JoonatanAlanampa/koti/docs/img/ds3231-bottom.jpg

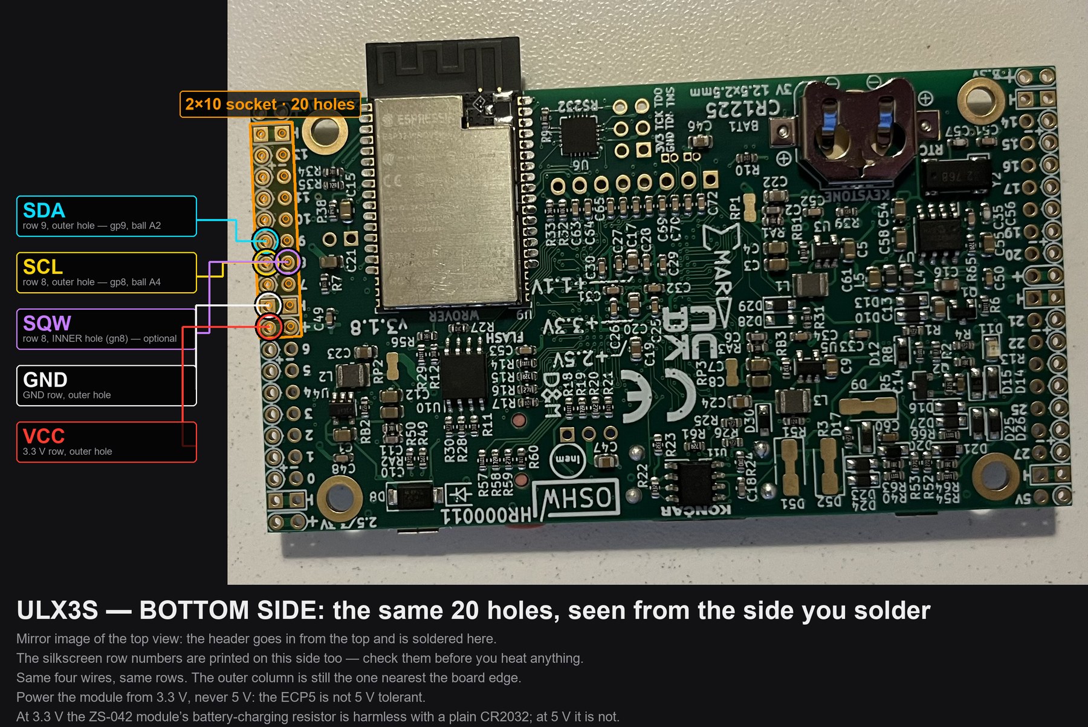
docs/img/ds3231-bottom.jpg
