JoonatanAlanampa/koti/docs/img/ds3231-top.jpg

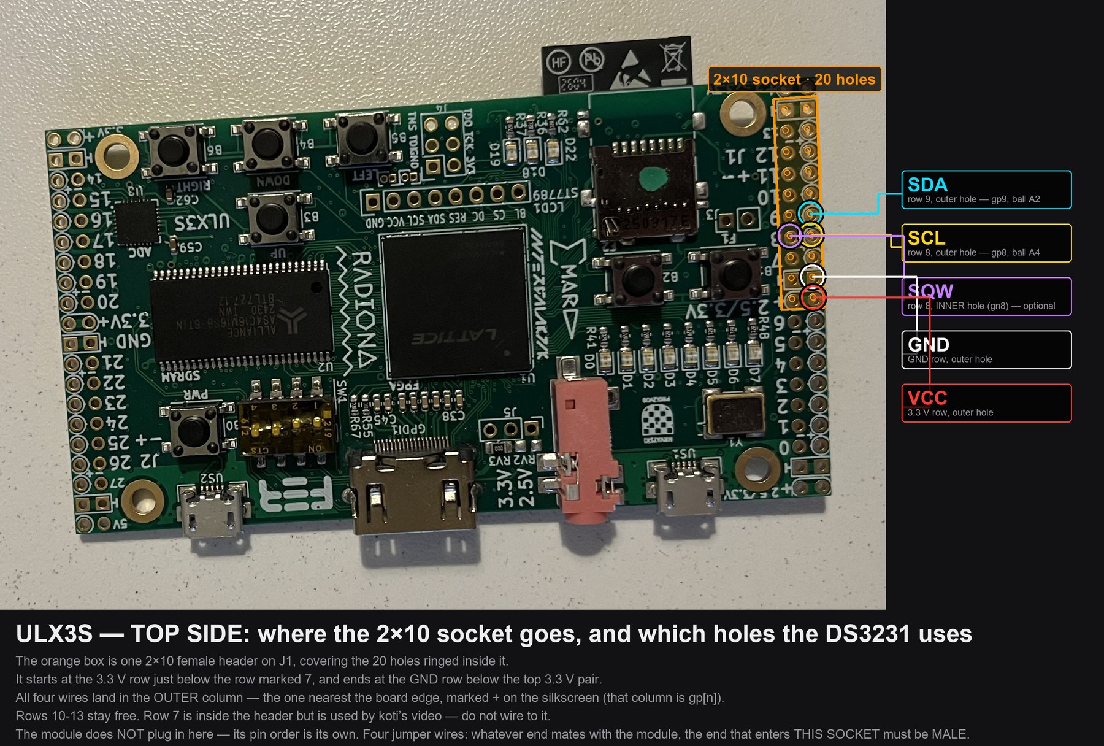
docs/img/ds3231-top.jpg
