JoonatanAlanampa/koti/src/koti_core.sv

// koti_core.sv — the Koti-1 ASIC core: RV32IMA + Zicsr + M-mode traps
// on the XIP memory interface. Merges the two proven lineages:
//   - fetch FSM + external data port + MMIO from tt-riscv's
//     rv32_core.sv (non-blocking pair fetch with skid buffer, fdrop on
//     redirect, whole-pipe freeze on data-port waits)
//   - muldiv, csr/trap, and AMO machinery from core/cpu_pipe.sv (which
//     stays behind as the FPGA/BRAM reference build)
//
// Memory map: flash 0x0000_0000+ (code+rodata, addr bit 24 = 0),
// PSRAM 0x0100_0000+ (bit 24 = 1). Core-internal MMIO carve-out at
// 0x0001_0000: +0 LED (w), +4 UART (w data / r busy), +8 GPIO in (r),
// +C QSPI_CFG (r/w). Anything else non-flash/PSRAM-shaped (CLINT at
// 0x0002_0000, PLIC, VGA regs) goes out the data port for the SoC top
// to decode and ack — the port protocol doesn't care who answers.
//
// Copyright (c) 2026 Joonatan Alanampa
// SPDX-License-Identifier: Apache-2.0

`default_nettype none

module koti_core #(
    parameter UART_DIV = 217
) (
    input  logic        clk,
    input  logic        rst,
    input  logic        mtip, msip, meip,
    input  logic        seip,       // S-level external, from the PLIC
    output logic        halted,
    output logic [7:0]  led,
    output logic        uart_txd,
    // ⭐ THE OTHER HALF, added 2026-08-09. Before this the console was
    // transmit-only and nothing could ever be typed at koti over a wire.
    input  wire         uart_rxd,
    input  logic [7:0]  gpio_in,
    output logic [1:0]  qspi_cfg,   // MMIO +C; resets 0 = 1-bit SPI

    // instruction fetch port (req held until 1-cycle ack); each fetch
    // returns an instruction PAIR: if_rdata = @addr, if_rdata2 = @addr+4
    output logic        if_req,
    output logic [23:0] if_addr,
    input  logic        if_ack,
    input  logic [31:0] if_rdata,
    input  logic [31:0] if_rdata2,

    // Fetch-port side-channels for an optional instruction cache (see
    // src/icache.sv). Both are pure observations of state this core already
    // keeps, so leaving them unconnected costs nothing.
    //   if_ptw       1 while the transaction on the fetch port is a PAGE TABLE
    //                read rather than an instruction fetch. A cache must not
    //                retain those: page tables are edited through the data port
    //                and retired by sfence.vma, which a physically-tagged
    //                instruction cache correctly does not flush on.
    //   icache_flush one cycle when a `fence.i` retires.
    output logic        if_ptw,
    output logic        icache_flush,

    //   d_ptw        the same thing for the DATA port: 1 while the transaction
    //                belongs to the EX-side page walker rather than to a load
    //                or a store. A data cache must not retain a PTE for exactly
    //                the reason above — page tables are retired by sfence.vma,
    //                which a physically-tagged cache correctly does not flush
    //                on, so a cached PTE would outlive the flush meant to kill
    //                it and the machine would translate through a stale entry.
    //                The walker only ever READS, so bypassing reads is enough.
    output logic        d_ptw,

    // data port (same protocol)
    output logic        d_req,
    output logic        d_we,
    output logic [23:0] d_addr,
    output logic [31:0] d_wdata,
    output logic [3:0]  d_be,
    input  logic        d_ack,
    input  logic [31:0] d_rdata
);

    // ---- forward declarations ----------------------------------------
    // Every signal below is used above the point it was originally
    // declared. Icarus 12 tolerated that; Icarus 14 does not ("Unable to
    // bind ... Check for declaration after use"), which meant koti's
    // simulations could not run on the oss-cad-suite toolchain installed
    // here AT ALL - every debug cycle had to go through a 14-minute CI
    // round trip. Declaring them here and leaving each expression exactly
    // where it was changes no logic.
    logic [19:0] dw_vpn;
    logic [19:0] iw_vpn;
    logic [4:0]  rs1_e, rs2_e, rd_e;
    wire        dw_fill;
    wire        dw_pte_fault;
    wire        iw_fill;
    wire        iw_pte_fault;
    wire [21:0] dw_fppn;
    wire [21:0] iw_fppn;
    wire [31:0] dpte;
    wire [31:0] ipte;
    wire [31:0] mem_word;

    // ================= F: fetch FSM + ITLB / i-walker =================
    logic [31:0] instr_d, pc_d;          // IF/ID
    logic        valid_d, ipf_d;         // ipf: poisoned fetch, traps at EX

    logic        stall, flush_ex;        // defined in D/E below
    logic        mstall;                 // data-port wait, defined in M below
    logic        md_stall;               // muldiv wait, defined in E below
    logic        astall;                 // AMO RMW wait, defined in M below
    logic        tlb_stall;              // DTLB walk wait, defined in E below
    wire         pstall = mstall || md_stall || astall || tlb_stall;
    logic [31:0] target_ex;
    logic        tlb_flush;              // sfence.vma / satp write (EX)
    logic        m_port_busy;            // M owns the data port (M below)
    // Who owns the data transaction currently in flight. Forward-declared
    // here because both consumers of it sit hundreds of lines apart and this
    // file is read by a simulator that rejects declare-after-use.
    logic        d_inflight, d_owner_dw;

    // MMU context from csr0 (instance in EX)
    logic [31:0] csr_satp;
    logic [1:0]  csr_priv;
    logic        csr_sum, csr_mxr;
    wire mmu_i_on = csr_satp[31] && csr_priv != 2'b11;

    logic        fbusy, fdrop;
    logic [31:0] fpc;                    // VA of the in-flight fetch
    logic [31:0] fpc_pa;                 // its translation (= fpc when off)
    logic [31:0] npc;                    // next VA to fetch
    logic [31:0] fbuf;                   // skid: second word of the pair
    logic        fbuf_v;

    // ITLB: looked up on npc while idle
    wire [19:0] i_vpn = npc[31:12];
    logic        itlb_hit;
    logic [21:0] itlb_ppn;
    logic        itlb_r, itlb_w, itlb_x, itlb_u, itlb_pd, itlb_f;
    tlb #(.N(2)) itlb0 (
        .clk(clk), .rst(rst), .flush(tlb_flush),
        .vpn(i_vpn), .hit(itlb_hit), .ppn(itlb_ppn),
        .p_r(itlb_r), .p_w(itlb_w), .p_x(itlb_x), .p_u(itlb_u),
        .p_d(itlb_pd), .p_fault(itlb_f),
        .fill(iw_fill), .f_vpn(iw_vpn), .f_ppn(iw_fppn),
        .f_r(ipte[1]), .f_w(ipte[2]), .f_x(ipte[3]), .f_u(ipte[4]),
        .f_d(ipte[7]), .f_fault(iw_pte_fault));

    // execute permission at current privilege (S never runs U pages)
    wire itlb_xfault = itlb_f || !itlb_x
                    || (csr_priv == 2'b00 && !itlb_u)
                    || (csr_priv == 2'b01 &&  itlb_u);

    // i-walker: two PTE reads through the fetch port (pair's first word).
    // Fills are path-independent, so a redirect mid-walk needs no abort:
    // the walk completes against its latched vpn and simply fills.
    logic [1:0]  iw_state;               // 0 idle, 1 level-1, 2 level-0
    logic [23:0] iw_addr;

    assign if_req  = fbusy || (iw_state != 2'd0);
    assign if_addr = (iw_state != 2'd0) ? iw_addr : fpc_pa[25:2];

    // Stable for the whole of any one transaction: a walk can only be started
    // from `iw_state == 0 && !fbusy`, and iw_state only advances on `if_ack`.
    assign if_ptw  = (iw_state != 2'd0);

    assign ipte = if_rdata;
    wire        ipte_bad = !ipte[0] || (!ipte[1] && ipte[2]);   // !V, W&!R
    wire        ipte_leaf = ipte[1] || ipte[3];                 // R or X
    wire        iw_l1 = if_ack && iw_state == 2'd1;
    wire        iw_l0 = if_ack && iw_state == 2'd2;
    assign iw_pte_fault = ipte_bad
                    || (iw_l1 && ipte_leaf && ipte[19:10] != 10'd0)
                    || (iw_l0 && !ipte_leaf)
                    || (ipte_leaf && !ipte[6]);                 // A = 0
    assign iw_fill = (iw_l1 && (ipte_bad || ipte_leaf)) || iw_l0;
    assign iw_fppn = iw_l1 ? {ipte[31:20], iw_vpn[9:0]}    // megapage
                                : ipte[31:10];

    wire advance = !halted && !pstall;
    wire consume = advance && valid_d && !stall && !flush_ex;

    always_ff @(posedge clk)
        if (rst) begin
            fbusy <= 1'b0; fdrop <= 1'b0;
            fpc   <= 32'd0; fpc_pa <= 32'd0; npc <= 32'd0;
            fbuf  <= 32'd0; fbuf_v <= 1'b0;
            valid_d <= 1'b0; pc_d <= 32'd0; instr_d <= 32'd0;
            ipf_d <= 1'b0;
            iw_state <= 2'd0; iw_vpn <= 20'd0; iw_addr <= 24'd0;
        end else begin
            if (consume) begin
                if (fbuf_v) begin       // promote the pair's second word
                    instr_d <= fbuf;
                    pc_d    <= pc_d + 32'd4;
                    fbuf_v  <= 1'b0;    // valid_d stays 1: no bubble
                end else
                    valid_d <= 1'b0;
            end

            if (iw_l1) begin
                if (ipte_bad || ipte_leaf)
                    iw_state <= 2'd0;   // filled (translation or fault)
                else begin
                    iw_addr  <= {ipte[23:10], iw_vpn[9:0]};   // level-0 PTE
                    iw_state <= 2'd2;
                end
            end else if (iw_l0)
                iw_state <= 2'd0;

            if (if_ack && iw_state == 2'd0) begin
                // a fetch is only in flight while head+skid are empty, so
                // delivery never collides with consume/promote
                fbusy <= 1'b0;
                fdrop <= 1'b0;
                if (!fdrop) begin
                    instr_d <= if_rdata;
                    pc_d    <= fpc;
                    valid_d <= 1'b1;
                    ipf_d   <= 1'b0;
                    fbuf    <= if_rdata2;
                    // A pair straddling a page boundary carries the wrong
                    // translation for its second word, so the second word is
                    // dropped. THEN npc MUST STEP BY ONE WORD, NOT TWO --
                    // otherwise the dropped instruction is never fetched at
                    // all and the machine silently executes fpc, then fpc+8.
                    //
                    // That was the bug that stopped Linux booting (found
                    // 2026-08-04). `npc <= fpc + 8` was unconditional, so
                    // every straddling pair skipped an instruction outright.
                    // It survived this long because npc normally steps by 8,
                    // which never changes fpc[2] -- so a straddle needs a
                    // fetch stream that is ODD-word aligned (fpc == 4 mod 8),
                    // which only happens after a redirect to a 4-mod-8 target
                    // that then runs to the end of its page. Linux hits it in
                    // kfree(): the retry edge is `jal zero,kfree+0xfc` and
                    // that target is 0x...ffc, the last word of a page, so
                    // EVERY pass dropped the next instruction -- the `lw a3,
                    // 4(a4)` that loads the SLUB tid. a3 kept a stale value,
                    // the tid compare in __update_cpu_freelist_fast could
                    // never match, and kfree spun forever with the console
                    // silent after "SLUB: HWalign=64".
                    //
                    // Invisible to every existing suite: it needs the MMU on
                    // (the 58 official tests run with satp = 0, where
                    // mmu_i_on is false and nothing is ever dropped) AND a
                    // 4-mod-8 entry that reaches a page end AND the skipped
                    // instruction to matter.
                    if (mmu_i_on && fpc[11:2] == 10'h3FF) begin
                        fbuf_v <= 1'b0;
                        npc    <= fpc + 32'd4;
                    end else begin
                        fbuf_v <= 1'b1;
                        npc    <= fpc + 32'd8;
                    end
                end
            end else if (iw_state == 2'd0 && !fbusy && !valid_d && !fbuf_v
                         && !halted && !pstall && !flush_ex) begin
                // !flush_ex: a redirect lands this same edge and rewrites
                // npc — starting now would fetch the stale wrong-path npc
                // (see rv32_core.sv for the full war story)
                // !pstall: never launch a fetch/ITLB walk while an older
                // stage is stalled — a satp write held behind a bus txn
                // could otherwise start an old-root walk that outlives the
                // flush at its commit edge (F2).
                if (!mmu_i_on) begin
                    fbusy <= 1'b1; fpc <= npc; fpc_pa <= npc;
                end else if (itlb_hit && !itlb_xfault) begin
                    fbusy  <= 1'b1; fpc <= npc;
                    fpc_pa <= {itlb_ppn[19:0], npc[11:0]};
                end else if (itlb_hit) begin
                    // execute fault: poison one NOP; EX takes the trap
                    instr_d <= 32'h0000_0013;
                    pc_d    <= npc;
                    valid_d <= 1'b1;
                    ipf_d   <= 1'b1;
                end else begin
                    iw_vpn   <= i_vpn;
                    iw_addr  <= {csr_satp[13:0], i_vpn[19:10]};
                    iw_state <= 2'd1;
                end
            end

            // redirect last: overrides a same-cycle delivery/promotion
            if (advance && flush_ex) begin
                valid_d <= 1'b0;
                ipf_d   <= 1'b0;
                fbuf_v  <= 1'b0;
                npc     <= target_ex;
                if (fbusy && !if_ack) fdrop <= 1'b1;
            end
        end

    // ================= D: decode + regfile read =================
    wire [4:0] rs1_d = instr_d[19:15];
    wire [4:0] rs2_d = instr_d[24:20];
    wire [4:0] rd_d  = instr_d[11:7];

    logic       c_reg_write, c_alu_b_src, c_mem_write, c_is_branch, c_is_jump;
    logic       c_is_md, c_is_sys, c_is_amo;
    logic [2:0] c_imm_sel;
    logic [1:0] c_alu_a_src, c_wb_src;
    logic [3:0] c_alu_op;
    control ctl (.opcode(instr_d[6:0]), .funct3(instr_d[14:12]),
                 .funct7b5(instr_d[30]), .funct7b0(instr_d[25]),
                 .is_muldiv(c_is_md), .is_amo(c_is_amo),
                 .reg_write(c_reg_write), .imm_sel(c_imm_sel),
                 .alu_a_src(c_alu_a_src), .alu_b_src(c_alu_b_src),
                 .alu_op(c_alu_op), .mem_write(c_mem_write), .wb_src(c_wb_src),
                 .is_branch(c_is_branch), .is_jump(c_is_jump),
                 .is_system(c_is_sys));

    // SYSTEM sub-decode (needs instr[31:20], which control never sees).
    // EBREAK halts the core in M-mode and TRAPS in S/U (see brk_take below);
    // ECALL traps (it is the SBI path); WFI and unknown SYSTEM encodings
    // are NOPs.
    wire [11:0] sys12 = instr_d[31:20];
    wire is_csr_d    = c_is_sys && instr_d[14:12] != 3'b000;
    wire is_ecall_d  = c_is_sys && instr_d[14:12] == 3'b000 && sys12 == 12'h000;
    wire is_ebreak_d = c_is_sys && instr_d[14:12] == 3'b000 && sys12 == 12'h001;
    wire is_mret_d   = c_is_sys && instr_d[14:12] == 3'b000 && sys12 == 12'h302;
    wire is_sret_d   = c_is_sys && instr_d[14:12] == 3'b000 && sys12 == 12'h102;
    wire is_sfence_d = c_is_sys && instr_d[14:12] == 3'b000
                     && instr_d[31:25] == 7'b0001001;   // sfence.vma

    // FENCE.I (MISC-MEM opcode, funct3=001). This was a NOP for as long as
    // nothing sat between the fetch port and memory, and harmlessly so. With
    // src/icache.sv in the path it becomes the instruction that makes code
    // written through the DATA port executable — a bootloader staging a kernel,
    // a module loader, a JIT — because a fetch-side cache cannot see those
    // stores. RISC-V puts that burden on software precisely so the hardware can
    // stay this simple, but only if the hardware honours the instruction.
    //
    // NOT privileged: legal in U-mode, unlike sfence.vma. So it gets its own
    // path rather than joining sfence_e, whose privilege check would trap it.
    wire is_fencei_d = instr_d[6:0] == 7'b0001111 && instr_d[14:12] == 3'b001;

    // instruction legality (coarse but covers what kernels probe:
    // unknown major opcodes, bad funct3/funct7 combos, bad SYSTEM
    // encodings; CSR existence/privilege is checked at EX)
    logic legal_d;
    always_comb begin
        legal_d = 1'b0;
        case (instr_d[6:0])
            7'b0110111, 7'b0010111, 7'b1101111: legal_d = 1'b1;  // U/J
            7'b1100111: legal_d = instr_d[14:12] == 3'b000;      // JALR
            7'b1100011: legal_d = instr_d[14:12] != 3'b010
                               && instr_d[14:12] != 3'b011;      // Bxx
            7'b0000011: legal_d = instr_d[14:12] <= 3'd2
                               || instr_d[14:12] == 3'd4
                               || instr_d[14:12] == 3'd5;        // loads
            7'b0100011: legal_d = instr_d[14:12] <= 3'd2;        // stores
            7'b0010011: legal_d =
                  (instr_d[14:12] == 3'b001) ? instr_d[31:25] == 7'd0
                : (instr_d[14:12] == 3'b101) ? (instr_d[31:25] == 7'd0
                                             || instr_d[31:25] == 7'h20)
                : 1'b1;                                          // OP-IMM
            7'b0110011: legal_d = instr_d[31:25] == 7'd0
                               || instr_d[31:25] == 7'h01
                               || (instr_d[31:25] == 7'h20
                                   && (instr_d[14:12] == 3'b000
                                    || instr_d[14:12] == 3'b101)); // OP/M
            7'b0001111: legal_d = 1'b1;                          // FENCE
            7'b0101111: legal_d = instr_d[14:12] == 3'b010
                && (instr_d[31:27] <= 5'd4 || instr_d[31:27] == 5'd8
                    || instr_d[31:27] == 5'd12
                    || (instr_d[31] && instr_d[28:27] == 2'b00)); // A
            7'b1110011: legal_d = (instr_d[14:12] != 3'b000
                                && instr_d[14:12] != 3'b100)     // CSRs
                || is_ecall_d || is_ebreak_d || is_mret_d
                || is_sret_d || is_sfence_d
                || sys12 == 12'h105;                             // WFI
            default: ;
        endcase
    end

    logic [31:0] imm_d;
    immgen ig (.instr(instr_d), .sel(c_imm_sel), .imm(imm_d));

    // regfile: written in W, read with a REGISTERED address — the
    // sync-read (read-first) timing of the tnt 32x32 RF macro, whose
    // instance replaces src/regfile.sv's body. The read output IS the
    // operand pipeline register (r1_e/r2_e are gone). While the pipe
    // is frozen the address mux re-selects the EX instruction's
    // registers so the output stays coherent with what EX is using;
    // W is frozen too, so the content cannot change mid-freeze.
    logic        reg_write_w, valid_w;
    logic [4:0]  rd_w;
    logic [31:0] wb_w, rf_r1, rf_r2;
    wire de_advance = !halted && !pstall;   // the ID/EX latch condition
    regfile rf (.clk(clk), .we(reg_write_w && valid_w && !halted),
                .waddr(rd_w), .wdata(wb_w),
                .raddr1(de_advance ? rs1_d : rs1_e),
                .raddr2(de_advance ? rs2_d : rs2_e),
                .rdata1(rf_r1), .rdata2(rf_r2));

    // WB -> ID bypass, latched into EX: the only write the edge-N
    // read misses (read-first) is the one landing at edge N itself —
    // a W writeback during the instruction's final D cycle. Writes on
    // earlier (stalled) D cycles are already inside the read.
    wire wb_hit1 = reg_write_w && valid_w && rd_w != 5'd0 && rd_w == rs1_d;
    wire wb_hit2 = reg_write_w && valid_w && rd_w != 5'd0 && rd_w == rs2_d;

    // ---- ID/EX ----
    logic        valid_e, reg_write_e, alu_b_src_e, mem_write_e;
    logic        is_branch_e, is_jump_e, is_md_e, is_amo_e;
    logic        ebreak_e, ecall_e, mret_e, sret_e, csr_e;
    logic        ipf_e, sfence_e, fencei_e, illegal_e;
    logic [31:0] instr_e;                // for mtval on illegal
    logic [4:0]  amo5_e;
    logic [1:0]  alu_a_src_e, wb_src_e;
    logic [3:0]  alu_op_e;
    logic [2:0]  funct3_e;
    logic        byp1_e, byp2_e;
    logic [31:0] pc_e, imm_e, bypv_e;

    // load-use: instruction in EX is a load whose rd the ID instruction reads
    wire is_load_e = valid_e && wb_src_e == 2'd1;
    assign stall = valid_d && is_load_e && rd_e != 5'd0
                && (rd_e == rs1_d || rd_e == rs2_d) && !flush_ex;

    always_ff @(posedge clk)
        if (rst) valid_e <= 1'b0;
        else if (!halted && !pstall) begin
            if (flush_ex || stall || !valid_d) valid_e <= 1'b0;   // bubble
            else begin
                valid_e     <= valid_d;
                reg_write_e <= c_reg_write; alu_b_src_e <= c_alu_b_src;
                mem_write_e <= c_mem_write; is_branch_e <= c_is_branch;
                is_jump_e   <= c_is_jump;
                is_md_e     <= c_is_md;
                ebreak_e    <= is_ebreak_d; ecall_e     <= is_ecall_d;
                mret_e      <= is_mret_d;   csr_e       <= is_csr_d;
                sret_e      <= is_sret_d;   sfence_e    <= is_sfence_d;
                fencei_e    <= is_fencei_d;
                ipf_e       <= ipf_d;
                illegal_e   <= !legal_d && !ipf_d;   // poison NOP is legal
                instr_e     <= instr_d;
                is_amo_e    <= c_is_amo;    amo5_e      <= instr_d[31:27];
                alu_a_src_e <= c_alu_a_src; wb_src_e    <= c_wb_src;
                alu_op_e    <= c_alu_op;    funct3_e    <= instr_d[14:12];
                rs1_e <= rs1_d; rs2_e <= rs2_d; rd_e <= rd_d;
                pc_e  <= pc_d;  imm_e <= imm_d;
                byp1_e <= wb_hit1; byp2_e <= wb_hit2; bypv_e <= wb_w;
            end
        end

    // ================= E: forward, execute, resolve =================
    logic        valid_m, reg_write_m, mem_write_m;
    logic [1:0]  wb_src_m;
    logic [4:0]  rd_m;
    logic [31:0] value_m;

    wire m_fwd1 = valid_m && reg_write_m && rd_m != 5'd0 && rd_m == rs1_e;
    wire m_fwd2 = valid_m && reg_write_m && rd_m != 5'd0 && rd_m == rs2_e;
    wire w_fwd1 = valid_w && reg_write_w && rd_w != 5'd0 && rd_w == rs1_e;
    wire w_fwd2 = valid_w && reg_write_w && rd_w != 5'd0 && rd_w == rs2_e;
    wire [31:0] base1 = byp1_e ? bypv_e : rf_r1;   // sync read + bypass
    wire [31:0] base2 = byp2_e ? bypv_e : rf_r2;
    wire [31:0] fwd1 = m_fwd1 ? value_m : w_fwd1 ? wb_w : base1;
    wire [31:0] fwd2 = m_fwd2 ? value_m : w_fwd2 ? wb_w : base2;

    logic [31:0] alu_a, alu_y;
    always_comb
        case (alu_a_src_e)
            2'd1:    alu_a = pc_e;
            2'd2:    alu_a = 32'd0;
            default: alu_a = fwd1;
        endcase
    wire [31:0] alu_b = alu_b_src_e ? imm_e : fwd2;
    alu ex (.op(alu_op_e), .a(alu_a), .b(alu_b), .y(alu_y));

    logic br_taken;
    branch_cmp bc (.funct3(funct3_e), .a(fwd1), .b(fwd2), .taken(br_taken));

    // RV32M: md_stall freezes the pipe until the iterative unit
    // delivers; the result rides EX/MEM and forwards normally
    logic        md_busy, md_done;
    logic [31:0] md_result;
    wire md_op  = valid_e && is_md_e && !illegal_e;
    wire md_ack = md_op && md_done && !mstall && !astall && !halted;
    assign md_stall = md_op && !md_done;
    muldiv md (.clk(clk), .rst(rst), .start(md_op), .ack(md_ack),
               .funct3(funct3_e), .a(fwd1), .b(fwd2),
               .result(md_result), .busy(md_busy), .done(md_done));

    // CSR file + trap/interrupt resolution, all at EX: older stages
    // always commit, so an EX-taken trap is precise. EX commands fire
    // only on the commit cycle (!pstall) — held across a stall they
    // would rewrite the MPIE/MIE stack. Never inject an irq onto an
    // in-flight muldiv (would orphan the unit).
    logic        csr_irq, csr_known;
    logic [31:0] csr_rval, csr_trap_vec, csr_mepc, csr_sepc;

    // ---- illegal instruction (cause 2): decode-level (illegal_e from
    // D) plus EX-level checks that need CSR/privilege context. An
    // illegal instruction must produce no side effects: it is excluded
    // from memory ops, muldiv, CSR writes, and branch redirects.
    wire csr_wen0 = (funct3_e[1:0] == 2'b01) || (rs1_e != 5'd0);
    wire csr_ill  = csr_e && (!csr_known
                 || imm_e[9:8] > csr_priv
                 || (csr_wen0 && imm_e[11:10] == 2'b11));  // RO CSR write
    wire ret_ill  = (mret_e && csr_priv != 2'b11)
                 || (sret_e && csr_priv == 2'b00)
                 || (sfence_e && csr_priv == 2'b00);
    wire ill_e    = illegal_e || csr_ill || ret_ill;

    // ---- sv32 data-side translation, at EX so traps stay precise and
    // stval gets the faulting VA ----
    wire mmu_d_on  = csr_satp[31] && csr_priv != 2'b11;   // (no MPRV)
    wire dmem_op_e = valid_e && !ill_e
                  && (mem_write_e || wb_src_e == 2'd1);

    // misaligned data address (4/6): lower priority than page faults
    wire dmis = dmem_op_e
             && ((funct3_e[1:0] == 2'b01 && alu_y[0])
              || (funct3_e[1:0] == 2'b10 && alu_y[1:0] != 2'b00));
    wire d_isstore = mem_write_e
                  || (is_amo_e && amo5_e != 5'b00010);    // SC/AMO: store pf

    wire [19:0] d_vpn = alu_y[31:12];
    logic        dtlb_hit;
    logic [21:0] dtlb_ppn;
    logic        dtlb_r, dtlb_w, dtlb_x, dtlb_u, dtlb_pd, dtlb_f;
    tlb #(.N(2)) dtlb0 (
        .clk(clk), .rst(rst), .flush(tlb_flush),
        .vpn(d_vpn), .hit(dtlb_hit), .ppn(dtlb_ppn),
        .p_r(dtlb_r), .p_w(dtlb_w), .p_x(dtlb_x), .p_u(dtlb_u),
        .p_d(dtlb_pd), .p_fault(dtlb_f),
        .fill(dw_fill), .f_vpn(dw_vpn), .f_ppn(dw_fppn),
        .f_r(dpte[1]), .f_w(dpte[2]), .f_x(dpte[3]), .f_u(dpte[4]),
        .f_d(dpte[7]), .f_fault(dw_pte_fault));

    wire dtlb_pfault = dtlb_f
        || (csr_priv == 2'b00 && !dtlb_u)
        || (csr_priv == 2'b01 &&  dtlb_u && !csr_sum)
        || (d_isstore ? (!dtlb_w || !dtlb_pd)             // D=0 store faults
                      : !(dtlb_r || (csr_mxr && dtlb_x)));
    wire d_xlate = dmem_op_e && mmu_d_on;
    assign tlb_stall = d_xlate && !dtlb_hit;              // walk in progress
    wire [31:0] d_pa = mmu_d_on ? {dtlb_ppn[19:0], alu_y[11:0]} : alu_y;

    // ---- physical access faults (PMA), on the resolved physical
    // address: writes to read-only flash and any access to the APS6404
    // 8 MiB high mirror (addr[24] && addr[23]). Device MMIO pages
    // (io_m 0x0001, CLINT 0x0002, PLIC 0x0003, VGA 0x0004) are writable;
    // everything else in flash space (addr[24]=0) is read-only XIP.
    // Device windows inside flash space: the four 64 KB carve-outs at
    // 0x0001..0x0004, plus the PLIC, which owns the TOP 4 MB
    // (0x00C0_0000..0x00FF_FFFF) because a register-compatible SiFive layout
    // puts its context registers at offset 0x200000. Without the second term
    // every PLIC write would be rejected as a write to read-only flash — and
    // reads would work, so it would look like a controller that accepts
    // configuration and then ignores it.
    //
    // ⚠️ ADDING AN MMIO WINDOW TAKES TWO EDITS, AND THIS IS THE SECOND ONE.
    // project.sv decodes the window; this decides whether a write to it is
    // legal. Miss this half and reads work while the first WRITE takes a store
    // access fault — which, with mtvec still 0 in early bare-metal code, jumps
    // to 0x00000000 and RESTARTS THE PROGRAM. The symptom is a machine that
    // prints its banner over and over, which looks like a reset problem and is
    // not one. The PLIC hit this first (see above); microSD hit it second,
    // 2026-08-07, and it cost a simulation round trip to recognise.
    // ⚠️ THE FLASH/MMIO HALF IS PA[25:24] == 00, NOT `!d_pa[24]`. The physical
    // map grew a bit on 2026-08-08 so that all 32 MB of the soldered SDRAM is
    // reachable (PLAN.md item 12): RAM is now PA 0x0100_0000..0x02FF_FFFF,
    // which spans BOTH PA[25:24] == 01 and == 10. Testing only PA[24] would
    // put the upper 16 MB of RAM back into the flash half, where every store
    // takes an access fault — with mtvec still 0 in early bare-metal code that
    // jumps to 0x00000000 and restarts the program, which is the "prints its
    // banner over and over" symptom this block's comment already warns about.
    wire pa_lowmap   = (d_pa[25:24] == 2'b00);
    // ⚠️ THE UPPER BOUND IS HALF OF A TWO-FILE EDIT. project.sv decodes the
    // MMIO windows; this decides whether a WRITE to one is legal. A window
    // added there and not here reads fine and takes a store fault on its first
    // write — which, with mtvec still 0, restarts the program and reads as a
    // reset bug. It has caught the PLIC, the microSD and the ESP32 link.
    // test/check_mmio.py now compares the two files so the fourth time (08,
    // sound) is the last time it can happen silently.
    wire pa_dev      = pa_lowmap && ((d_pa[23:16] >= 8'h01
                                   && d_pa[23:16] <= 8'h0A)   // 05 SD, 06 USB, 07 ESP32, 08 audio, 09 I2C/J1, 0A I2C/onboard RTC
                                  || d_pa[23:22] == 2'b11);
    wire pa_flash_ro = pa_lowmap && !pa_dev;

    // The RAM half is the board's soldered 32 MB SDRAM, and all of it is
    // genuinely reachable — project.sv hands sdram_ctrl {m_addr[23],
    // m_addr[21:0]}, a bijection from the two quarters PA[25:24] ∈ {01,10} onto
    // the part's 8M words, so every address in the window reaches a distinct
    // location and nothing mirrors.
    // ⚠️ PA[25:24] == 11 (0x0300_0000+) is NOT memory: it is past the end of the
    // part, and it is the only quarter left over. Faulting it is what keeps the
    // 32 MB change honest — without it, an address one bit too high would alias
    // silently onto real RAM, which is the exact failure that change existed to
    // remove rather than to relocate.
    // (Until 2026-08-08 this had a second arm for the ASIC build's 8 MiB QSPI
    // PSRAM, whose address space mirrored above 8 MiB. koti is FPGA-only now.)
    wire pa_ram_hi = (d_pa[25:24] == 2'b11);
    wire dacc_fault  = dmem_op_e
                    && ((d_isstore && pa_flash_ro) || pa_ram_hi);

    // d-walker: two PTE reads on the data port, issued only while the
    // M stage isn't mid-transaction (its op completes under d_seen).
    // Never aborted: irqs are gated on !pstall, and nothing older than
    // EX can flush it.
    logic [1:0]  dw_state;
    logic [23:0] dw_addr;
    wire dw_req  = (dw_state != 2'd0) && !m_port_busy;
    // ⛔ THE ACK BELONGS TO WHOEVER ISSUED THE TRANSACTION, not to whoever is
    // asking now. The data port's requester CAN change while a transaction is
    // outstanding: dw_req is `(dw_state != 0) && !m_port_busy`, so an M-stage
    // memory op appearing mid-walk WITHDRAWS the walker's request.
    //
    // With a zero-latency path that was harmless by coincidence — the address
    // followed the requester and so did the ack, so the walker's read was
    // simply abandoned and re-issued later. Anything that LATCHES the address
    // breaks the coincidence: a data cache is still servicing the walker's
    // PTE read, and a live `!dw_req` hands that PTE to the M stage as a load
    // result. The kernel then builds a translation out of someone else's data,
    // faults, walks again, and storms traps the moment the MMU comes on
    // (measured 2026-08-08: 100% of samples in handle_exception).
    //
    // ⚠️ This is the same shape as the arbiter's dropped-request deadlock —
    // a request signal that IS the requester's own live condition — and it was
    // latent here before any cache existed: the arbiter gives video absolute
    // priority and can delay a data ack, so the window is real even today,
    // just narrow enough never to have been hit.
    wire d_owner_is_dw = d_inflight ? d_owner_dw : dw_req;
    wire dw_ack  = d_ack && d_owner_is_dw;
    assign dpte = d_rdata;
    wire        dpte_bad = !dpte[0] || (!dpte[1] && dpte[2]);
    wire        dpte_leaf = dpte[1] || dpte[3];
    wire        dw_l1 = dw_ack && dw_state == 2'd1;
    wire        dw_l0 = dw_ack && dw_state == 2'd2;
    assign dw_pte_fault = dpte_bad
                    || (dw_l1 && dpte_leaf && dpte[19:10] != 10'd0)
                    || (dw_l0 && !dpte_leaf)
                    || (dpte_leaf && !dpte[6]);           // A = 0
    assign dw_fill = (dw_l1 && (dpte_bad || dpte_leaf)) || dw_l0;
    assign dw_fppn = dw_l1 ? {dpte[31:20], dw_vpn[9:0]}
                                : dpte[31:10];

    always_ff @(posedge clk)
        if (rst) begin
            dw_state <= 2'd0; dw_vpn <= 20'd0; dw_addr <= 24'd0;
        end else if (dw_state == 2'd0) begin
            if (d_xlate && !dtlb_hit && !halted) begin
                dw_vpn   <= d_vpn;
                dw_addr  <= {csr_satp[13:0], d_vpn[19:10]};
                dw_state <= 2'd1;
            end
        end else if (dw_l1) begin
            if (dpte_bad || dpte_leaf)
                dw_state <= 2'd0;
            else begin
                dw_addr  <= {dpte[23:10], dw_vpn[9:0]};
                dw_state <= 2'd2;
            end
        end else if (dw_l0)
            dw_state <= 2'd0;

    wire take_ex = valid_e && !ill_e
                && (is_jump_e || (is_branch_e && br_taken));

    // ---- traps: EX commands fire only on the commit cycle.
    // Priority: irq > ipf > illegal > ecall > misaligned fetch target
    // > data page fault > data misalign (page faults outrank misalign
    // per the privileged spec's exception priority table).
    wire commit    = !pstall && !halted;
    wire irq_take  = valid_e && csr_irq && !is_md_e && commit;
    wire ipf_take  = valid_e && ipf_e && !irq_take && commit;
    wire ill_take  = valid_e && ill_e && !irq_take && commit;
    wire ecl_take  = valid_e && ecall_e && !irq_take && commit;
    wire imis_take = take_ex && alu_y[1] && !irq_take && commit;
    wire dpf_take  = d_xlate && dtlb_hit && dtlb_pfault
                  && !irq_take && commit;
    wire dmis_take = dmis && !dpf_take && !irq_take && commit;
    // access fault: only once misalign and page fault are ruled out
    wire dacc_take = dacc_fault && !dmis_take && !dpf_take && !irq_take
                  && commit;

    // EBREAK is SPLIT BY PRIVILEGE, and the split is the whole point.
    //
    // In M-mode it halts, exactly as it always has. Everything bare-metal on
    // this machine depends on that and none of it changes: sw/crt0.S ends a
    // program with it, sw/sbi/sbi.c implements SBI SRST *as* an ebreak (so
    // "system reset" is literally the core stopping), and every test in
    // test/ means "run until EBREAK" by "the program finished".
    //
    // In S/U it now raises a Breakpoint exception, cause 3, which is what the
    // ISA says an ebreak does anywhere. Halting was fine while nothing but our
    // own firmware ran here; it stops being fine the moment Linux does.
    // RISC-V Linux does not use ebreak for debuggers — it compiles every
    // WARN_ON() and BUG_ON() into an ebreak plus a __bug_table entry holding
    // the file and line, and expects do_trap_break() to look the PC up in that
    // table, print, and for a WARN *step past the ebreak and carry on*. A
    // WARN is a complaint the kernel is meant to survive. The 6.12 image koti
    // boots carries 2812 of those sites.
    //
    // So before this, the first WARN anywhere in the kernel stopped the
    // machine — and because the firmware's clean shutdown is ALSO an ebreak,
    // test/tb_boot.v could not tell that apart from a successful poweroff and
    // reported it as PASS. A silent death that reads as a green run is the
    // worst failure mode available, which is why this is worth a trap path.
    //
    // M-mode deliberately does NOT trap, though the ISA would have it trap
    // there too: there is no debug module to take it, the firmware's own
    // handler has no case for cause 3, and trapping would turn the shutdown
    // path into a loop. Deviating in the one mode where nothing can service
    // the exception is the honest trade.
    wire ebreak_halt_e = valid_e && ebreak_e && csr_priv == 2'b11;
    wire brk_take      = valid_e && ebreak_e && csr_priv != 2'b11
                      && !irq_take && commit;

    wire trap_take = irq_take || ipf_take || ill_take || ecl_take
                  || imis_take || dpf_take || dmis_take || dacc_take
                  || brk_take;
    wire mret_take = valid_e && mret_e && commit && !trap_take;
    wire sret_take = valid_e && sret_e && commit && !trap_take;
    wire sfence_take = valid_e && sfence_e && commit && !trap_take;

    // fence.i: invalidate the instruction cache AND serialize fetch. Both
    // halves are needed. Without the invalidate the cache keeps stale code;
    // without the redirect the pair already sitting in the skid buffer — and
    // the pair in flight — are pre-fence copies that would retire after it.
    // sfence.vma has needed exactly this treatment since F2, so this reuses
    // the same proven mechanism rather than inventing a second one.
    wire fencei_take = valid_e && fencei_e && commit && !trap_take;
    assign icache_flush = fencei_take;

    // brk_take sits below ipf for the usual reason — an instruction whose own
    // fetch page-faulted was never really there to be an ebreak — and above
    // the data faults, which an ebreak cannot raise anyway (it is neither a
    // branch nor a memory op, so imis/dpf/dmis/dacc are all impossible
    // alongside it). Its position relative to ecall never matters: the two are
    // mutually exclusive by decode, sys12 12'h001 against 12'h000.
    wire [3:0]  trap_kind = ipf_take  ? 4'd1
                          : ill_take  ? 4'd4
                          : brk_take  ? 4'd10
                          : imis_take ? 4'd5
                          : dpf_take  ? (d_isstore ? 4'd3 : 4'd2)
                          : dmis_take ? (d_isstore ? 4'd7 : 4'd6)
                          : dacc_take ? (d_isstore ? 4'd9 : 4'd8)
                          :             4'd0;
    // A breakpoint writes *tval with the address of the EBREAK itself, per the
    // privileged spec. Linux does not read it — do_trap_break() finds its bug
    // table entry from regs->epc — but a wrong tval is the kind of thing that
    // is only ever discovered by whatever needs it next.
    wire [31:0] trap_tval = ipf_take  ? pc_e
                          : ill_take  ? instr_e
                          : brk_take  ? pc_e
                          : imis_take ? {alu_y[31:1], 1'b0}
                          : (dpf_take || dmis_take || dacc_take) ? alu_y
                          :             32'd0;

    wire csr_en  = valid_e && csr_e && !ill_e && !irq_take && commit;
    wire csr_wen = csr_wen0;
    wire [31:0] csr_wval = funct3_e[2] ? {27'd0, rs1_e} : fwd1;

    // a satp write serializes fetch exactly like sfence.vma: flush the
    // TLBs AND redirect so no instruction fetched under the old root can
    // retire under the new translation (F2).
    wire satp_take = csr_en && csr_wen && imm_e[11:0] == 12'h180;
    assign tlb_flush = sfence_take || satp_take;

    csr csr0 (.clk(clk), .rst(rst),
              .retire(valid_w && !pstall && !halted),
              .en(csr_en), .op(funct3_e[1:0]), .wen(csr_wen),
              .addr(imm_e[11:0]), .wval(csr_wval), .rval(csr_rval),
              .trap(trap_take), .trap_irq(irq_take), .trap_kind(trap_kind),
              .trap_pc(pc_e), .trap_tval(trap_tval),
              .mret(mret_take), .sret(sret_take),
              .mtip(mtip), .msip(msip), .meip(meip), .seip_pin(seip),
              .irq(csr_irq), .trap_vec(csr_trap_vec),
              .mepc_rd(csr_mepc), .sepc_rd(csr_sepc),
              .satp_rd(csr_satp), .priv_rd(csr_priv),
              .sum_rd(csr_sum), .mxr_rd(csr_mxr), .known(csr_known));

    assign flush_ex  = (take_ex && !imis_take) || trap_take || mret_take
                     || sret_take || satp_take
                     || sfence_take || fencei_take || ebreak_halt_e;
    assign target_ex = trap_take             ? csr_trap_vec
                     : mret_take             ? csr_mepc
                     : sret_take             ? csr_sepc
                     : satp_take             ? pc_e + 32'd4  // serialize
                     : sfence_take           ? pc_e + 32'd4  // serialize
                     : fencei_take           ? pc_e + 32'd4  // serialize
                     : ebreak_halt_e         ? pc_e          // spin + drain
                     : {alu_y[31:1], 1'b0};

    // ---- EX/MEM ----
    logic [2:0]  funct3_m;
    logic [31:0] st_m;
    logic        halt_m, is_amo_m;
    logic [4:0]  amo5_m;
    always_ff @(posedge clk)
        if (rst) valid_m <= 1'b0;
        else if (!halted && !pstall) begin
            valid_m     <= valid_e && !trap_take;
            reg_write_m <= reg_write_e;
            mem_write_m <= mem_write_e;
            wb_src_m    <= wb_src_e;
            funct3_m    <= funct3_e;
            rd_m        <= rd_e;
            st_m        <= fwd2;                          // store data, forwarded
            // NOT `valid_e && ebreak_e`. An S/U ebreak sets trap_take, which
            // squashes the instruction one line above — but halt_m is a
            // separate latch, so without the privilege term the core would
            // take the breakpoint trap AND halt, and halting wins.
            halt_m      <= ebreak_halt_e;
            is_amo_m    <= is_amo_e; amo5_m <= amo5_e;
            value_m     <= csr_e              ? csr_rval
                         : is_md_e            ? md_result
                         : (wb_src_e == 2'd2) ? pc_e + 32'd4   // JAL/JALR link
                         : dmem_op_e          ? d_pa           // translated
                                              : alu_y;
        end

    // ================= M: memory + MMIO =================
    wire is_load_m = valid_m && wb_src_m == 2'd1;
    wire [31:0] addr_m   = value_m;
    wire [1:0]  off_m    = addr_m[1:0];
    wire [31:0] st_data  = st_m << (8 * off_m);
    logic [3:0] be_m;
    always_comb
        case (funct3_m[1:0])
            2'b00:   be_m = 4'b0001 << off_m;
            2'b01:   be_m = 4'b0011 << off_m;
            default: be_m = 4'b1111;
        endcase

    // core-internal MMIO carve-out at 0x0001_0000 (inside the flash
    // window: keep code+rodata below 64 KB). CLINT/PLIC/VGA registers
    // live higher (0x0002_0000+) and go out the data port; the SoC
    // top decodes and acks them. Decode the FULL 64 KB window
    // (addr[31:16]==0x0001) — a partial 3-bit compare aliased flash data
    // past 64 KB into this carve-out every 512 KB (F1).
    wire io_m = addr_m[31:16] == 16'h0001;

    // ---- A extension: LR/SC bookkeeping + AMO read-modify-write.
    // AMOs to the MMIO carve-out are meaningless and skipped.
    wire lr_m  = valid_m && is_amo_m && amo5_m == 5'b00010;
    wire sc_m  = valid_m && is_amo_m && amo5_m == 5'b00011;
    wire rmw_m = valid_m && is_amo_m && !io_m && amo5_m != 5'b00010
                                             && amo5_m != 5'b00011;

    logic        res_valid, amo_wr;      // amo_wr: RMW write-back phase
    logic [31:0] res_addr, old_q;
    wire sc_ok = res_valid && (res_addr == addr_m);

    logic [31:0] amo_new;
    always_comb
        case (amo5_m)
            5'b00000: amo_new = old_q + st_m;                    // ADD
            5'b00001: amo_new = st_m;                            // SWAP
            5'b00100: amo_new = old_q ^ st_m;                    // XOR
            5'b01000: amo_new = old_q | st_m;                    // OR
            5'b01100: amo_new = old_q & st_m;                    // AND
            5'b10000: amo_new = ($signed(old_q) < $signed(st_m))
                                ? old_q : st_m;                  // MIN
            5'b10100: amo_new = ($signed(old_q) < $signed(st_m))
                                ? st_m : old_q;                  // MAX
            5'b11000: amo_new = (old_q < st_m) ? old_q : st_m;   // MINU
            5'b11100: amo_new = (old_q < st_m) ? st_m : old_q;   // MAXU
            default:  amo_new = st_m;
        endcase

    // external transactions freeze the entire pipeline until ack; an
    // ack landing while frozen by md/astall is captured (d_seen) so
    // the dropped-req rule can't re-issue the transaction. RMW read
    // data goes to old_q instead — the write phase needs a fresh
    // transaction.
    logic        d_seen;
    logic [31:0] d_data_r;
    wire d_active = valid_m && !io_m && (mem_write_m || is_load_m)
                 && !halted && !d_seen && !(sc_m && !sc_ok);
    assign m_port_busy = d_active;
    // Routed by the LATCHED owner — see the block at dw_ack above.
    wire m_ack_here = d_ack && !d_owner_is_dw;
    always_ff @(posedge clk)
        if (rst) begin
            d_inflight <= 1'b0;
            d_owner_dw <= 1'b0;
        end else if (d_ack) begin
            d_inflight <= 1'b0;
        end else if (d_req && !d_inflight) begin
            d_inflight <= 1'b1;
            d_owner_dw <= dw_req;
        end
    assign mstall = d_active && !m_ack_here;
    // port muxes: the EX-side page walker borrows the port only while
    // the M stage is quiet
    assign d_req   = (d_active && !m_ack_here) || dw_req;
    assign d_ptw   = dw_req;
    assign d_we    = !dw_req && (mem_write_m || amo_wr || (sc_m && sc_ok));
    assign d_addr  = dw_req ? dw_addr : addr_m[25:2];
    assign d_wdata = amo_wr ? amo_new : st_data;
    assign d_be    = be_m;

    wire wr_ok = d_active && d_ack;

    always_ff @(posedge clk)
        if (rst) d_seen <= 1'b0;
        else begin
            if (d_active && d_ack && !rmw_m) begin
                d_data_r <= d_rdata;
                d_seen   <= 1'b1;
            end
            // An RMW is finished the moment its WRITE is acked, and it has to
            // say so through the same latch — see the livelock note below.
            // d_data_r takes old_q because that is the AMO's architectural
            // result: rd gets the value that was in memory BEFORE the write.
            if (amo_wr && wr_ok) begin
                d_data_r <= old_q;
                d_seen   <= 1'b1;
            end
            if (!halted && !pstall) d_seen <= 1'b0;   // M advanced
        end

    // ---- the AMO livelock, found by booting Linux (2026-08-04) -------------
    //
    // `astall` used to be `rmw_m && !halted && !(amo_wr && wr_ok)`, i.e. the
    // RMW released the pipeline only on the single cycle its write was acked.
    // If ANY OTHER stall was up on that cycle the instruction did not advance,
    // `amo_wr` cleared, and the read-modify-write started again from the top —
    // forever. And the other stall was not hypothetical:
    //
    //   M holds an AMO, so d_active is high, so m_port_busy is high.
    //   EX holds the next memory instruction, which misses the 2-entry DTLB
    //   under sv32, so tlb_stall is high, so pstall is high.
    //   The page-table walker takes the data port only when M is quiet
    //   (dw_req = state != 0 && !m_port_busy), and M is never quiet because
    //   the AMO keeps restarting.
    //
    // Each waits for the other. Linux hits it in boot_cpu_init — the
    // `amoor.w` in set_cpu_possible() — about 40 instructions before it would
    // have printed its banner, so the machine hangs with nothing on the
    // console. It is NOT specific to the FPGA build or the I-cache: any build
    // with the MMU on can reach it, and the reason it was never seen is that
    // the 58 official tests include rv32ua but run with satp = 0, and the
    // directed sv32 tests contain no atomics.
    //
    // The fix is to let the RMW latch "done" the way every other memory access
    // already does. d_seen then deasserts d_active, which frees the port, which
    // lets the walker run, which clears tlb_stall, which retires the AMO.
    //
    // Note it releases on `d_seen` and NOT on `d_seen || (amo_wr && wr_ok)`,
    // so an AMO always takes one more cycle than it strictly must. That is
    // deliberate and it is cheaper than it sounds: retiring on the ack cycle
    // means the writeback reads mem_word while d_seen is still 0, so mem_word
    // has to mux old_q in on the load datapath — a 32-bit mux in front of the
    // load shifter, which measured 691 LUTs and 3.4 MHz of Fmax on the ECP5.
    // Going through d_seen for one cycle costs one clock per atomic instead,
    // and removes the only path on which an AMO's result came off d_rdata
    // during a WRITE acknowledgement — a value no memory controller promises.
    assign astall = rmw_m && !halted && !d_seen;

    always_ff @(posedge clk)
        if (rst) amo_wr <= 1'b0;
        // Cleared unconditionally on the write ack, not only while rmw_m holds:
        // gating it on `!d_seen` below would leave it set into the NEXT
        // instruction, which would then start in its write phase.
        else if (amo_wr && wr_ok) amo_wr <= 1'b0;
        else if (rmw_m && !halted && !amo_wr && !mstall && !d_seen) begin
            old_q  <= mem_word;
            amo_wr <= 1'b1;
        end

    always_ff @(posedge clk)
        if (rst) res_valid <= 1'b0;
        else begin
            if (lr_m && !halted && !pstall) begin
                res_valid <= 1'b1;
                res_addr  <= addr_m;
            end
            if ((!halted && !pstall && valid_m
                 && (sc_m || mem_write_m || rmw_m)) || trap_take)
                res_valid <= 1'b0;                     // clear wins
        end

    // I/O sub-decode: +0 LED, +4 UART TX, +8 GPIO in, +C QSPI_CFG, +10 UART RX
    //
    // ⚠️ `io_hi_m` GATES THE FOUR BELOW, and that is not optional. They decode
    // on bits [3:2] alone, so before this existed the address 0x1_0010 had
    // [3:2] == 00 and therefore WROTE THE LED. Adding a register at +0x10
    // without this line would have made every UART-RX access quietly hit
    // another device — the same partial-compare aliasing PLAN.md records as
    // finding F1 on the flash window.
    wire io_hi_m   = addr_m[4];
    wire io_gpio_m = addr_m[3];
    wire io_uart_m = addr_m[2];
    always_ff @(posedge clk)
        if (rst)                                              led <= 8'd0;
        else if (mem_write_m && valid_m && io_m && !io_hi_m && !io_gpio_m
                 && !io_uart_m && !halted)                    led <= st_data[7:0];

    // QSPI_CFG resets to 0 (plain SPI) so the chip always boots
    always_ff @(posedge clk)
        if (rst)                                              qspi_cfg <= 2'b00;
        else if (mem_write_m && valid_m && io_m && !io_hi_m && io_gpio_m
                 && io_uart_m && !halted)                     qspi_cfg <= st_data[1:0];

    logic uart_busy;
    uart_tx #(.DIV(UART_DIV)) u0
        (.clk(clk), .rst(rst),
         .wr(mem_write_m && valid_m && io_m && !io_hi_m && !io_gpio_m
             && io_uart_m && !halted),
         .data(st_data[7:0]), .tx(uart_txd), .busy(uart_busy));

    // ---- UART RECEIVE, MMIO +0x10: {ovf, avail, data[7:0]} ----------------
    // ⛔ IT IS A SEPARATE ADDRESS FROM +0x04 ON PURPOSE. Reading this POPS, and
    // +0x04 is polled in a tight loop by uart_putc (`while (UART & 1)`) to wait
    // for the transmitter. Folding receive into that register would make every
    // busy-poll eat an incoming byte — a status check with a side effect, which
    // src/usb_kbd.sv already carries a warning about for the same reason.
    //
    // ⭐ AND IT HAS AN OVERRUN BIT, unlike the PS/2 block this project regrets
    // (see project.sv): a byte arriving before software took the last one is
    // recorded rather than silently dropped. Without that a receiver that falls
    // behind looks identical to a line that went quiet.
    logic [7:0] rx_byte;
    logic       rx_avail, rx_ovf;
    wire [7:0]  rx_data_w;
    wire        rx_valid_w, rx_frame_w;

    uart_rx #(.DIV(UART_DIV)) u1
        (.clk(clk), .rst(rst), .rx_pin(uart_rxd),
         .data(rx_data_w), .valid(rx_valid_w), .frame_err(rx_frame_w));

    // A load from +0x10 takes the byte. `is_load_m` is the same qualifier the
    // read mux below uses, so the pop and the value can never disagree.
    wire rx_pop = is_load_m && valid_m && io_m && io_hi_m && !halted && !pstall;

    always_ff @(posedge clk)
        if (rst) begin
            rx_byte <= 8'd0; rx_avail <= 1'b0; rx_ovf <= 1'b0;
        end else begin
            if (rx_valid_w) begin
                rx_byte  <= rx_data_w;
                rx_avail <= 1'b1;
                // Arriving on top of an untaken byte is an overrun. Keep the
                // NEWEST: a stale byte is worse than a missing one on a console.
                if (rx_avail && !rx_pop) rx_ovf <= 1'b1;
            end else if (rx_pop) begin
                rx_avail <= 1'b0;
                rx_ovf   <= 1'b0;      // sticky until read, like usb_kbd's
            end
        end

    wire [31:0] uart_rx_rd = {22'd0, rx_ovf, rx_avail, rx_byte};
    wire _unused_frame = &{rx_frame_w, 1'b0};

    // loads: external word through the byte-extension path
    // An RMW always retires with d_seen set (see astall), and d_data_r then
    // holds old_q — so an AMO's rd comes from the left arm here, and never
    // from whatever a controller drives on the read bus while acknowledging a
    // write.
    assign mem_word = d_seen ? d_data_r : d_rdata;
    wire [31:0] ld_shift = mem_word >> (8 * off_m);
    logic [31:0] ld_ext;
    always_comb
        case (funct3_m)
            3'b000:  ld_ext = {{24{ld_shift[7]}},  ld_shift[7:0]};
            3'b001:  ld_ext = {{16{ld_shift[15]}}, ld_shift[15:0]};
            3'b100:  ld_ext = {24'd0, ld_shift[7:0]};
            3'b101:  ld_ext = {16'd0, ld_shift[15:0]};
            default: ld_ext = mem_word;
        endcase

    // ---- MEM/WB ----
    logic halt_w;
    always_ff @(posedge clk)
        if (rst) begin
            valid_w <= 1'b0; halt_w <= 1'b0;
        end else if (!halted && !pstall) begin
            valid_w     <= valid_m;
            reg_write_w <= reg_write_m;
            rd_w        <= rd_m;
            halt_w      <= halt_m;
            wb_w        <= rmw_m ? old_q                   // AMO: old value
                         : sc_m  ? {31'd0, !sc_ok}         // SC: 0 = success
                         : is_load_m
                         ? (io_m ? (io_hi_m ? uart_rx_rd
                                    : (io_gpio_m ? (io_uart_m ? {30'd0, qspi_cfg}
                                                              : {24'd0, gpio_in})
                                                 : {31'd0, uart_busy}))
                                 : ld_ext)                 // LR rides ld_ext
                         : value_m;
        end

    // ================= W: writeback + halt =================
    always_ff @(posedge clk)
        if (rst)                       halted <= 1'b0;
        else if (valid_w && halt_w)    halted <= 1'b1;
endmodule
