JoonatanAlanampa/koti/src/esp_uart.sv

// SPDX-FileCopyrightText: © 2026 Joonatan Alanampa
// SPDX-License-Identifier: Apache-2.0
//
// esp_uart.sv — a SECOND serial port, wired to the onboard ESP32, plus the two
// strap pins that decide whether the ESP32 is running at all.
//
// This is the first piece of PLAN item 11 (networking). koti has no network
// stack and no MAC; the cheapest link it could ever have is the ESP32 that is
// already soldered to this board, reached over a UART on its own dedicated
// pins. That is what this is.
//
// ⛔ IT DOES NOT WAKE THE ESP32, AND THAT IS THE WHOLE POINT OF THE DESIGN.
// `esp_en` resets to 0, which is exactly what ulx3s_top.sv drove
// unconditionally before this existed, so a board loaded with this bitstream
// behaves at power-on precisely as it did. Waking the chip is a decision
// software takes, deliberately, at a moment of its choosing — and can undo.
//
// ⚠️ WHY THAT MATTERS MORE THAN IT LOOKS: THE ESP32's GPIOs ARE THE MICROSD
// BUS. Upstream's own constraint file says so, and ulx3s_top.sv repeats it:
//     sd_clk = GPIO14   sd_cmd = GPIO15   sd_d[0] = GPIO2
//     sd_d[1] = GPIO4   sd_d[2] = GPIO12  sd_d[3] = GPIO13
// koti loads its kernel off that card and may have its root filesystem on it.
// An ESP32 out of reset is a second driver on those six wires. Whether it
// actually drives them depends on the firmware it boots — which is an
// EXPERIMENT, not something to assume in either direction, and making the
// enable a register is what makes that experiment cost one bitstream instead
// of one per guess.
//
// Registers (word addresses, reg_a = d_addr[1:0]):
//   +0x00  W  transmit byte (low 8 bits). Ignored while `tx_busy`.
//          R  {ovf, avail, data[7:0]} — ⚠️ READING POPS when `avail` is set.
//   +0x04  R  status: bit0 tx_busy, bit1 rx_avail, bit2 rx_ovf,
//             bits 9:3 = how many bytes are queued (0..64).
//             ⚠️ Reading it CLEARS rx_ovf — see the note at the FIFO. It does
//             not pop, so it is still safe to ask "is a byte waiting".
//   +0x08  RW control: bit0 esp_en (drives wifi_en), bit1 esp_gpio0
//   +0x0C  R  received-byte count since reset, free-running, no side effects
//
// 🪤 STATUS AND DATA ARE SEPARATE REGISTERS, and this repo has the scar to
// prove it is not fussiness: src/usb_kbd.sv carries the same warning because a
// first draft had `usb_kbd_present()` read the popping register — a status
// check that silently ate the keystroke it was asked about. A caller that
// wants to know whether a byte is waiting reads +0x04 and nothing changes.

module esp_uart #(
    parameter int DIV = 217              // 115200 8N1 at 25 MHz
) (
    input  wire         clk,
    input  wire         rst,

    // MMIO, the same select/ack contract as sd_ctrl and usb_kbd: `sel` is the
    // select cycle, the SoC returns the ack one clock later.
    input  wire         sel,
    input  wire         we,
    input  wire [1:0]   reg_a,
    input  wire [31:0]  wdata,
    output logic [31:0] rdata,

    // The pins. ⚠️ NAMED FROM THE ESP32's POINT OF VIEW, as upstream names
    // them, because that is what the constraint file says and renaming them
    // locally is how a board ends up neither sending nor receiving:
    //   wifi_rxd (K3) is what the ESP32 RECEIVES — we drive it
    //   wifi_txd (K4) is what the ESP32 TRANSMITS — we read it
    output wire         esp_rxd,         // -> wifi_rxd, our transmitter
    input  wire         esp_txd,         // <- wifi_txd, our receiver

    // The two strap pins, driven from the control register.
    output logic        esp_en,          // -> wifi_en   (J5 on v3.1.x)
    output logic        esp_gpio0,       // -> wifi_gpio0 (F1 on v3.1.x)

    // Level, into the PLIC. High while the receive FIFO holds anything.
    output wire         rx_irq
);

    // ---- the serial halves, both reused verbatim ---------------------------
    // Deliberately the SAME modules the console uses rather than a second
    // implementation: uart_rx.sv is mutation-tested (edge sampling, start-bit
    // validation, stop bit) and a private copy would start identical and drift.
    // ---- the transmit FIFO -------------------------------------------------
    // ⛔ THE TRANSMITTER NEEDS ONE FOR THE SAME REASON THE RECEIVER DOES, and
    // the reason is a property of the DRIVER, not of the wire. Linux's serial
    // core calls `start_tx` with the port lock held and interrupts disabled.
    // With a one-byte transmitter the driver's only options there are to spin
    // until each byte goes out — 26 ms for a 300-byte SLIP frame, with
    // interrupts OFF, which overflows the 64-byte receive FIFO four times over
    // — or to poll from a timer, which at 87 us per byte means an 11.5 kHz
    // wakeup on a 25 MHz core. Both are unusable. A FIFO plus a "there is room"
    // interrupt is what lets the driver hand over a burst and return.
    localparam int TXDEPTH = 64;
    localparam int TXPTRW  = $clog2(TXDEPTH);

    logic [7:0]         txf [0:TXDEPTH-1];
    logic [TXPTRW:0]    twptr, trptr;
    wire tx_empty = (twptr == trptr);
    wire tx_full  = (twptr[TXPTRW-1:0] == trptr[TXPTRW-1:0])
                    && (twptr[TXPTRW] != trptr[TXPTRW]);
    wire [TXPTRW:0] tx_level = twptr - trptr;

    logic tx_busy;
    wire  tx_wr = sel && we && (reg_a == 2'd0) && !tx_full;

    // Hand the next byte to the shifter the moment it is idle and the queue is
    // not empty. `tx_go` is one clock wide because uart_tx latches on `wr`.
    wire tx_go = !tx_busy && !tx_empty && !tx_start_q;
    logic tx_start_q;

    always_ff @(posedge clk)
        if (rst) begin
            twptr <= '0; trptr <= '0; tx_start_q <= 1'b0;
        end else begin
            tx_start_q <= tx_go;
            if (tx_wr) begin
                txf[twptr[TXPTRW-1:0]] <= wdata[7:0];
                twptr <= twptr + 1'b1;
            end
            if (tx_go) trptr <= trptr + 1'b1;
        end

    uart_tx #(.DIV(DIV)) tx0 (
        .clk(clk), .rst(rst),
        .wr(tx_go),
        .data(txf[trptr[TXPTRW-1:0]]), .tx(esp_rxd), .busy(tx_busy));

    wire [7:0] rx_data_w;
    wire       rx_valid_w, rx_frame_w;

    uart_rx #(.DIV(DIV)) rx0 (
        .clk(clk), .rst(rst), .rx_pin(esp_txd),
        .data(rx_data_w), .valid(rx_valid_w), .frame_err(rx_frame_w));

    // ---- the receive FIFO --------------------------------------------------
    // ⛔ A ONE-BYTE REGISTER IS NOT ENOUGH FOR A LINK, and the first version of
    // this file had one because it was modelled on the console receiver in
    // koti_core, where M-mode firmware polls between keystrokes. A human types
    // at ~10 bytes/s; a link partner sends at 11520. At 115200 baud a byte
    // lands every 86.8 us, and ONE dropped byte corrupts an entire SLIP or PPP
    // frame — which then has to be retransmitted, at which point the same
    // thing happens again. A depth-1 buffer makes a link that works only when
    // nothing else is running.
    //
    // 64 bytes is ~5.5 ms of slack at 115200, which is a comfortable margin
    // against interrupt latency on a 25 MHz core that also has video DMA and a
    // page-table walker competing for memory.
    localparam int DEPTH = 64;
    localparam int PTRW  = $clog2(DEPTH);

    logic [7:0]        fifo [0:DEPTH-1];
    logic [PTRW:0]     wptr, rptr;             // one extra bit: full vs empty
    logic              rx_ovf;
    logic [31:0]       rx_count;

    wire f_empty = (wptr == rptr);
    wire f_full  = (wptr[PTRW-1:0] == rptr[PTRW-1:0]) && (wptr[PTRW] != rptr[PTRW]);
    wire [PTRW:0] f_level = wptr - rptr;

    wire rx_pop = sel && !we && (reg_a == 2'd0) && !f_empty;

    // ⚠️ ON OVERRUN THIS DROPS THE NEWEST BYTE, which is the OPPOSITE of what
    // src/usb_kbd.sv does, deliberately. For a keystroke queue the newest entry
    // is what the human just pressed and the oldest is stale, so dropping the
    // oldest is right. For a BYTE STREAM the FIFO's contents are the data and
    // its order IS the meaning: discarding from the middle of a frame that has
    // already partly arrived corrupts it either way, so the useful behaviour is
    // the one every hardware UART has — keep what is buffered, discard what
    // will not fit, and say so through `ovf` so the loss is visible rather than
    // silent.
    always_ff @(posedge clk)
        if (rst) begin
            wptr <= '0; rptr <= '0; rx_ovf <= 1'b0; rx_count <= 32'd0;
        end else begin
            if (rx_valid_w) begin
                rx_count <= rx_count + 32'd1;
                if (!f_full) begin
                    fifo[wptr[PTRW-1:0]] <= rx_data_w;
                    wptr <= wptr + 1'b1;
                end else
                    rx_ovf <= 1'b1;
            end
            // Clearing on a read of the STATUS register, not the data register:
            // a driver that drains the FIFO byte by byte would otherwise clear
            // the flag on its first pop and never see an overrun that happened
            // later in the same burst.
            if (sel && !we && (reg_a == 2'd1)) rx_ovf <= 1'b0;
            if (rx_pop) rptr <= rptr + 1'b1;
        end

    wire [7:0] rx_byte  = fifo[rptr[PTRW-1:0]];
    wire       rx_avail = !f_empty;

    // Level-sensitive, like usb_kbd's: high while anything is queued, or while
    // the driver has asked to be told there is transmit room. The driver must
    // drain to empty AND clear tx_irq_en when it runs out of data, or the line
    // never falls and the PLIC re-enters for ever.
    assign rx_irq = rx_avail || (tx_irq_en && !tx_full);

    // ---- the straps --------------------------------------------------------
    // ⛔ BOTH RESET TO 0, WHICH IS THE PRE-2026-08-10 HARDWIRED BEHAVIOUR:
    //   esp_en    = 0  holds the ESP32 in reset — the state that keeps it off
    //                  the microSD bus
    //   esp_gpio0 = 0  the download-mode strap, read only when the chip leaves
    //                  reset, so it is inert while esp_en holds it there
    // ⚠️ To boot the ESP32 from its own flash, gpio0 must be HIGH when enable
    // goes high. Set bit1 FIRST, then bit0, or the chip comes up in serial
    // download mode wondering why nobody is talking to it.
    // bit2 = TX-room interrupt enable. ⚠️ IT MUST BE A CONTROL BIT AND NOT
    // ALWAYS ON: an idle transmitter always has room, so a bare "room"
    // condition would hold the PLIC line high for ever and starve userspace —
    // the exact failure mode this project spent a day on in the SEIP hunt. The
    // driver raises it only while it has bytes left to send.
    logic [2:0] ctrl;
    always_ff @(posedge clk)
        if (rst)                                    ctrl <= 3'b000;
        else if (sel && we && (reg_a == 2'd2))      ctrl <= wdata[2:0];

    assign esp_en    = ctrl[0];
    assign esp_gpio0 = ctrl[1];
    wire   tx_irq_en = ctrl[2];

    // ---- the read mux ------------------------------------------------------
    always_comb
        case (reg_a)
            2'd0:    rdata = {22'd0, rx_ovf, rx_avail, rx_byte};
            // {level[6:0], ovf, avail, tx_busy}. The LEVEL is what makes an
            // interrupt-driven driver efficient: read it once, then pop that
            // many times, instead of an MMIO round trip per byte to ask
            // whether there is another one.
            // {tx_level[6:0], rx_level[6:0], ovf, avail, tx_busy}
            2'd1:    rdata = {10'd0, 7'(tx_level), 7'(f_level),
                              rx_ovf, rx_avail, tx_busy || !tx_empty};
            2'd2:    rdata = {30'd0, ctrl};
            default: rdata = rx_count;
        endcase

    // A write to +0x00 while the transmitter is busy is dropped rather than
    // queued, exactly as uart_putc's `while (UART & 1)` poll already assumes on
    // the console side. Adding a one-deep transmit buffer here would make this
    // port behave differently from the other one for no reason a caller can
    // see, and callers that poll are correct on both.
    //
    // `frame_err` from the receiver is deliberately NOT exposed yet: nothing
    // reads it, and a status bit nobody checks is indistinguishable from one
    // that is always zero. It becomes a register the day a driver acts on it.
    wire _unused = &{1'b0, rx_frame_w, wdata[31:8], 1'b0};

endmodule
