JoonatanAlanampa/koti/sw/linux/check_config.py

#!/usr/bin/env python3
"""Assert that the RESOLVED kernel .config is the kernel koti can run.

    python3 sw/linux/check_config.py <path-to-.config>

Why this exists: `make koti_defconfig` silently DROPS any line whose
dependencies are not met. A defconfig is a request, not a result — so a
symbol that got renamed upstream, or one whose `depends on` we did not
notice, disappears without a word and the build goes green. Several of the
symbols below fail in ways that produce no error message at all:

  * RISCV_ISA_C left on  -> the kernel is built with compressed instructions
                            koti cannot decode. It dies on an illegal
                            instruction before printing anything.
  * RISCV_SBI_V01 off    -> in 6.12 both hvc and earlycon prefer the SBI DBCN
                            extension and only fall back to the v0.1 console
                            `if (IS_ENABLED(CONFIG_RISCV_SBI_V01))`. koti's
                            firmware has no DBCN, so the kernel boots
                            perfectly and says nothing.
  * SMP left on          -> the kernel asks for IPI/RFENCE, which the firmware
                            deliberately refuses.

Each of those is a day of debugging a silent machine. This is minutes.
"""
import re
import sys
from pathlib import Path

# (symbol, expected) — expected is "y", "n", or a string value.
# "n" covers both "# CONFIG_X is not set" and the symbol being absent
# entirely, because kconfig writes the former and drops the latter and both
# mean the same thing to the compiler.
REQUIRED = [
    # the architecture koti actually is
    ("CONFIG_ARCH_RV32I", "y"),
    ("CONFIG_32BIT", "y"),
    ("CONFIG_NONPORTABLE", "y"),
    ("CONFIG_MMU", "y"),
    ("CONFIG_RISCV_ISA_C", "n"),
    # EFI is asserted off not because koti minds UEFI but because `config EFI`
    # does `select RISCV_ISA_C`, and a select beats a defconfig's "is not set".
    # This pair is the reason this script exists: on its first run
    # RISCV_ISA_C came back y with nothing in the log to say why.
    ("CONFIG_EFI", "n"),
    ("CONFIG_FPU", "n"),
    ("CONFIG_SMP", "n"),
    # Not a hardening opinion — an arithmetic one. It makes vmlinux.lds.S align
    # every section to PMD_SIZE, which on sv32 is 4 MiB, and there are four
    # such boundaries. It cost 16 MiB of padding on a machine with 12.
    ("CONFIG_STRICT_KERNEL_RWX", "n"),

    # the firmware contract (see sw/sbi/sbi.c)
    ("CONFIG_RISCV_SBI", "y"),
    ("CONFIG_RISCV_SBI_V01", "y"),
    ("CONFIG_HVC_RISCV_SBI", "y"),
    ("CONFIG_SERIAL_EARLYCON_RISCV_SBI", "y"),
    ("CONFIG_RISCV_TIMER", "y"),
    ("CONFIG_RISCV_INTC", "y"),
    ("CONFIG_SIFIVE_PLIC", "y"),

    # The command line comes from koti.dts /chosen/bootargs, and that is where
    # console=hvc0 earlycon=sbi live. CMDLINE_FORCE would override it with the
    # built-in CMDLINE, which is "" — an empty command line boots a kernel with
    # no console and no complaint. (RISC-V spells the default CMDLINE_FALLBACK,
    # not the generic CMDLINE_FROM_BOOTLOADER.)
    #
    # ⚠️ Asserting CMDLINE_FORCE=n was VACUOUS for as long as it existed, and
    # the absence check added 2026-08-05 is what exposed it: the whole
    # CMDLINE_FALLBACK/EXTEND/FORCE choice is only visible when CONFIG_CMDLINE
    # is non-empty, so with koti's empty CMDLINE none of them appear in the
    # resolved config at all and "want n" was satisfied by a symbol that was
    # not there. The real guarantee is the empty CMDLINE itself — nothing can
    # be forced when there is nothing to force — so that is what is asserted,
    # and FORCE is checked only if it ever becomes visible.
    ("CONFIG_CMDLINE", '""'),
    ("CONFIG_CMDLINE_FORCE", "n?"),

    # Not cryptography — boot time. CRYPTO_MANAGER_DISABLE_TESTS only EXISTS
    # inside the crypto menu, and with it absent IS_ENABLED() is false and
    # lib/crypto/blake2s.c runs its self-test unconditionally: >33 million
    # clocks of silence that two sessions mistook for a hang. This is exactly
    # the failure mode this script was written for — the symbol koti depends on
    # not existing, rather than being wrong.
    ("CONFIG_CRYPTO", "y"),
    ("CONFIG_CRYPTO_MANAGER_DISABLE_TESTS", "y"),

    # the machine description and the rootfs
    ("CONFIG_OF", "y"),
    ("CONFIG_BLK_DEV_INITRD", "y"),
    ("CONFIG_BINFMT_ELF", "y"),

    # ---- the clock (PLAN item 28) ------------------------------------------
    # Every one of these is a symbol whose absence is SILENT rather than an
    # error, which is the criterion for being in this list at all:
    #
    #   I2C_ALGOBIT off  -> koti_i2c.c fails to link, but only if I2C_KOTI is
    #                       also on; with both dropped the kernel builds fine
    #                       and simply has no bus.
    #   I2C_KOTI off     -> the bus never appears, so the rtc@68 node in the
    #                       devicetree is never instantiated. No error: an I2C
    #                       slave with no adapter is not a failure, it is
    #                       nothing.
    #   RTC_DRV_DS1307   -> /dev/rtc0 does not exist and hwclock says "no such
    #                       device", which reads as a wiring fault.
    #   RTC_HCTOSYS off  -> the RTC works perfectly and NOTHING READS IT. The
    #                       machine still boots at the epoch. This is the one
    #                       that would waste a bench session, because every
    #                       manual check (i2cget, hwclock -r) would pass.
    ("CONFIG_I2C", "y"),
    ("CONFIG_I2C_ALGOBIT", "y"),
    ("CONFIG_I2C_KOTI", "y"),
    ("CONFIG_I2C_CHARDEV", "y"),
    ("CONFIG_RTC_CLASS", "y"),
    ("CONFIG_RTC_DRV_DS1307", "y"),
    ("CONFIG_RTC_HCTOSYS", "y"),
    ("CONFIG_RTC_HCTOSYS_DEVICE", '"rtc0"'),
    # rtc-ds1307 selects this for itself; asserting it is how a rename
    # upstream becomes a failed build rather than a driver that quietly is not
    # there.
    ("CONFIG_REGMAP_I2C", "y"),

    # being able to see what happened
    ("CONFIG_PRINTK", "y"),
    ("CONFIG_PRINTK_TIME", "y"),
]

# Symbols whose value is only reported, not asserted: they change the size and
# the shape of the boot but no single value is wrong.
REPORT = [
    "CONFIG_CC_OPTIMIZE_FOR_SIZE",
    "CONFIG_PAGE_OFFSET",
    "CONFIG_CMDLINE",
    "CONFIG_CMDLINE_FALLBACK",
    "CONFIG_INITRAMFS_SOURCE",
    "CONFIG_LOG_BUF_SHIFT",
    "CONFIG_HZ",
    "CONFIG_KALLSYMS",
    "CONFIG_RISCV_ISA_ZBB",
    "CONFIG_RISCV_ISA_ZICBOM",
    "CONFIG_PAGE_SIZE_4KB",
]


def parse(path):
    """Return (values, seen).

    `seen` is every symbol the file MENTIONS in either form. kconfig writes
    `# X is not set` for a symbol that is visible and off, and omits entirely
    one whose dependencies are unmet or which does not exist under this name.

    Keeping them apart is what stops a `want n` line from being satisfied by a
    SYMBOL NAME THAT DOES NOT EXIST. That is not hypothetical: the Buildroot
    checker next door shipped with BR2_RISCV_ISA_CUSTOM_RVF/RVD in its list,
    neither symbol exists, both "passed", and the real config had floating
    point switched on for a core with no FPU. Every `n` assertion here was open
    to the same silent failure — a guard that cannot fail is this project's
    signature defect.
    """
    values, seen = {}, set()
    set_re = re.compile(r"^(CONFIG_[A-Za-z0-9_]+)=(.*)$")
    unset_re = re.compile(r"^# (CONFIG_[A-Za-z0-9_]+) is not set$")
    for line in Path(path).read_text().splitlines():
        m = set_re.match(line)
        if m:
            values[m.group(1)] = m.group(2)
            seen.add(m.group(1))
            continue
        m = unset_re.match(line)
        if m:
            seen.add(m.group(1))
    return values, seen


def main():
    if len(sys.argv) != 2:
        print(__doc__)
        return 2
    cfg, seen = parse(sys.argv[1])

    bad = []
    print("=== required ===")
    for sym, want in REQUIRED:
        got = cfg.get(sym)
        if sym not in seen:
            # "n?" means the symbol is allowed not to exist — its dependencies
            # may legitimately hide it — but must be off if it does. Anything
            # else that is absent is UNKNOWN, not "off": either the symbol was
            # renamed upstream, or its dependencies are unmet. Both mean the
            # line verified nothing, and reading it as "n" is how a stale name
            # keeps passing forever.
            if want == "n?":
                print(f"  ok   {sym} = <absent>   (want n if visible)")
                continue
            print(f"  FAIL {sym} = <absent>   (want {want})")
            bad.append((sym, want, "<absent>"))
            continue
        ok = (got is None) if want in ("n", "n?") else (got == want)
        shown = "n" if got is None else got
        print(f"  {'ok  ' if ok else 'FAIL'} {sym} = {shown}   (want {want})")
        if not ok:
            bad.append((sym, want, shown))

    print("=== reported ===")
    for sym in REPORT:
        print(f"       {sym} = {cfg.get(sym, 'n')}")

    if bad:
        print()
        print(f"{len(bad)} kernel config symbol(s) are not what koti needs:")
        for sym, want, got in bad:
            print(f"  {sym}: want {want}, got {got}")
        print()
        print("kconfig drops a defconfig line whose dependencies are unmet, so")
        print("check sw/linux/koti_defconfig against this kernel version's")
        print("Kconfig before assuming the symbol was simply forgotten.")
        return 1

    print("\nconfig ok")
    return 0


if __name__ == "__main__":
    sys.exit(main())
