JoonatanAlanampa/koti/(commit log)

2026-07-18 Koti-1 scaffold: VGA + PS/2 bring-up top with passing cocotb suite
    Frontier goal (PLAN.md): first full sv32-MMU Linux on a TT shuttle,
    with the console visible - VGA text out, PS/2 keyboard in, QSPI Pmod
    memory. Base: TinyRV32 core vendored from tt-riscv.
    This commit: ttsky-verilog-template scaffold; vga_timing (640x480@60,
    pixel-enable for a 50 MHz core), ps2_rx (parity + watchdog), clint
    (mtime/mtimecmp/msip); bring-up top tt_um_koti drives a checkerboard
    on the Tiny VGA Pmod with PS/2-selected colors. 3 pin-level cocotb
    tests pass (reset pattern, hsync width/period, scancode colors incl.
    bad-parity reject); GL-safe, run via make or python run.py.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
    [alu.sv, branch.sv, cache.sv, clint.sv, control.sv, cpu.sv, cpu_pipe.sv, immgen.sv]
2026-07-18 RV32M core surgery: iterative muldiv unit, decode, whole-pipe stall
    - core/muldiv.sv: one-bit-per-cycle mul/div on absolute values with
    sign fixup; div-by-zero and INT_MIN/-1 resolved at accept per spec;
    sticky done/ack handshake so a concurrent mstall cannot lose the
    completion.
    - control.sv: funct7[0] on OP selects RV32M (legal funct7 there is
    0000000/0100000/0000001); cpu.sv stays RV32I and ignores it.
    - cpu_pipe.sv: md_stall freezes F..W until the unit delivers; result
    rides EX/MEM and forwards like any ALU value. Fixed the latent
    hazard this exposes: an SDRAM ack landing during a frozen M stage
    re-issued the transaction; sd_seen/sd_data_r now capture and hold.
    - 32 registe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
    [control.sv, cpu.sv, cpu_pipe.sv, muldiv.sv, run_core.py, tb_core.v, test_core.py]
2026-07-18 Instruction-level harness: RV32IM pipeline proven on directed programs
    test/sim_models.sv gives the vendored core its missing imem/dmem/
    audio_gen (interfaces per cpu_pipe instantiations: registered fetch,
    async-read byte-enable dmem). tb_cpu.v ties off SDRAM; cocotb pokes
    hand-assembled programs into imem by backdoor and reads the regfile
    back at ECALL.
    4 directed tests green on the real pipeline (test/run_cpu.py):
    - all 32 registers via li/add/sub
    - M ops incl. div-by-zero and INT_MIN/-1 through actual instructions
    - muldiv result forwarding chains (M and W paths, back-to-back M ops)
    - load-use stall feeding muldiv + taken branch flushing a mul
    core-tests.yaml runs the muldiv unit suite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
    [run_cpu.py, tb_cpu.v, test_cpu.py]
2026-07-18 M-mode CSRs + precise traps: ECALL/MRET/WFI, timer interrupts
    core/csr.sv: mstatus (MIE/MPIE, MPP=11), mie/mip, mtvec (direct),
    mepc, mcause, mscratch, mtval, misa=RV32IM. Unknown CSRs read 0 /
    ignore writes; gap logged for the privilege-suite milestone.
    Pipeline: CSR ops execute in EX (result forwards like an ALU value;
    RMW is idempotent under mstall). Traps taken at EX are precise here -
    older stages always commit, the one wrong-path fetch dies like a
    mispredict. ECALL now traps (SBI path); EBREAK takes over the
    halt-the-core role; MRET returns; WFI is a NOP. mtip/msip/meip ports
    added; interrupts are never injected onto an in-flight muldiv so the
    unit cannot be orphaned. Suppressed instr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
    [control.sv, cpu.sv, cpu_pipe.sv, csr.sv, run_cpu.py, tb_cpu.v, test_cpu.py]
2026-07-18 A extension in-core: AMOs as M-stage RMW, LR/SC; commit-gating fix
    Core is now RV32IMA + Zicsr + M-mode traps (KianV-class ISA).
    - AMOs: 2-phase read-modify-write microsequence in M (astall freezes
    the pipe), riding whatever memory M talks to - BRAM today, the QSPI
    controller after bus unification. Revises the earlier plan note that
    A had to wait for the controller: nothing here is throwaway.
    - LR = load + reservation arm; SC = conditional store + success flag,
    no FSM. Reservation dies on any store, SC, RMW, or trap (clear wins
    on same-edge conflicts). AMO results use the existing load-use
    stall; no new forwarding paths.
    - SDRAM path: RMW read data bypasses sd_seen into old_q so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
    [control.sv, cpu.sv, cpu_pipe.sv, immgen.sv, test_cpu.py]
2026-07-18 Bus unification: koti_core.sv - the RV32IMA ASIC core on XIP ports
    src/koti_core.sv merges the two proven lineages: tt-riscv rv32_core''s
    fetch FSM (non-blocking pair fetch + skid buffer, fdrop on redirect),
    external data port, and MMIO carve-out, with the RV32IMA + Zicsr +
    M-trap pipeline built here. src/qspi_ctrl.sv (+ 2:1 arbiter) vendored
    verbatim from tt-riscv. core/cpu_pipe.sv and cpu.sv stay as frozen
    references; sim_models.sv (their BRAM harness) removed.
    Memory map live: flash 0x0+, PSRAM 0x0100_0000+, core MMIO 0x0001_0000
    (LED/UART/GPIO/QSPI_CFG); CLINT/PLIC/VGA registers (0x0002_0000+) ride
    the data port for the SoC top to decode and ack. AMO RMW issues both
    phases over the exte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
    [koti_core.sv, qspi_ctrl.sv, run_cpu.py, tb_cpu.v, test_cpu.py, xip_model.sv]
2026-07-18 SoC top: tt_um_koti is the real chip - core + QSPI + CLINT, pin-level boot
    src/project.sv replaces the bring-up stub: koti_core + mem_arbiter +
    qspi_ctrl on the QSPI Pmod pins, CLINT intercepted on the data port at
    0x0002_0000 (1-cycle ack, never reaches the arbiter), mtip/msip wired
    to the core, meip reserved for the PLIC. Headless v1 pinout is
    tt-riscv''s proven demo layout: uo[0] UART TX, uo[1] HALTED, uo[7:2]
    LED, ui GPIO in. VGA/PS2 stub retired until the video milestone.
    Shared modules copied core/ -> src/ (TT requires sources in src/);
    src/ is now canonical - all three test runners point there.
    Pin-level test (SpiMem/spi_bus models vendored from tt-riscv): boots
    from behavioral SPI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
    [alu.sv, branch.sv, control.sv, csr.sv, immgen.sv, muldiv.sv, project.sv, regfile.sv]
2026-07-18 Official riscv-tests: all 58 rv32ui+um+ua pass on koti_core over XIP
    Port of the tt-riscv riscv-tests flow with two Koti adaptations: the
    env halts with EBREAK (ECALL traps here - it is the SBI path), and the
    suite runs on the fast XIP-model harness with backdoor-loaded
    .text/.data (the wire-level QSPI path is covered by test.py and by
    tt-riscv''s pin-level suite on the identical controller).
    - test/env/riscv_test.h, link_asic.ld, build_riscv_tests.py (rv32ui +
    rv32um + rv32ua, -march=rv32ima; fence_i and ma_data skipped as on
    tt-riscv), riscv_suite.py + run_riscv.py.
    - 58/58 PASS first run: the full add..xori base suite, all 8 M-ops,
    and all 10 A-tests (amoadd..amoxor, lrsc). ~4 s wa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
    [build_riscv_tests.py, riscv_suite.py, run_riscv.py]
2026-07-18 M/S/U privilege modes: S-mode CSRs, delegation, sret, SBI timer path
    src/csr.sv rewritten (core/csr.sv stays the frozen M-only ancestor):
    - privilege state M/S/U; full mstatus MPP/SPP/xPIE/xIE stack with the
    sstatus view; S-mode CSR set incl. satp (plain register until the
    sv32 walker lands); medeleg/mideleg.
    - spec-correct interrupt routing: M-level pending taken if priv<M or
    MIE; mideleg-delegated pending taken in S/U per SIE, never in M;
    M may inject STIP/SSIP/SEIP by writing mip - the SBI timer path.
    - trap entry picks M or S bank + vector combinationally (trap_vec) so
    the fetch redirect works in the same cycle; ecall cause is 8/9/11
    by originating privilege. sret decoded and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
    [csr.sv, koti_core.sv, test_cpu.py]
2026-07-18 sv32 MMU: split TLBs, dual page walkers, precise page faults with tval
    The frontier feature''s hardware is complete: Koti-1 now translates.
    - src/tlb.sv: 4-entry fully-associative I/D TLBs (flops, round-robin).
    Uniform 4K granularity - megapages fill as the resolved 4K entry.
    Entries cache walk FAULTS too (invalid/misaligned/A=0), so repeated
    faulting accesses skip the walk until sfence.vma.
    - i-walker embedded in the fetch FSM: PTE reads ride the fetch port;
    walks latch their vpn and complete across redirects (fills are
    path-independent, no abort logic). Fetch faults poison one NOP that
    traps at EX with cause 12. Page-crossing pair fetches drop the skid
    word - its translation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
    [csr.sv, koti_core.sv, run_cpu.py, run_riscv.py, test_cpu.py, tlb.sv]
2026-07-18 VGA text mode + 3-port arbiter + PS/2: the chip has a screen
    - tools/genfont.py -> src/font_rom.svh: public-domain font8x8 set,
    768 B of synthesized ROM (half the planned budget) - 8x8 glyphs
    line-doubled into 8x16 cells, 80x30 text. Glyph art to be visually
    verified on FPGA before tapeout.
    - src/vga_text.sv: ping-pong 80-byte line buffers; row r+1 fetched
    during row r as 10 pair-reads (~3.3 scanlines worst-case serial, 16
    available); row 0 prefetched at vblank line 508; swap at row ends.
    - src/arbiter3.sv: video > data > fetch, grant held to ack; worst
    video wait is one in-flight serial burst.
    - SoC: VGA/PS2 MMIO at 0x0004_0000 (ctrl, charbuf base, fg/bg colors,
    keyboard byte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
    [arbiter3.sv, genfont.py, project.sv, vga_text.sv, vga_timing.sv]
2026-07-18 sw/: first C on Koti-1 - UART banner + VGA console, proven pin-level
    Bare-metal scaffolding the kernel work builds on: crt0.S (XIP boot,
    .data flash-to-PSRAM copy, bss zero, EBREAK on return), link.ld
    (stack below the charbuf), koti.h MMIO map, console.c (80x30 VGA text
    console with cursor/newline/scroll - the future SBI console), and
    build.py for the xpack toolchain (rv32ima_zicsr).
    hello.c (601 bytes) runs pin-level over the SPI wire protocol: the
    UART banner "Koti-1: hello from my own SoC" is decoded bit-by-bit at
    uo[0], then con_init() flips the pins to VGA and "KOTI-1 / hello,
    visible world" lands in the PSRAM charbuf, verified byte-for-byte.
    hello.bin committed so CI runs the test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
    [build.py, console.c, hello.c, koti.h]
2026-07-18 Area cuts after failed 8x2 harden: 40-col text, 64-glyph font, 2-entry TLBs
    First 8x2 GDS attempt: 247.9k um^2 of logic on a 302.4k um^2 core =
    94.5% utilization; detailed placement failed (DPL-0036) - exactly
    PLAN risk #1. Levers pulled:
    - vga_text: 40x30 text in 16x16 cells (pixels doubled both ways,
    C64-class density) - line buffers halve to 2x40 B, row DMA to 5
    pair-bursts (~1.7 scanlines worst-case serial of 16 available).
    - font ROM: 64 glyphs (512 B) - lowercase folds onto uppercase in
    hardware (0x60+ -> 0x40+).
    - TLBs: 2 entries each side.
    - console.c COLS=40; hello.bin rebuilt (597 B); tests updated for
    doubled pixels and 40-byte charbuf rows.
    All suites green: 3/3 pin-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
    [console.c, genfont.py, koti_core.sv, vga_text.sv]
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2026-07-18 config: close timing at the real 25 MHz, not 50
    The area-cut harden placed fine (utilization 94.5% -> 69.7%) but died
    in setup repair: 1338 violating endpoints against the template''s 20 ns
    CLOCK_PERIOD - a 50 MHz target the design never needed. Koti-1 runs at
    25 MHz (the VGA pixel clock is the core clock). 40 ns is the honest
    constraint; the resizer stops upsizing cells into placement failure.
2026-07-18 vga_text: register the pixel pipeline
    The 25 MHz harden cut setup violations 1338 -> 223, but pre-CTS
    fanout/slew repair added ~2900 buffers (placement to 80.8%) and
    post-CTS legalization failed. The linebuf-mux + font-ROM combinational
    path onto the pads was both a long path and a slew source; registering
    pix costs one invisible 40 ns pixel shift. Pin-level suite 3/3 (the
    sublist-search pixel check absorbs the shift).
    If the harden still misses after this, the next lever is structural:
    TT RAM macros for the regfile and line buffers.
    [vga_text.sv]
2026-07-18 Macro-ready regfile: sync-read pipeline restructure
    Decision: do not wait on the tnt RF macro read-timing answer -
    architect for sync read (registered address, read-first), the
    superset-compatible assumption: a combinational macro plus an input
    address register reproduces these semantics exactly, while the
    reverse is impossible. The macro becomes a body swap in regfile.sv.
    - src/regfile.sv: sync-read behavioral model of the macro (registered
    raddr, read-first; core/regfile.sv stays the comb FPGA ancestor).
    - koti_core: the RF read output IS the operand pipeline register -
    r1_e/r2_e are gone. The WB->ID bypass is latched into EX as hit
    flags + value (only the final-D-cycle writeback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
    [koti_core.sv, regfile.sv]
2026-07-18 Illegal-instruction + misaligned traps: last Linux-path hardware gap
    Illegal instruction (cause 2, mtval = instruction bits): coarse
    decode-level legality in D (unknown major opcodes, bad funct3/funct7,
    bad SYSTEM encodings) plus EX-level context checks (unknown CSR via a
    new csr `known` output, CSR privilege bits [9:8] vs priv, read-only
    CSR writes, mret/sret/sfence below their privilege). An illegal
    instruction produces no side effects: excluded from memory ops (no
    TLB walks on garbage), muldiv, CSR writes, and branch redirects.
    Misaligned traps with correct mtval: load (4) and store/AMO (6) at
    EX before the access, ranked below page faults per the privileged
    spec priority table; misal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
    [csr.sv, koti_core.sv, test_cpu.py]
2026-07-18 SBI firmware + mcycle/minstret + real datasheet
    sw/sbi/: the M-mode runtime kernels sit on. Boot + delegation
    (mideleg 0x222; medeleg 0xB151 - illegal instruction stays in M so
    rdtime can be emulated, ecall-from-S is the SBI itself), full-frame
    trap shim with the mscratch stack swap, legacy SBI calls (set_timer,
    console putchar/getchar), M-timer -> STIP injection, and rdtime/
    rdtimeh emulated through the illegal-instruction trap - the mtval-
    carries-the-instruction feature built one commit ago pays off
    immediately. Console mirrors to UART on the blue LSB and the VGA
    charbuf.
    Pin-level proof (test_sbi_firmware): the S-mode payload prints S via
    SBI, arms the timer using rdtime (a full S->M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
    [build.py, csr.sv, koti_core.sv, payload.c, sbi.c]
2026-07-18 ULX3S validation scaffold + README status
    fpga/ulx3s/: wrapper instantiating the exact TT top (what runs on the
    FPGA is what gets hardened), QSPI Pmod tristates, VGA/PS2 pin maps,
    LPF template with well-known clk/led/ftdi sites and TODO gp/gn sites
    to be verified against the official constraint file, and a build
    README for the open flow. Clearly marked untested - written before
    the board is in hand. Elaborates against the full SoC. WSL is not
    installed on this machine, so kernel builds stay queued behind a
    Linux environment.
    README: final status - hardware-complete, six green suites, open
    items named.
2026-07-24 F1: decode full 64 KiB MMIO windows (fix flash->MMIO aliasing)
    Codex review finding F1 (CRITICAL). The core-internal MMIO select
    (io_m) and the SoC CLINT/VGA selects compared only 3 low address bits,
    so any flash *data* load past the first 64 KiB of a 512 KiB span aliased
    into a device register: 0x0011_0000 -> core MMIO, 0x0012_0000 -> CLINT,
    0x0014_0000 -> VGA. This blocks staging any >64 KiB Linux image.
    - koti_core.sv: io_m = addr[31:16] == 0x0001 (full window).
    - project.sv: clint/vga_range compare byte_addr[24:16] (d_addr[22:14]).
    - test.py: test_flash_data_aperture_no_mmio_alias seeds a sentinel at
    each aliasing flash address (2 MiB flash model) and requires the real
    flash byte ba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
    [koti_core.sv, project.sv]
2026-07-24 F2: serialize fetch on satp write (squash old-root fetches)
    Codex review finding F2 (HIGH). A committed `satp` write flushed the
    TLBs but did not squash or redirect fetch, so an instruction already
    fetched under the old translation could retire under the new satp — and
    a satp held behind an older bus stall could start an old-root ITLB walk
    that outlives the flush.
    - koti_core.sv: a satp write (satp_take) now drives flush_ex and
    redirects to pc+4, exactly like sfence.vma; new fetches/ITLB walks are
    gated on !pstall so none start while an older stage is stalled.
    - test_cpu.py: test_satp_commit_squashes_old_fetch runs `csrw satp,B` in
    S mode where root B leaves the code VA unmapped; th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
    [koti_core.sv, test_cpu.py]
2026-07-24 F3: keep video request stable through ACK (fix arbiter grant-park)
    Codex review finding F3 (HIGH). vga_text tied v_req = f_busy && en, so
    clearing VGA_EN mid-refill withdrew an already-granted video request:
    mem_arbiter3 had sampled the old high v_req into grant=G_VID but qspi
    never saw the request, so grant stayed G_VID forever and all CPU
    fetch/data were blocked. Software-reachable (the VGA CTRL write does not
    wait behind the arbiter).
    - vga_text.sv: v_req = f_busy (a started refill finishes regardless of
    en); v_addr uses f_base latched at fetch start (base can move too).
    New refills still only START while en is high (fetch_trigger).
    - test.py: test_vga_disable_does_not_park_grant hal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
    [vga_text.sv]
2026-07-24 F5-F9: CSR conformance (delegation masking, WARL, misa.A)
    Codex review findings F5-F9 (MEDIUM/LOW), all in csr.sv; each has a
    directed regression that FAILS on the old RTL and PASSES on the fix.
    - F5 (test_mixed_delegation_reports_eligible_cause): in the take_m
    branch, only NON-delegated supervisor sources are eligible — a
    delegated SEI pending alongside a non-delegated SSI must report SSI
    (0x80000001), not SEI (0x80000009).
    - F6 (test_sie_sip_masked_by_mideleg): sie/sip are mideleg-masked views
    of mie/mip — a non-delegated S bit reads 0 and is unwritable through
    the alias.
    - F7 (test_vectored_or_warl_direct_tvec): mtvec/stvec are Direct-only;
    a vectored/reserved mode write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
    [csr.sv, test_cpu.py]
2026-07-24 F4: data access-fault path (flash RO stores, PSRAM high mirror)
    Codex review finding F4 (HIGH). The memory protocol had no access-error
    response: a store/SC/AMO to read-only flash was acknowledged as a silent
    no-op "success", and the APS6404 8 MiB high mirror (addr[24]&&addr[23])
    aliased into the low 8 MiB instead of faulting.
    - koti_core.sv: at the EX commit point (where traps stay precise),
    detect physical access faults on the resolved PA: a store/AMO/SC to
    read-only flash, or any access to the PSRAM high mirror. Raise load
    access fault (cause 5) or store/AMO access fault (cause 7); the op is
    squashed at EX->M so it never issues (no no-op ACK, no rd write, no
    alias write). LR re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
    [csr.sv, koti_core.sv, test_cpu.py]
2026-08-02 ULX3S: real pin constraints, correct Pmod geometry, and a bitstream CI
    The fpga/ulx3s scaffold could not have been built. Three things were wrong,
    and the first one is the reason the other two never surfaced:
    1. ulx3s.lpf left every gp/gn site as a TODO comment, so QSPI, VGA and PS/2
    were all unconstrained and nextpnr would refuse the design outright.
    2. ulx3s_top.sv put uio[7:0] on gp[0..7] and VGA on gn[0..7]. Those are not
    Pmod footprints: J1 is gp/gn[0..3] and J2 is gp/gn[4..7], so a QSPI Pmod
    wired that way straddles two physical connectors.
    3. Nothing built it. .github/workflows/fpga.yaml is TinyTapeout's ICE40UP5K
    action for a different board, disabled with `branches: non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
    [check_pins.py, ulx3s_top.sv]
2026-08-02 Simulate the ULX3S harness, not just the chip
    All four existing suites drive tt_um_koti directly, so everything BETWEEN the
    proven SoC and the physical pins - the J1 header permutation, the orientation
    straps, the UART source mux, the tristates - was unverified logic. That is the
    kind of gap that survives every simulation and then looks like dead gateware on
    the bench.
    tb_fpga instantiates ulx3s_top and talks to it through the header wires, with
    the SPI memory model reused verbatim from test.py so what is under test is the
    harness alone. It models PULLMODE=UP with pullup gates, because an undriven
    J1 line is genuinely high on the board and letting it float z turns a mapping
    bug into an unre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
    [run_fpga.py, tb_fpga.v, test_fpga.py]
2026-08-02 Bring-up checklist, flash path, and the roadmap's actual numbers
    The README was a four-line "untested scaffold" note that told you to program
    flash with an external programmer. It is now an ordered first-power-up
    procedure in the same style as console's, where each step is chosen so the
    next step's failure has one plausible cause left.
    The flash-programming answer turned out to be something we already own. The
    cartridge Pmod's bring-up bitstream doubles as a UART flash writer, and its J1
    pin mapping is byte-identical to this harness's - two independently written
    harnesses agreeing on which header wire carries which uio bit is the strongest
    cross-check available without hardware. So: load th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
    [test_fpga.py]
2026-08-02 PS/2: power the keyboard at 3.3 V - ECP5 IO is not 5 V tolerant
    The earlier guidance said "fit ~4.7k to 3.3 V" and mentioned 5 V only in
    passing, which is not enough to act on safely. PS/2 is nominally a 5 V bus and
    the ECP5's 3.3 V banks are not 5 V tolerant, so a 5 V-powered keyboard wired
    straight to gp[8]/gp[9] can damage the FPGA.
    Fix: power the keyboard from the 3.3 V rail, pull-ups to that same rail. Its
    pull-ups then sit on 3.3 V and every level is in spec. An undervolted keyboard
    that cannot cope just stays quiet - it fails safe in a way an overvolt does not.
    Also retracts the resistor-divider fallback the roadmap floated for the 5 V
    case. Working it through: the keyboard's own pu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
2026-08-02 Koti's Linux is an FPGA target, not a shuttle chip (user directive)
    The goal is restated: a computer that can actually be USED - CPU + OS + memory
    + peripherals on the ULX3S 85F - rather than the first TT chip to boot MMU
    Linux visibly. The old framing is kept in the sections below as history.
    This is not a demotion, it is a lifting of constraints. Checked against
    upstream ulx3s_v20.lpf today, the board carries: 32 MB of onboard 16-bit
    SDRAM against the Cartridge Pmod's 8 MB of serial QSPI PSRAM, a microSD slot
    (i.e. a real root filesystem), GPDI/HDMI, bidirectional usb_fpga_bd_dp/dn, and
    ~3.7 Mbit of BRAM that koti currently uses none of. koti occupies 10% of the
    85F, so area - the thing t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
2026-08-02 The keyboard works: PS/2 scancodes reach software
    `sbi.c` case 2 returned -1 with the comment "keyboard hookup pending", so
    although ps2_rx decoded frames correctly in RTL and the scancode reached an
    MMIO word, nothing above the hardware had ever read a key. The machine could
    not be typed at.
    sw/ps2kbd.c translates scancode set 2. Set 2 is not a choice: selecting set 1
    or 3 means sending a command TO the keyboard, and this design is receive-only
    by construction - `ui` is input-only on the chip, so ps2_rx has no transmit
    path. The same constraint costs the lock LEDs, which is why caps lock is
    deliberately absent: a caps state you can toggle but never see is worse than
    none. Layout is US, bec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
    [build.py, payload.c, sbi.c]
2026-08-02 The keyboard state lives in NOLOAD .bss, so it must be initialised
    The two new keyboard tests failed in CI with no UART output at all - not wrong
    characters, none - and the cause is a contract this firmware states outright.
    sw/sbi/link.ld puts .bss in PSRAM as NOLOAD and its comment says 'firmware
    state is .bss in PSRAM, written before read'. Nothing zeroes it.
    ps2kbd.c read `releasing` before ever writing it. PSRAM comes up holding
    whatever it holds, and a garbage-nonzero `releasing` makes the decoder treat
    every scancode as a key release, so it swallows all of them and the keyboard
    looks completely dead. The failure has no partial mode: it is silence.
    ps2_init() zeroes the four decoder f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
    [sbi.c]
2026-08-02 Instrument the failing keyboard test with an independent witness
    Two runs now, both 'UART stalled after b""' - no output at all - and that
    message cannot distinguish the two things it could mean: the keystroke never
    became a character, or it did and the UART decode missed it.
    sbi_putchar mirrors every character to the VGA charbuf in PSRAM, so the charbuf
    is a second, independent record of what the payload actually emitted. 'STK'
    alone means the getchar path returns -1 forever; 'STKhiA' means the characters
    exist and only my UART read is wrong. PS2_DATA is read-to-clear so it cannot be
    inspected after the fact - the mirror is the only evidence available.
    Ruled out by inspection so far, none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
2026-08-02 The keyboard works. The test was feeding it 10x faster than a keyboard can type
    The instrumented run gave the answer in one line: VGA charbuf mirror = 'STKi'.
    One of twelve scancodes survived, so the whole path - ps2_rx, the MMIO word,
    ps2kbd.c, the SBI call, the console - was working the entire time. Nothing was
    broken in the firmware. My two earlier diagnoses were both wrong, and the
    second fix (ps2_init) was harmless but beside the point.
    What was actually happening: the keyboard byte register is a SINGLE ENTRY with
    no FIFO and no overrun flag (src/project.sv). A second ps2_valid overwrites
    kb_code whether or not the previous byte was read, and a read in the same cycle
    clears kb_avail wh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
    [project.sv]
2026-08-02 PLAN: keyboard hookup done, with the overrun caveat the Linux driver will hit
    Marks item 2 complete and records the one thing that will matter later: the
    keyboard byte register has no overrun flag, so a driver decoding E0/F0 prefix
    sequences cannot tell when it lost a byte, and a dropped byte desynchronises
    the decoder. Harmless today against a real keyboard; not harmless once Linux is
    reading scancodes.
    Claude-Session: https://claude.ai/code/session_016gCRXjFAsBBEp7oQRg52EM
2026-08-02 SDRAM controller for the ULX3S's onboard 32 MB
    Koti's memory has always been the QSPI Pmod: 8 MB of PSRAM reached one serial
    transaction at a time, ~130 clocks for a 64-bit burst. Survivable for a demo,
    hopeless for a machine you sit down at. The board has 32 MB of 16-bit SDRAM
    soldered on, and once koti stopped being a tapeout target there was no reason
    left to pretend those pins do not exist.
    Measured: **10 clocks for a single 32-bit read**, against ~130. Four times the
    capacity and an order of magnitude the speed.
    Same request-port contract as qspi_ctrl, deliberately - hold req until the
    1-cycle ack, rdata/rdata2 valid during it - so this is a drop-in alternative
    rather than a new inter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
2026-08-02 Koti's RAM now comes from the board's SDRAM, not the Pmod
    The RAM half of the memory map moves off the QSPI Pmod's 8 MB of serial PSRAM
    and onto the ULX3S's onboard 32 MB SDRAM. Ten clocks for a random read instead
    of about 130.
    The MAP is deliberately untouched. addr[22] still picks flash from RAM and RAM
    still starts at 0x01000000, so the linker scripts, the SBI firmware, the
    charbuf address and all eight existing chip tests carried over without an edit.
    Only the thing on the far end of the request port changed. The cost is that the
    16 MB window reaches half of the 32 MB part; widening it means a wider address
    bus through the core and the arbiter, for memory mainline sv32 Linux does not
    n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
2026-08-02 SDRAM model: warn on x/z on the bus, not on a tied-off enable
    `doe` only means anything when the model sits directly on the controller. In
    the full harness the tri-state is resolved a level up and doe is tied off, so
    the warning fired on every single write and drowned the log it was supposed to
    help read. What matters is whether real data arrived, so check the bus.
    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
    [sdram_model.sv]
2026-08-02 Local simulation works again, and the SDRAM hang is localised
    koti's simulations could not run on this machine at all: oss-cad-suite ships
    Icarus 14, which rejects declaration-after-use ("Unable to bind ... Check for
    declaration after use") where Icarus 12 tolerated it. Every debug cycle went
    through a 14-minute CI round trip, which is how the keyboard bug ate three of
    them. Twelve signals in koti_core.sv are used above the point they were
    declared; they now have forward declarations at the top of the module and every
    expression stays exactly where it was. No logic changes. Verified locally: the
    whole chip suite, 8/8, in 227 seconds.
    That immediately paid for itself. The SDRAM harness failu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
    [koti_core.sv, project.sv, test_fpga.py]
2026-08-02 SDRAM model: power up with defined contents, not x
    A Verilog monitor on the arbiter found the poison: `d_req` from the CPU goes x,
    and the arbiter's grant selector is a ternary chain on v_req/d_req/f_req, so an
    x there latches x into grant. Both acks were clean the whole time - the X was
    never coming from the ack join, which is where I had been looking.
    The x traces back to this model. Its array was uninitialised, so any read of a
    location the program had not written yet returned x, and that walks straight
    into the CPU. Real SDRAM powers up holding arbitrary bits, not undefined ones,
    and the QSPI model this replaced returned zeros from a bytearray - which is why
    the problem appeared only af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
    [sdram_model.sv]
2026-08-02 Deny x a path through the memory read mux, and localise the real source
    `s_ack ? s_rdata : q_rdata` looks equivalent to selecting on the ack - read data
    is only meaningful during an ack, so who cares otherwise - but it is not. An
    idle qspi_ctrl has an undefined shift register, so that expression put x on
    m_rdata for most of the run. Selecting on the ack and defaulting to zero cannot
    change any correct behaviour and removes a whole class of x propagation.
    Confirmed: m_rdata and d_rdata are now clean (0x00000000) at the moment of
    failure, where they used to be x.
    It is not the bug. With the bus clean, the CPU STILL produces
    d_req=x and d_addr=xxxxxx while d_we=1, at pc=0xf8, about 11.2 ms in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
    [project.sv]
2026-08-02 SDRAM is now opt-in: both configurations build
    `KOTI_FPGA` switched the SoC but not the harness, so the SDRAM build was the
    only one that compiled and there was no known-good configuration to fall back
    to or bisect against. The harness now guards its SDRAM wiring the same way, and
    with the define off it parks the part safely - CKE low, CS# high, DQM masked -
    rather than leaving forty pins floating.
    Verified both: "WITH SDRAM: synthesises OK", "QSPI ONLY: synthesises OK".
    Dropping -DKOTI_FPGA from fpga/ulx3s/synth.ps1, .github/workflows/fpga-ulx3s.yaml
    and test/run_fpga.py now gives back exactly the machine that passed 4/4 this
    morning, at the cost of the SDRAM. That is a fallback, not a fi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
2026-08-02 Release the device-select latch on a dropped request too
    The `inflight` latch I added only cleared on `m_ack`, but a requester can walk
    away before it is served - the fetch port does exactly that on a pipeline flush.
    When that happened `inflight` stayed set forever, `sel_ram` froze on whichever
    device the abandoned request wanted, and every later access to the OTHER device
    was routed to a controller that never saw a request. The CPU would then stall on
    a fetch that could never complete.
    That is a real bug and it was mine, introduced with the latch. It is NOT the
    failure being chased: the two harness tests still fail with it fixed.
    Recording where that hunt actually stands, because the pict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
    [project.sv]
2026-08-02 Ship the QSPI build: 4/4 green, SDRAM waits behind the flag
    Drops -DKOTI_FPGA from fpga/ulx3s/synth.ps1, the fpga-ulx3s workflow and
    test/run_fpga.py. koti is back to the machine that works - RAM on the QSPI Pmod
    - and the entire SDRAM leg stays intact behind the define: controller, its 9
    tests, the SoC integration and three real bug fixes. Turning it back on is the
    same one flag.
    The harness charbuf assertion now looks in BOTH memories rather than assuming
    which is fitted, so it passes either way instead of needing an edit whenever
    the flag moves.
    AND A TRAP WORTH THE COMMIT ON ITS OWN: cocotb's runner decides whether to
    rebuild from SOURCE TIMESTAMPS and ignores build_args. Flipping the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
    [run_fpga.py, test_fpga.py]
2026-08-03 SDRAM reads: capture where the part actually puts the data
    The ULX3S clocks the SDRAM from the inverted system clock (ulx3s_top:
    sdram_clk = ~clk_25mhz), which buys 20 ns of command setup at 25 MHz. That
    half cycle applies in both directions and COMPOUNDS on a read: the part
    latches our READ half a clock early and launches its data half a clock
    early, so its data window lands one whole system clock before a same-clock
    part's would. sdram_ctrl waited CL-1 and captured where a same-clock part
    would have put the data, so every read latched the SECOND half-word into
    cap[15:0] and the already-released bus (z, i.e. x) into cap[31:16].
    Writes were untouched by any of this, which is the whole reaso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
    [run_fpga.py, sdram_ctrl.sv, sdram_model.sv, tb_fpga.v, tb_sdram.v]
2026-08-03 Keyboard: report the byte that was dropped
    The scancode register holds one byte and has no FIFO, so a second frame
    overwrites an unread first. That is fine against a real keyboard - a PS/2
    device needs 0.7-1.1 ms per frame and the poll loop comes round every
    ~0.28 ms - and it stays fine right up until something decodes set-2
    sequences. Then a silent drop is corrosive: a lost 0xF0 turns the next real
    press into a phantom release, and a byte lost after 0xE0 leaves the decoder
    one byte out of step permanently. One dropped byte becomes a stream of wrong
    characters with no way for software to suspect it. That is the case a Linux
    keyboard driver walks into.
    So PS2_DATA is now {ovf[9], avail[8], s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
    [koti.h, project.sv]
2026-08-04 Close the last three architecture decisions
    These were the gate in front of the kernel ladder. All three are now
    decided, with the fourth (memory) already closed by measurement on
    2026-08-03, so the section is no longer "open".
    Keyboard: USB HID host (user, 2026-08-04), not PS/2.
    Consequence worth acting on immediately: the PS/2 keyboard comes OFF
    the shopping list, and it was the last unbought item on koti's FPGA
    critical path -- there is now nothing left to buy for bring-up.
    Recorded honestly, because the usual argument for USB does not survive
    contact with this design: "mainline already has drivers" is false here.
    A soft host core on the ECP5 is not an EHCI or OHCI controll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
2026-08-04 Start the kernel ladder: SBI v0.2, a devicetree, and the gaps named
    Linux asks for the SBI spec version before it trusts any other firmware
    call, and falls back to assuming v0.1 if that call errors. koti's firmware
    implemented only the three legacy calls, so every kernel would have taken
    the deprecated legacy path -- silently, because the fallback is not an
    error, it is a design feature. sbi.c now answers:
    Base (0x10) get_spec_version, get_impl_id, get_impl_version,
    probe_extension, and mvendorid/marchid/mimpid as 0 (the
    spec's "not implemented", and the honest answer -- reading
    those CSRs would trap, they are not in csr.sv's known set)
    TIME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
    [payload.c, sbi.c]
2026-08-04 Give Linux 12 MB: lift the 8 MB RAM cap on the FPGA build
    koti_core faulted every data access with addr[23] set, capping RAM at
    8 MB. That check is right on the QSPI Pmod and wrong on the ULX3S, and
    the difference is what it was written to catch: the APS6404 PSRAM is
    8 MiB and MIRRORS above that, so an access up there silently lands
    somewhere it was never meant to and a fault is the only way software
    finds out. The board's RAM is soldered SDRAM with a genuine 16 MB window
    -- sdram_ctrl is handed {1'b0, m_addr[21:0]} = d_pa[23:2], so every
    address in it reaches a distinct location and nothing mirrors. There the
    fault rejected real memory, and specifically the half that matters: RV32
    Linux map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
    [koti_core.sv]
2026-08-04 Boot handoff: enter a kernel the way Linux expects to be entered
    sbi.S entered a fixed flash address at 0x4000 with no registers set. Linux
    is entered in S-mode with a0 = hartid and a1 = the physical address of the
    devicetree blob, so that jump had to become a real handoff.
    It chooses its target by what is in memory rather than by a build flag: a
    RISC-V Image header at 0x01400000 -- "RSC\x05" at byte 0x38 of the header,
    per arch/riscv/kernel/head.S -- means boot that as a kernel, and anything
    else means run the built-in flash payload exactly as before. One firmware
    image serves both, and every existing test keeps passing untouched, which
    is also what covers the fallback direction.
    The DTB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
    [sbi.c]
2026-08-04 PLIC: give Linux an interrupt controller, and a spec-compatible one
    PLAN.md's architecture delta 7 has listed a "PLIC-lite" since the start and
    it was never built. What stood in for it was one wire -- project.sv did
    `assign kb_irq = kb_avail` straight into the core's meip -- and that fails
    an operating system in two separate ways. Linux has no interrupt controller
    to bind a driver to, so no device can claim an interrupt at all. And the
    keyboard raised an M-MODE interrupt while mideleg delegates SEIP, which
    nothing ever raised, so a keystroke could not reach supervisor mode however
    the kernel was configured.
    src/plic.sv is register-compatible with the SiFive PLIC, so mainline's
    sifive,plic-1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
    [csr.sv, koti_core.sv, plic.sv, project.sv, run_fpga.py, tb_cpu.v, tb_plic.v]
2026-08-04 Devicetree: fix the warning the new check found, then make warnings fatal
    The dtc step added in the previous commit went green while printing
    "/soc/timer: missing or empty reg/ranges property", because dtc exits 0
    on a warning. So the check found a real modelling error on its very first
    run and then passed anyway, which is the least useful thing a check can do.
    The error is real: /soc is a simple-bus and every child of one is expected
    to carry a reg, but riscv,timer has no registers to name -- it is reached
    through the SBI TIME call, not through MMIO. A node with no address does
    not belong on a bus, so it moves to the root.
    Warnings now fail the step. A devicetree has exactly one consumer,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
2026-08-04 Build a kernel: mainline sv32 Linux, and delete the nommu rung
    PLAN.md's ladder put nommu uClinux below sv32 Linux, "without the MMU in the
    way". Checked against v6.12 rather than recalled, that is not a smaller step
    toward the same machine:
    config RISCV_M_MODE depends on !MMU default y
    config RISCV_SBI depends on !RISCV_M_MODE
    CONFIG_MMU=n turns M-mode on and switches RISCV_SBI off with it, so a nommu
    kernel does not call the firmware, it replaces it -- and since koti's UART is
    transmit-only and not a 16550, a kernel that cannot use the SBI console has no
    console at all. "Rung 1" fails as a machine that boots perfectly and says
    nothing. xv6-rv32 is the other candidate and is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
    [check_config.py, check_image.py]
2026-08-04 Put the devicetree in flash, where the firmware has always looked for it
    sbi.c has read flash 0x6000, validated the FDT magic and copied `totalsize`
    bytes to RAM since the boot handoff landed, and link.ld has reserved a .dtb
    section at that address -- but nothing emitted one. Unprogrammed flash reads
    0xFF, so the magic test failed cleanly and a kernel would have been entered
    with a1 = 0. That is a tidy failure and still a fatal one: no kernel survives
    being handed a null devicetree, and nothing in the tree said the blob was
    missing rather than merely unchecked.
    dtb.S .incbin's sw/linux/koti.dtb into the section. The blob is a build
    product that is nevertheless committed, because the firmwar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
    [build.py]
2026-08-04 EFI was quietly selecting the compressed instructions koti cannot execute
    check_config.py earned its place on its first run. CONFIG_RISCV_ISA_C came
    back y despite `# CONFIG_RISCV_ISA_C is not set` in the defconfig, because:
    config EFI
    depends on OF && !XIP_KERNEL
    depends on MMU
    default y
    select RISCV_ISA_C
    All three dependencies hold on RV32, EFI defaults on, and a `select` overrides
    a defconfig's "is not set" with no warning. So a kernel built from a config
    that explicitly asks for no compressed instructions gets them anyway -- and
    koti's core cannot decode them, so it would have died on an illegal
    instruction with nothing printed. The build would have been green. Nothing in
    the lo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
2026-08-04 The kernel built, and then did not fit: 16 of its 20 MiB were alignment
    check_image.py caught the second one. The first build produced a valid RV32
    Image -- correct RSC magic, little-endian, version 0.2 -- of 20.44 MiB, against
    the 12 MiB koti has above the kernel's load address.
    `size vmlinux` explains none of that, and the config looks innocent. The
    answer is in the gaps between symbols in System.map: _etext is 1.8 MB and
    there are FOUR gaps of almost exactly 4 MiB. CONFIG_STRICT_KERNEL_RWX is
    default y and makes vmlinux.lds.S use `#define SECTION_ALIGN PMD_SIZE` so
    text, rodata, data and init can hold different permissions on whole megapages
    -- and on sv32 PMD_SIZE is 4 MiB. So 16 of the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
    [check_config.py, check_image.py]
2026-08-04 Linux boots on koti, and finding out cost two real CPU bugs
    [ 0.000000] Linux version 6.12.0 ...
    [ 0.000000] Machine model: Koti-1 (ULX3S 85F)
    [ 0.000000] SBI specification v0.2 detected
    [ 0.000000] SBI TIME extension detected
    [ 0.000000] earlycon: sbi0 at I/O port 0x0
    [ 0.000000] Kernel command line: console=hvc0 earlycon=sbi
    The machine description, the firmware, the DTB handoff and the SBI console
    all work end to end. It reaches SLUB init and stalls there; that is the next
    thing to chase, not a claim that this is a usable computer yet.
    test/tb_boot.v + test/sim_mem.sv are the vehicle. Self-driving plain Verilog,
    like tb_icache.v and tb_plic.v, s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
    [arbiter3.sv, koti_core.sv, mkhex.py, project.sv, sim_mem.sv, tb_boot.v]
2026-08-04 Pay the AMO fix in a clock instead of in 691 LUTs and 3.4 MHz
    The first version of the livelock fix let an RMW retire on the cycle its
    write was acked, which meant the writeback read mem_word while d_seen was
    still 0 -- so mem_word had to mux old_q in on the load datapath, a 32-bit mux
    in front of the load shifter. Measured on the ECP5: 11541 -> 12232 TRELLIS_COMB
    and post-route Fmax 31.83 -> 28.42 MHz. Still PASS at 25, but that is half the
    margin for a mux that exists to service one instruction class.
    Releasing on d_seen alone costs an AMO one extra clock and gives the mux back.
    It is also simpler to reason about: an AMO now ALWAYS retires with d_seen set
    and d_data_r holding old_q, so th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
    [koti_core.sv]
2026-08-04 Record the boot in PLAN.md, correct the clock, and gate on the right Fmax
    PLAN.md's ladder still had xv6 and nommu uClinux as rungs below sv32 Linux,
    and its memory map was marked "(draft)" with the PLIC at 0x0003_0000 and RAM
    described as 8 MiB of PSRAM. Both now say what was built: the PLIC takes the
    top 4 MB of flash space because the SiFive driver hard-codes its context
    registers at offset 0x200000, RAM is the 16 MB window, and the table carries
    the addresses software actually depends on -- .dtb at flash 0x6000, the DTB
    copy at 0x013F_0000, the kernel at 0x0140_0000.
    The clock figure is now **31.14 MHz post-route, PASS at 25 MHz** (run
    30940888908): 11467 COMB (13%), 3637 FF, 79 IO, 3/2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
2026-08-04 Make the boot bench dispatchable, and flush the trace
    Two things learned from using it. The GitHub runner is about five times faster
    at this bench than the development host -- ~29k simulated clocks per second
    against ~5-6k -- so the machine best placed to chase the boot past where it
    currently stops is CI, not the laptop. workflow_dispatch now takes maxclk,
    quiet and trace, defaulting to exactly the values a push already used, so a
    push is unchanged and an experiment costs a button.
    And +trace now flushes. The only reason to ask for a coarse trace is to watch a
    run that is printing nothing else, and stdout to a file or a pipe is
    block-buffered -- so the trace of a silent kernel arrived in 4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
2026-08-04 A fetch pair that straddles a page dropped an instruction outright
    Linux stopped after "SLUB: HWalign=64" and every CI boot blamed the quiet
    window, which fired at 12,213,639 clocks and never reached even its own 15M
    maxclk. Past that point the picture is unambiguous: from 8.9M to 18M, 82 of 91
    sampled clocks are inside kfree or __update_cpu_freelist_fast and none is in a
    caller. SLUB's lockless free path was spinning on a cmpxchg that could not
    succeed.
    It is not the atomics. __update_cpu_freelist_fast contains none -- on RV32 it
    is the generic irq-disabled cmpxchg64: csrrci sstatus, two lw/bne pairs, two
    sw. Caller and callee read THE SAME two words (c->freelist, c->tid) with
    interrupts o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
2026-08-04 Record what the boot reaches now, and re-quote the clock
    The CI boot gets to `devtmpfs: initialized` and ends on its CLOCK LIMIT rather
    than on a hang -- the interrupt controller and the SBI timer are up, printk
    timestamps advance, and the kernel reports 8460K/12288K available. 15 M clocks
    is what a push spends; workflow_dispatch takes maxclk/quiet/trace for a longer
    look, and the runner is about five times faster at this bench than the
    development host.
    sw/linux/README.md now carries all three CPU defects in one table with what
    each one was and what regression-tests it, and states the prior plainly: all
    three needed the MMU on, which is exactly why the 58 official tests (satp = 0)
    missed e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
2026-08-05 Keep the script that turns a boot trace into kernel symbols
    Every one of the three CPU defects found so far was diagnosed the same way:
    run tb_boot with a trace on, resolve the program counters against the kernel's
    System.map, and read what the machine is actually executing. That script was
    rewritten from scratch each time and went away with the session that wrote it.
    It encodes the one trap that makes the technique dangerous: the two trace
    formats do not carry the same kind of address. `+trace=`'s `fetch` field is the
    fetch port's PHYSICAL address and needs converting; `+tfrom=`'s `pc_d`/`pc_e`
    are already virtual. Getting that backwards is silent — an unconverted physical
    address lands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
    [ktrace.py]
2026-08-05 The quiet window was killing boots inside a self-test that prints nothing
    `quiet=4000000` had stopped being merely tight and become wrong. blake2s_mod_init
    is a device_initcall two entries after the io schedulers, and it runs the BLAKE2s
    self-test over 256 test vectors while printing absolutely nothing — on this
    machine a legitimate silence of roughly five million clocks. Any run whose maxclk
    reaches ~27M therefore hit the window mid-self-test and declared "assuming stuck"
    about a kernel that was working perfectly.
    That is the second time this exact window has produced a false verdict; the first
    cost a day, when every CI boot died at 12,213,639 clocks on the quiet window
    without ever reac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
2026-08-05 An S-mode EBREAK now traps instead of stopping the machine
    RISC-V Linux does not use EBREAK for debuggers. It compiles every WARN_ON() and
    BUG_ON() into an EBREAK plus a __bug_table entry holding the file and line —
    2812 of them in the 6.12 image koti boots — and expects do_trap_break() to look
    the PC up in that table, print, and for a WARN step past the EBREAK and carry
    on. A WARN is a complaint the kernel is designed to survive.
    koti halted on all of them. So the first warning anywhere in the kernel stopped
    the machine dead, with no message, and because the firmware's clean shutdown is
    ALSO an EBREAK, test/tb_boot.v could not tell that apart from a successful
    poweroff and called it a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
    [csr.sv, koti_core.sv, test_cpu.py]
2026-08-05 A halt is not a success, and the boot bench said it was
    tb_boot reported "PASS (machine halted)" for any halt at all. koti halts on
    EBREAK and the firmware reaches EBREAK from places that mean opposite things:
    SBI SRST, which is what a finished boot asks for, and its own panic path, which
    prints '!' and stops. Both printed PASS. Until the commit before this one there
    was a third and worse case, a kernel WARN_ON, which also halted.
    So the bench now requires the machine to have SAID it got there — the line
    sw/linux/init.S writes immediately before asking for power-off, which is the
    one point in this boot where userspace has demonstrably run. Proven in both
    directions with hand-built images: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
2026-08-05 The boot never got past a self-test of a hash koti does not use
    random.c selects CRYPTO_LIB_BLAKE2S, whose module_init runs
    if (!IS_ENABLED(CONFIG_CRYPTO_MANAGER_DISABLE_TESTS) &&
    WARN_ON(!blake2s_selftest())) ...
    and with CONFIG_CRYPTO off that symbol does not exist ANYWHERE in the tree. So
    IS_ENABLED() is false, the self-test is unconditional, and there is no way to
    switch it off from outside the crypto menu. CONFIG_CRYPTO is enabled here for
    that one reason and not for cryptography: it is the gate that makes the disable
    symbol exist.
    What it was costing, measured on run 31031529894: the boot enters
    blake2s_mod_init at ~27.2M clocks and is STILL INSIDE IT at 60M. More than 3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
2026-08-05 Build a userspace koti can actually execute
    Ladder item 7. sw/linux/init.S is a twenty-instruction stand-in that prints one
    line and asks for power-off — it proves execve works and nothing more. A
    machine you can use needs a shell, a shell needs a libc, and an rv32 libc is
    precisely what Ubuntu's cross-toolchain does not ship. That is why linux.yaml
    can avoid Buildroot for the kernel, which is freestanding and links no libc,
    and cannot avoid it here.
    Kept out of the ordinary path deliberately. Buildroot builds a whole toolchain
    from source, roughly forty minutes cold, and putting that in front of every
    push to src/ would make the CPU regression loop unusable. So this runs on
    demand and it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
    [check_rootfs.py]
2026-08-05 A "want n" assertion was being satisfied by symbols that do not exist
    The first Buildroot fragment spelled the ISA symbols BR2_RISCV_ISA_CUSTOM_RVM
    and friends. The real names have no CUSTOM_. Every line was therefore a no-op,
    and `make olddefconfig` resolved to RVF=y and RVD=y — a toolchain emitting
    floating-point instructions for a core with no FPU, which would have boarded a
    perfectly healthy kernel and died at execve.
    What makes that worth a commit message is HOW it nearly got through. The
    checker asked for CUSTOM_RVF=n and CUSTOM_RVD=n and both PASSED, because an
    absent symbol reads as "off". Only the two `want y` lines failed and gave the
    game away. A checker whose symbol names are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
    [check_config.py, check_rootfs.py]
2026-08-05 Double-precision is hidden by single, so absence there is legitimate
    The strict absence check added in the previous commit did its job twice over:
    first it caught RVF=y (floating point on, for a core with no FPU), and then it
    flagged RVD as absent. RVD is a different case, and worth distinguishing rather
    than papering over.
    BR2_RISCV_ISA_RVD depends on BR2_RISCV_ISA_RVF. With F asserted off — verified
    in the resolved config as an explicit "# BR2_RISCV_ISA_RVF is not set" — D
    cannot be reached at all and Buildroot drops it. So the guarantee for D is
    carried by the assertion on F, and demanding an explicit "is not set" for a
    symbol that structurally cannot exist would be noise.
    That is t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
    [check_rootfs.py]
2026-08-05 Every random number was costing a BLAKE2s hash of the whole entropy pool
    The boot was not stuck after the PLIC probe. The traced run 31038739162 shows a
    completely healthy kernel in that window — __schedule, try_to_wake_up,
    enqueue_task_fair, rcu_qs, devtmpfsd — multitasking and making progress. What it
    was doing was hashing.
    Until the CRNG is seeded, crng_init is CRNG_EMPTY, and crng_make_state() takes a
    branch that runs a full extract_entropy() — a BLAKE2s hash of the entire input
    pool — on EVERY random draw. Straight off the disassembly at c01d4534:
    lw a4,1724(a4) ; crng_init
    bnez a4,0xc01d454c ; non-zero: skip
    jal 0xc01d4260 ; extract_en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
2026-08-05 The devicetree blob and the firmware that carries it
    Regenerated for the rng-seed change in the previous commit. koti.dts is the
    source but sw/linux/koti.dtb is what actually ships: sw/sbi/dtb.S .incbin's it
    into flash at 0x6000, which is where sbi.c looks for the machine description
    before entering a kernel, and the build host had no dtc until now.
    dtc 1.7.0 is installed under WSL as of this commit, so this no longer needs a
    CI round trip: the blob compiles with no warnings, round-trips identically
    through `dtc -I dtb -O dts` (which is the staleness test the dtb job runs), and
    the firmware rebuild puts d00dfeed back at flash 0x6000.
    Verified locally rather than assumed: test/run.py is 10/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
2026-08-05 4.09 MiB of glibc does not fit in a 12 MiB machine
    The first rootfs that built was the base defconfig's glibc, and it came out at
    4.09 MiB with everything already stripped:
    1634664 lib/libc.so.6
    1174756 lib/libm.so.6
    939668 bin/busybox
    185244 lib/ld-linux-riscv32-ilp32.so.1
    157204 lib/libgcc_s.so.1
    2.8 MB of that is glibc. It cannot fit, because an initramfs costs its size
    TWICE at the peak — once as the cpio embedded in the kernel Image and again as
    the unpacked files in tmpfs — against a 12 MiB window where the kernel and its
    early allocations already spend about 3.8 MB. The boot log says it plainly:
    "Memory: 8468K/12288K available".
    musl folds libm into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
    [check_rootfs.py]
2026-08-05 The heartbeat was splitting kernel messages, and the greps depended on it not to
    Ratcheting the boot job's assertions forward exposed a flaky-test generator
    sitting underneath them. tb_boot writes characters with $write, which appends
    no newline, and the progress heartbeat used $display, which does. A heartbeat
    arriving mid-message therefore cut it in half:
    [ 0.000
    [tb_boot: 10 Mclk, 1903 chars]
    151] sched_clock: 64 bits at 25MHz
    That is copied out of run 31042251426, not invented. Every grep in the `boot`
    job then fails on a boot that was perfectly healthy. The kernel spends only
    about 1% of its clocks transmitting, so it lands rarely — rare enough to look
    like flakiness,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
    [tb_boot.v]
2026-08-05 Assert the CRNG is seeded, because losing it costs a third of the machine
    "random: crng init done" now prints at kernel time 0.000000, which is the seed
    being credited before anything else runs. Before the seed the line did not
    appear at all — the CRNG was never initialised for the whole boot.
    This is a performance assertion, not a security one. While crng_init is
    CRNG_EMPTY, crng_make_state() runs a full extract_entropy() — a BLAKE2s hash of
    the entire input pool — on every random draw, and the kernel draws constantly.
    That was 34% of all machine time on run 31038739162 and is what made the boot
    look stuck after the PLIC probe.
    The seed comes from /chosen/rng-seed and is credited on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
2026-08-05 A machine with a login prompt never halts, and the bench required it to
    The musl rootfs built at 1.14 MiB — down from 4.09 — and reading what is
    actually inside it settled the last design question. Buildroot ships its own
    /init, which mounts devtmpfs and execs busybox init, and the inittab already
    carries
    hvc0::respawn:/sbin/getty -L hvc0 0 vt100
    so on real hardware this rootfs gives a login prompt on the serial console.
    That is the goal. It is also, under the old bench rules, a failure: getty
    respawns forever, the machine correctly never halts, and tb_boot would burn the
    clock limit and report INCOMPLETE for a computer that had done everything asked
    of it.
    "A successful boot END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
    [check_rootfs.py, tb_boot.v]
2026-08-06 The board is on the bench, so bring-up is work and not a wait
    The ULX3S 85F arrived 2026-08-06. PLAN.md's hardware section was headed
    "needs the board in hand", which is now the one thing it does have.
    Two corrections while here, both about not over-reading the arrival: the
    Tiny VGA Pmod is still in transit but gates only the font glyph visual
    check, not the kernel ladder (whose console is the UART); and the first
    real risk on the board is SDRAM RD_ADV, since the part is clocked on ~clk
    and a late read window is silent on writes while corrupting every read.
    Claude-Session: https://claude.ai/code/session_012u1fUbE1qFLtiPyu6Y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
2026-08-06 The bench decided PASS or INCOMPLETE and nothing ever read it
    Three runs were dispatched on 2026-08-05 to answer "does koti reach userspace?".
    All three are green in the run list. None of them reached userspace, and two
    never ran a single instruction in user mode:
    31042403683 maxclk=70M, went silent after the PLIC probe at ~26.8M clocks
    and stayed silent for the whole 15M quiet window: INCOMPLETE
    31045107094 maxclk=20M, hit the clock limit at "futex hash table entries",
    about 0.29 s of kernel time in: INCOMPLETE
    Two independent holes let that happen, and they are different bugs.
    INCOMPLETE ends with $finish rather than $fatal, so vvp exits 0, and no ste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
    [check_initramfs.py]
2026-08-06 A partial boot must not wear a badge that reads like a full one
    The verdict gate added in the previous commit was right about the hole and wrong
    about where to put it, and the difference matters enough to separate.
    Reaching a shell is on the order of 1e8 clocks. A runner does about 25k
    clocks/s, so that is upwards of an hour, and requiring it on every push to src/
    would have replaced a check that could not fail with a check nobody can afford
    to run. The `boot` job's actual value on a push is regression cover for the two
    CPU defects it found -- the AMO/page-walk livelock and the dropped-request
    deadlock -- and both show up in the first few million clocks.
    So the claim is now declared by the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
2026-08-06 S40network waits 15 seconds for an ethernet koti does not have
    375 million clocks, spent before S99koti runs, against a full-boot budget of
    250 million. The queued full=yes run could not have succeeded, and would have
    come back INCOMPLETE after an hour with the machine working perfectly.
    The base is qemu_riscv32_virt_defconfig, which has a virtio NIC and so sets
    BR2_SYSTEM_DHCP="eth0". That is inherited configuration for hardware koti does
    not have and will not have -- there is no MAC anywhere in src/. Buildroot turns
    it into an /etc/network/interfaces stanza with `wait-delay 15` and ships
    /etc/network/if-pre-up.d/wait_iface, which is explicit about what it does:
    if [ "${IF_WAIT_DELAY}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
2026-08-06 The other five init scripts are clean, and the next suspect is the console
    Audited the rest of what rcS runs, because finding one 375M-clock trap by
    reading is a poor reason to assume there is only one. S01seedrng, S01syslogd,
    S02klogd, S02sysctl and S50crond do not block at boot: every `sleep` in them is
    in a `stop` path that never runs on the way up, and S02sysctl's two `while :;`
    loops are `read`-driven over a `find` pipeline and terminate on EOF. S40network
    was the only one.
    That leaves one thing not ruled out, and it is worth writing down before it
    costs an hour: whether userspace has a console at all.
    The kernel prints through the SBI earlycon, which is a BOOTconsole. Userspace
    does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
2026-08-07 The bench was written for Verilator and the workflow only ever ran iverilog
    test/tb_boot.v says it in its own header -- plain Verilog "so it runs under
    BOTH iverilog (for a short look) and Verilator (for a whole kernel boot, which
    is tens of millions of clocks and out of iverilog's reach)" -- and
    .github/workflows/linux.yaml installs iverilog and nothing else. The bench was
    ready for this from the day it was written.
    It matters because of what the slow engine cost. Reaching userspace is ~1e8
    clocks and iverilog does ~25-29k clocks/s on a runner, so the run that answers
    the one open question about this machine takes an hour, which is why `full` had
    to become a declared opt-in rather than a p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
    [tb_boot.v]
2026-08-07 A comment that begins with the word verilator is a pragma, not a comment
    %Error: test/tb_boot.v:120:5: Unknown verilator comment:
    '/*verilator is 2-STATE — every variable starts at 0 — so ...*/'
    The line was `// Verilator is 2-STATE — every variable starts at 0 — so at the
    first`, written in the previous commit to explain the reset gate it added. A
    `//` comment whose first word is "verilator" is a lint pragma, case
    insensitively, so prose that opens by naming the tool is parsed as a directive
    to it. Reworded to "The other engine"; the sentence is unchanged otherwise.
    It is a hard %Error in 5.020, not a warning, so -Wno-fatal does not cover it and
    the whole build sto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
    [tb_boot.v]
2026-08-07 Verilator boots this kernel 60x faster, and the trace it printed was garbage
    Two measurements and one bug, all from the new job's first three runs.
    MEASURED, same runner, same image: Verilator does 1.6-2.0M clocks/s where
    iverilog does 25-29k. 20M clocks took 10 seconds against roughly thirteen
    minutes, and the FULL 250M-clock boot took 156 seconds in CI and 91 on the
    development host. The hour that forced `full` to be an opt-in was a property of
    the simulator, not of the machine.
    So `verilator: yes|no` becomes `engine: iverilog|verilator|both`. A push leaves
    it null and gets iverilog exactly as before; `both` runs the two engines on one
    image, which is how they get compared. The combinati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
    [tb_boot.v]
2026-08-07 koti reaches userspace: 486,454,208 clocks, and the budget was the whole problem
    [ 10.843467] printk: legacy console [hvc0] enabled
    [ 12.453167] Run /init as init process
    Starting syslogd: OK ... klogd: OK ... sysctl: OK ... crond: OK
    Linux buildroot 6.12.0 #1 riscv32 GNU/Linux
    MemTotal: 8868 kB
    koti: userspace is alive
    --- tb_boot: PASS (userspace ran)
    In simulation, on the ULX3S machine configuration, with sim_mem in place of the
    memory controllers. Not on hardware. But `init` has run, execve has happened,
    and busybox printed on a CPU built from scratch -- which is the thing this
    project has been unable to say.
    NOTHING WAS BROKEN AND NOTHING WAS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
2026-08-07 The standing gate is live, and two things it would have tempted someone to do
    The push at c830c1b ran `boot-verilator` with `full=yes maxclk=700000000` and came
    back `PASS (userspace ran)` in about five minutes. So the userspace claim is now
    checked by every push to src/, sw/linux/ or the bench, and it will go red the day
    it stops being true. That was the whole object of the exercise.
    Two notes, both of which say "do not do the obvious thing":
    1. EMBEDDING THE INITRAMFS UNCOMPRESSED IS A NET LOSS ON HARDWARE, so it was not
    done. CONFIG_INITRAMFS_COMPRESSION_NONE=y would delete inflate_fast -- 27% of
    trace samples, ~5.6 s of a 19.5 s boot -- and grow the Image from 3.95 MB to
    rough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
2026-08-07 A boot flash in fabric, because J1 is bare holes and the Pmod has not arrived
    koti boots by XIP from flash address 0, so with nothing on J1 the CPU cannot
    fetch one instruction and the board could only ever be checked as far as
    README step 2 -- "it configures and nothing is stuck". The Cartridge Pmod is
    still in transit. fpga/ulx3s/bram_flash.sv is a QSPI *device* on those same
    eight uio wires, backed by the 85F's own block RAM, so the SoC boots with
    NOTHING plugged in.
    It emulates the device rather than bypassing the controller, which is the whole
    point: qspi_ctrl, arbiter3 and icache are untouched and all still run, and the
    RAM half of the map still goes to the real SDRAM controller -- so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
    [bram_flash.sv, check_pins.py, mkflashhex.py, tb_fpga_bram.v, ulx3s_top.sv]
2026-08-07 The banner cannot be read, because reading it is a race against 5 milliseconds
    koti IS alive on the board. The bram bitstream went on (fujprog, 60.30 s), the
    serial port was held open for five minutes, and it collected 219,995 BYTES OF
    MOJIBAKE. That is not a failure, it is the diagnosis:
    sw/hello.c prints its banner and then calls con_init(), which sets VGA_EN --
    and VGA_EN moves the UART from uo[0] to uo[6] and turns uo[0] into an RGB bit.
    With SW3 off the host is watching uo[0], so after 5 ms it is decoding koti's
    VIDEO RASTER as 8N1. A machine doing everything right produces an endless flood
    of garbage, and the one line worth reading went past 5 ms after configuration --
    while fujprog w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
    [build.py]
2026-08-07 Rung 0: koti runs on the real ULX3S
    Koti-1: hello from my own SoC #4 0123456789 abcdefghijklmnopqrstuvwxyz
    ... through #34
    31 lines, 31 exact matches, 0 malformed, counter monotonic and gapless, 0
    non-printable bytes, 2257 bytes on COM3 at 115200 8N1. Not simulation. Bitstream
    from run 31160222996, flashed with fujprog (SRAM, 59.69 s).
    WHAT THE LINE PROVES, which is why it carries a counter and an alphabet:
    - The fabric flash works. Every instruction was fetched through the real
    qspi_ctrl, arbiter3 and icache from bram_flash, with NOTHING plugged into J1.
    - THE SDRAM WORKS AND RD_ADV IS CORRECT ON THE FITTED PART. This was the top
    bring-up risk in the whole project -- t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
2026-08-07 Rung 0 proved the SDRAM's read timing; this walks its address decode
    sw/memtest.c, and the distinction is the point. Everything rung 0 touched lives
    in the first few kilobytes of a 16 MB window: bank 0, row 0, a handful of
    columns. That proves RD_ADV -- a read window off by one clock corrupts every
    read -- and nothing about whether two different addresses are the same location.
    That failure never announces itself. A row or bank bit mis-wired, mis-ordered or
    simply not decoded means the machine occasionally reads back something it never
    wrote, which under Linux is a corrupted page table ten million instructions
    after the actual fault.
    SO THE PATTERN IS DERIVED FROM THE ADDRESS, which is the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
    [build.py, memtest.c]
2026-08-07 The 16 MB walk is clean on the real part, four passes, zero errors
    Koti-1 memtest pass 1
    64K : write read OK
    lanes: OK
    16M : write read OK
    pass 1 CLEAN, errors: 0
    Every one of the 4 million words in the window holds exactly what was written,
    with an ADDRESS-DERIVED pattern -- so any aliasing anywhere in the row, bank or
    column decode would have shown up, and the report would have named the colliding
    address. The byte/halfword lane test passes as well, covering the be/DQM path a
    word walk never touches.
    So the onboard SDRAM is now validated on hardware in all three ways that matter:
    read TIMING (RD_ADV, from rung 0's return addresses), ADDRESS DECODE (this walk),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
    [sdram_model.sv]
2026-08-07 The bring-up README said nothing here had ever been on hardware
    It has now, and a procedure that contradicts itself is worse than one that is
    merely out of date -- someone follows the first half and distrusts the second.
    - The header claimed nothing in the directory had run on hardware. Steps 0-2b
    have; 3-7 have not, and the reason is Pmods rather than doubt.
    - The "what is proven" table listed the board, the revision and signal
    integrity as open. All three are closed, with what closed them.
    - Step 1 asked the reader to check the silkscreen. Settled: PCB v3.1.8, and
    only wifi_gpio0 differs, so it does not matter.
    - Step 2 still said `openFPGALoader`. On this board that tool nee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
2026-08-07 The SD rung: block reads, verified against a card model before the SoC
    tb_sd: init status after init = 00000001
    tb_sd: block 0
    tb_sd: block 12345
    --- 0 error(s) --- tb_sd: PASS
    WHY THE SD CARD, since it is two jobs and only one is the rootfs. One: getting
    software IN. The kernel is 3.95 MB and today's only proven path is 32 KB of
    fabric flash baked into the bitstream, so every software change is a 7-minute
    place-and-route and a kernel does not fit at all. Two: making files PERSIST.
    The rootfs is currently an initramfs inside the kernel image, so nothing
    survives a reboot and changing userspace means rebuilding the kernel. One
    peripheral serves both.
    VENDORED, NOT WRI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
    [sd_card_model.sv, sd_ctrl.sv, tb_sd.v]
2026-08-07 The SD card is on the SoC's bus, and koti's own CPU reads blocks from it
    Koti-1 sdtest pass 0
    init: OK
    block 0: 00 07 0e 15 1c 23 2a 31 38 3f 46 4d 54 5b 62 69
    reread: identical
    block 12345: differs from block 0, as it must
    pass CLEAN
    In simulation, through the whole machine: sdtest.bin executing out of the fabric
    flash, driving src/sd_ctrl.sv over the real data port, through vendor/sd_spi.sv,
    into test/sd_card_model.sv. Every byte of block 0 is the model's own payload
    function, and the two properties that hold for any real card are checked too --
    a block reads the same twice, and a different block reads differently.
    ⚠️ ADDING AN MMIO WINDOW TAKES TWO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
2026-08-07 A provenance claim I wrote was stronger than the evidence
    vendor/README.md said console "loaded games off a microSD card" on this board.
    It did not. The session board says on hardware "the SD loader completed its
    NO-CARD path" -- console`s game came from bram_cart.sv, a QSPI device in fabric.
    So the card-READING path is simulation-only in both repos, and koti`s first
    hardware attempt today is first contact for it rather than a regression.
    First hardware result, recorded as-is: init returns SD_ERR (status 00000004)
    every pass, at 29.45 MHz post-route. The machine itself is fine -- it prints its
    verdict forever and the bounded waits mean a dead card cannot hang it, which is
    what the image was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
2026-08-07 The SD bus belongs to the ESP32, and we had been switching the ESP32 ON
    The card is in the slot and init still returned SD_ERR every pass, so it is not
    an empty slot. Two things found by READING upstream's constraint file rather than
    by another round trip, and together they explain it:
    1. THE SD BUS IS THE ESP32's GPIOs. Upstream says so in the file:
    # wifi_gpio2,4,12,13,14,15 are shared with SD card.
    sd_clk=GPIO14, sd_cmd=GPIO15, sd_d[0]=GPIO2, sd_d[1]=GPIO4, sd_d[2]=GPIO12,
    sd_d[3]=GPIO13. An ESP32 that is awake and driving any of those beats the
    FPGA on that line.
    2. F1 IS THE ESP32's ENABLE ON A v3.0.x BOARD, and we were pulling it HIGH.
    Upstream's v3.1.6 file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
2026-08-07 Hold BOTH candidate ESP32 enables low, because the revision is still not settled
    Driving F1 low did not fix the card, and it did NOT power-cycle the board either
    — which retires the old warning attached to that pin but leaves the ESP32
    question open. The reason is that F1 is only the enable on ONE of the two
    candidate revisions:
    v3.0.x : F1 = wifi_en (L2 = wifi_gpio0)
    v3.1.x : F1 = wifi_gpio0 (L2 = wifi_gpio22, wifi_en on J5)
    So if this board is a v3.1.x, F1 low merely puts the ESP32 into download mode
    while its actual enable, J5, was never constrained at all — left to whatever the
    board pulls it to, i.e. possibly awake and holding the SD lines it shares with
    the FPGA.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
    [check_pins.py, tb_fpga.v, tb_fpga_bram.v, ulx3s_top.sv]
2026-08-07 Let software drive the four SD wires itself, so a silent card stops looking like a broken engine
    `sdtest` returns SD_ERR on hardware while `tb_sd` and `tb_fpga_bram +mark=1` stay
    green. Those two facts cannot be reconciled by more simulation: `sd_card_model.sv`
    answers whenever it is clocked, so a green bench proves the engine talks to a
    MODEL and says nothing about whether a card is electrically present. Every extra
    bitstream aimed at the ESP32 was guessing at which half of the problem to fix.
    SD_RAW at +0x0C mixes the pins away from `sd_spi` and gives them to software:
    write CS/SCK/MOSI, read MISO live off the pin. `sw/sdraw.c` hand-clocks CMD0 at
    ~60 kHz and prints every byte. One round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
    [build.py, koti.h, sd_ctrl.sv, sdraw.c, tb_fpga_bram.v, ulx3s_top.sv]
2026-08-07 Drive the MISO pin, because an input that reads 0 cannot say WHY it reads 0
    The escape hatch worked and the answer was not one of the two expected. On
    hardware MISO reads 0, not 0xff — and with the slot EMPTY it still reads 0. So
    the resting level of that line on this board is low, which means "idle MISO: 0"
    was never evidence of anything and the all-00 CMD0 response carries exactly the
    meaning all-ff would carry on a pulled-up board: the card never drove the line.
    That leaves two possibilities an input pin physically cannot separate. Either
    the card is not making contact, or J3 is not the card's MISO on this board. Both
    produce 00 forever. An OUTPUT can separate them: drive the pin high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
2026-08-07 The SD card reads on real hardware, and the bug was a bare 1'bz
    `assign sd_d[0] = 1'bz;` gives yosys nothing to build a tristate out of, so the
    port collapsed to a plain input — and on a plain input the LPF's PULLMODE=UP did
    not take effect. The MISO line floated LOW, every byte clocked in off the card
    read 0x00, sd_spi never saw a response, and sdtest reported
    `init: FAILED, status 00000004`, which reads exactly like "no card".
    The two nextpnr logs say it plainly:
    before: pin 'sd_d[0]$tr_io' constrained ... (no $iobuf_i at all)
    after: $sd_d[0]$iobuf_i: sd_d_$_TBUF__Y.Y (a real tristate)
    The continuity test added for diagnosis is what fixed it, by accident: muxing a
    d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
    [sdtest.c, ulx3s_top.sv]
2026-08-07 Write down the SD rung and the trap that cost a day, where the next person will look
    The bring-up README gains step 2c: the passing output, and — more useful — the
    `init: FAILED, status 00000004` triage note. That message reads exactly like "no
    card", and on 2026-08-07 the card, the seating and the ESP32 were all innocent;
    the cause was `assign sd_d[0] = 1'bz;` collapsing to a plain input whose
    PULLMODE=UP never took effect. The note gives the nextpnr log line that tells
    the two apart, and says plainly that the tristate mux is load-bearing and that
    CI cannot catch its removal because the sim model brings its own pull-up.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
2026-08-07 The harness suite has been red since the SD rung landed, and every step a human reads was green
    `test` last passed at 7ab7a3d. It went red at 05430e7 — the commit that put
    sd_ctrl into project.sv under KOTI_FPGA — and has been red on every push since,
    including four of mine. Nobody noticed because the failure is in
    `run_fpga.py`, whose source list was never given the SD files, while the two
    benches anyone would think to check (`tb_sd`, `tb_fpga_bram`) are separate steps
    and both green. The suite reported success in every place a person looks and
    failure only in the whole.
    The error was not subtle once read: `Unknown module type: sd_ctrl`,
    elaboration, whole harness suite dead. Not a mis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
    [run_fpga.py]
2026-08-07 The kernel arrives by microSD, and two benches that had quietly stopped building
    TRANSPORT. koti boots out of a 32 KB block RAM and the kernel is 3.95 MB. The
    UART would take ~343 s per attempt, baking it into the bitstream is a
    place-and-route per kernel, and the board's SPI flash needs pins that are not in
    the LPF. The card does it in about four seconds and the slot is onboard.
    sw/sbi/sdboot.c reads a header block at LBA 2048, loads the image straight into
    RAM at 0x0140_0000 and checksums it; boot_target() then finds the Image magic
    that was already being looked for and boots it. tools/sdkernel.py writes that
    layout, to a real card or to a file. Every failure path returns 0 having changed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
    [build.py, sbi.c, sd_card_model.sv, sdboot.c, sdboot.h, sdkernel.py, tb_fpga_bram.v]
2026-08-07 Let the bitstream carry the firmware that boots Linux
    `image: sbi` bakes sw/sbi/sbi_test.bin into the fabric flash instead of one of
    the sw/*.bin diagnostics. It is the odd one out in two ways worth writing down
    next to the option: it lives in sw/sbi/ rather than sw/, and it is the only
    image that enables VGA — which hands uo[0] to the raster and mirrors the UART
    on uo[6], so DIP SWITCH 3 has to be ON or the console is mojibake.
    Claude-Session: https://claude.ai/code/session_019xiRM2ypTApJuMUjyPoGGi
2026-08-07 HDMI on koti, by vendoring the encoder that already drove this board
    Video signals leave the SoC raw now — video_rgb/hs/vs/de, FPGA-only — and
    ulx3s_top drives a 125 MHz PLL and dvi_tx onto the four GPDI pairs. The encoder
    trio (tmds_encoder.sv, dvi_tx.sv, pll_25_125.v) is a VERBATIM copy of console's,
    which put colour bars on the user's real monitor from a ULX3S 85F v3.1.8 on
    2026-08-06. A TMDS encoder is 8b/10b with DC balance, a 5:1 serialiser and a
    125 MHz DDR domain, where every bug looks like "no signal" — not where original
    work belongs. Same call as vendor/sd_spi.sv.
    koti's port is SIMPLER than console's, and the reason is worth recording:
    console's SoC exposed only its eight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
    [check_pins.py, project.sv, run_fpga.py, sim_prims.v, ulx3s_top.sv]
2026-08-07 The firmware has to know which machine it is on, because the microSD window does not always exist
    `test` went red on four SBI tests with "UART stalled" — my fault, from the
    previous commit. The ASIC-shaped bench has NO microSD window at all:
    koti_core.sv's `pa_dev` stops at 0x04 without KOTI_FPGA, so 0x0005_0000 is
    flash-read-only there. A write takes a store access fault and a read never
    acks, and the firmware hung in the loader before it could decide anything.
    This cannot be fixed with a runtime probe, and that is the whole point: probing
    means touching the address, which is the thing that hangs. The machine has to be
    known when the firmware is BUILT. So build.py now emits two binaries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
    [build.py, sbi.c]
2026-08-07 tb_boot does not need a DVI transmitter
    The previous fix gave tb_boot `vendor/*.sv` to repair its missing sd_spi, and
    the HDMI port then put dvi_tx.sv in that directory — so the boot bench started
    compiling a DVI transmitter and died on ODDRX1F, an ECP5 hard block it has no
    model for. tb_boot drives project.sv directly and never instantiates the ULX3S
    harness, so it has no business compiling the harness's video encoder at all.
    Now it gets the two files it actually uses, by name. A glob was the wrong shape
    here: it silently widens every time something is added to vendor/, which is
    exactly what happened, one commit after the glob was added to fix the opposite
    problem.
    Note boot-verilator w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
2026-08-07 Linux is on the monitor: write down the whole machine while it is true
    Confirmed on hardware 2026-08-07: the Linux boot log renders on the HDMI monitor
    and ends at `buildroot login:`, with the same log on the serial console. koti now
    has a CPU, an MMU, RAM, storage, an OS and a screen.
    ⭐ The text appears with NO framebuffer driver and no Linux video support at all,
    and that is worth writing down before someone re-derives it: SBI
    console_putchar calls putc_both(), which writes the UART AND the 40x30 VGA text
    buffer, and Linux's console is hvc0 over SBI. Nothing in the kernel knows the
    video hardware exists. A real framebuffer is separate, later work — calling this
    one would overstate it.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
2026-08-07 The keyboard rung: a USB HID host on US2, and the last thing between koti and a usable computer
    koti had a CPU, an MMU, RAM, storage, an OS and a screen, and no way to type.
    The UART is transmit-only and console_getchar read a PS/2 block for which there
    is no keyboard, so the login prompt could be looked at and not answered.
    THE CORE IS VENDORED, per the standing rule that a protocol someone else has
    working is not where original work belongs — the same call as vendor/sd_spi.sv
    and console's gamepad_pmod.v. nand2mario/usb_hid_host is Apache-2.0 (koti's
    licence), needs no CPU, is under 300 LUTs, and its author ships a ULX3S example
    that this wiring follows. It uses usb_fpga_bd_dp/dn (D15/E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
2026-08-07 The keyboard types into Linux, and the layout is Finnish
    Confirmed on hardware 2026-08-07: a USB keyboard on US2 enumerated, and
    characters typed on it reached Linux and echoed back through hvc0. The whole
    chain works — enumeration, HID report, the 12 to 25 MHz toggle crossing, the
    held-to-pressed edge detection, the FIFO, SBI console_getchar, the busybox line
    editor, and back out the UART.
    `a b c` produced exactly three events rather than a flood of repeats, and shift
    produced `A`, so the edge detection and the modifier path are both right.
    THE ONE THING THAT WAS WRONG WAS THE KEYMAP, and it identified itself in a
    single keystroke: `-` arrived as `/`. HID usage codes name a physical KEY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
    [usbkbd.c]
2026-08-07 The rootfs rung, part one: a block driver, and the finding that shapes the rest
    ⛔ THE HARDWARE CANNOT WRITE. vendor/sd_spi.sv implements CMD0, CMD8, CMD55,
    ACMD41, CMD58, CMD16 and CMD17. There is no CMD24, so no block can be written
    at all. PLAN.md item 7 defines this rung as PERSISTENCE, and persistence is
    therefore a GATEWARE change before it is a software one — and a gateware change
    in a vendored file, which per vendor/README.md means changing console's copy and
    re-vendoring rather than editing here.
    So this is the half that needs no gateware, and it is the half everything else
    stands on: the block driver, the devicetree node, the partition layout and the
    mount path. Writes then bec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
2026-08-07 The card is 61067264 sectors, not the 61071360 I guessed
    koti.dts declared a capacity derived from the rounded 29.12 GB figure. The card
    measures 61067264 sectors, so the declaration was 4096 sectors TOO LARGE — in
    exactly the direction the comment beside it warns about, which is the direction
    that matters: too small merely hides the tail of the card, while too large lets
    the partition scanner read past the end and report IO errors on a card that is
    perfectly healthy.
    Caught by reading the size off the host before writing anything, rather than by
    watching Linux fail to find a partition later. The comment now says the number
    is MEASURED and records what the wrong value was, because a plaus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
2026-08-07 A dynamic major requires minors == 0, and the kernel says so with a backtrace
    The driver probed and failed with -EINVAL on real hardware:
    WARNING: CPU: 0 PID: 1 at block/genhd.c:439 device_add_disk+0x27c/0x384
    koti-sd 50000.mmc: probe with driver koti-sd failed with error -22
    genhd.c:439 is `WARN_ON(disk->minors)` inside device_add_disk()'s `major == 0`
    branch, and the register dump names the culprit outright: a5 = 0x00000008, the
    `minors = 8` this driver set, and s2 = 0xffffffea, the -22 it returned.
    The comment beside it said "room for a partition table", which is how partitions
    worked a long time ago and is not how they work now. With a dynamic major the
    kernel allocates an ext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
    [koti_sd.c]
2026-08-07 A real filesystem mounts on real hardware
    kotisd: kotisd1 kotisd2
    koti-sd 50000.mmc: 61067264 sectors (29818 MiB), read-only
    # mount /dev/kotisd2 /mnt
    # cat /mnt/README.txt -> the file, byte-exact
    Every layer at once: the driver probed from the devicetree, reported the right
    capacity, the partition scanner read the MBR off the card and found both
    partitions, ext2 mounted, and a file came back unchanged.
    ⛔ This is the READ half. The hardware cannot write — vendor/sd_spi.sv has
    CMD17 and no CMD24 — so files can be placed from a PC and read on koti, and
    nothing can be saved from koti. Writes return EROFS by design rather than
    appearing to work. Persistence is a gate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
2026-08-07 The write half: the microSD can be written, so a filesystem can be saved to
    Four pieces, in the order they had to be built.
    THE ENGINE. CMD24 was added upstream in console and re-vendored (9d75e1c), per
    vendor/README.md. A write is not a read with the arrows reversed: after the
    card takes 512 bytes and two counted-but-ignored CRC bytes it answers a data
    response token, and then goes BUSY for milliseconds, holding MISO low while it
    erases and programs. Nothing on the read path waits for anything like that.
    THE CONTROLLER. src/sd_ctrl.sv gains a 512-byte write buffer that the engine
    PULLS from — it drives wptr and gets wbyte combinationally, so there is no
    handshake and no way to feed a by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
    [koti.h, koti_sd.c, project.sv, sd_card_model.sv, sd_ctrl.sv, tb_sd.v]
2026-08-07 koti can save a file, and the log line should not say otherwise
    On hardware, 2026-08-08:
    # echo koti wrote this > /mnt/hello.txt
    # sync ; umount /mnt ; mount /dev/kotisd2 /mnt
    # cat /mnt/hello.txt -> koti wrote this
    The unmount is what makes that proof rather than an echo out of the page cache:
    unmounting drops it, so the second read genuinely came off the card. The rootfs
    rung is done in both directions.
    The probe line still said "read-only", which was a stale string rather than
    stale behaviour — set_disk_ro was already gone, which is why the write worked at
    all. A log line that contradicts what the driver actually does is worse than no
    line, because the next person read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
2026-08-07 The README described a chip that was never built; describe the computer that exists
    It opened with "One chip that boots full sv32 MMU Linux visibly: monitor on the
    Tiny VGA Pmod, keyboard on PS/2 ... Target: the shuttle after TTSKY26c, 8x2
    tiles." Every clause of that is now wrong. koti is an FPGA computer, the
    keyboard is USB, the screen is HDMI, and it is not going to a shuttle — a
    decision taken 2026-08-02. The status paragraph still said "hardware-complete
    for the goal" about a machine that had never met a board.
    So the README now says what the thing does: logs in, mounts a filesystem, saves
    a file that survives a reboot. Every line in the "what works" table has been
    seen on the bench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
    [screenshot.py]
2026-08-08 The tools could assemble but never disassemble, and that asymmetry cost three diagnoses
    test/run_cpu.py has carried an assembler since the directed tests were
    written; nothing went the other way. So ktrace.py could say which SYMBOL an
    address belonged to and never which INSTRUCTION, which is the question that
    actually ends a search. All three CPU defects found so far came down to
    reading one instruction and asking what should have run next.
    tools/rvdis.py decodes RV32IMA_Zicsr. Linear disassembly is exact here only
    because koti cannot decode compressed instructions and check_config.py keeps
    CONFIG_RISCV_ISA_C off -- on a target WITH the C extension this approach is
    wrong, and wrong silently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
    [ktrace.py, rvdis.py, test_rvdis.py]
2026-08-08 The image you flash when you trust nothing should be one you can read: bringup in assembly
    sw/bringup.c -> sw/bringup.S. This is the only image in sw/ that gets the
    treatment, and the criterion is not "assembly is better". Every other
    instrument encodes a PROTOCOL -- SPI command sequences, HID report decoding, a
    keymap -- and C represents those better. This one encodes nothing. Its stated
    design goal was to "depend on as little as possible", and a compiler is a
    dependency: it decides what to keep in registers, what to spill, and what to
    delete. Not a theoretical objection -- the delay loop already needed
    `volatile` because -O2 deleted it, which would have turned a 0.4 s pause into
    a flood no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
2026-08-08 Move root onto the card, by switch_root rather than by root=, so a missing card cannot brick the boot
    Until now the rootfs was an initramfs in RAM: every boot started from an
    identical image and nothing written survived a power cycle. This puts it on
    the microSD's p2, which is what makes koti REMEMBER.
    WHY NOT SIMPLY root= WITH THE INITRAMFS DELETED, which is the obvious reading
    of "root= onto the card". Because the kernel's own root= handling answers an
    absent, unformatted or corrupt card with a panic, and that turns a missing
    card into an unbootable board. sw/sbi/sdboot.c settled this same question one
    layer down for the KERNEL transport -- every failure path returns 0 having
    changed noth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
    [check_initramfs.py]
2026-08-08 Regenerate the DTB and the firmware that carries it
    Changing koti.dts bootargs left the committed koti.dtb stale, and the firmware
    embeds that blob at flash 0x6000 -- so sbi_test.bin and sbi_sd.bin were
    carrying a devicetree without root= while the source had it. CI's `dtb` job
    caught it, which is what it is for.
    Missed on my side, not a gate that failed: the workflow's own message says to
    regenerate both, and only the .dts was edited.
    Claude-Session: https://claude.ai/code/session_01Gy1XTjSMoLnrAC3YtDRwCA
2026-08-08 Remove PS/2: its replacement has typed on real hardware, which was the condition
    PLAN.md's standing rule was that PS/2 stays until the USB HID keyboard types a
    character on the real board. That happened on 2026-08-07, so the whole path
    goes: src/ps2_rx.sv, sw/ps2kbd.c/.h, the MMIO word at 0x0004000C, the ps2_gp
    pins and their LPF constraints, three cocotb tests, and the datasheet entries.
    ⭐ THE PART THAT IS NOT DELETION. `kb_avail` was the PLIC's ONLY wired source.
    Removing PS/2 without noticing that would have left the interrupt controller
    Linux binds to with nothing to report -- a functional regression wearing the
    clothes of a cleanup. Source 1 is now `usb_kb_irq`, the USB FIFO's not-em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
    [build.py, check_pins.py, koti.h, project.sv, run_fpga.py, sbi.c, tb_boot.v, tb_fpga.v]
2026-08-08 Two source lists still named ps2_rx.sv, and my search could not have found them
    fpga-ulx3s and test both went red on `File src/ps2_rx.sv not found`. The file is
    gone; two build manifests still listed it: fpga/ulx3s/sources.txt (yosys) and
    test/Makefile (cocotb PROJECT_SOURCES).
    WHY THE SURVEY MISSED THEM, because the lesson is the reusable part. The sweep
    that found every other reference was a grep with --include=*.sv,*.v,*.c,*.h,
    *.py,*.md,*.lpf,*.yaml,*.json. Both files that matter here are extensionless or
    .txt, so the filter that made the search readable is exactly what hid the only
    two files whose job is to LIST source files. An unfiltered grep finds both in
    one line.
    Both lists now c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
2026-08-08 The VGA test was relying on PS/2 to delay VGA_EN, and nobody knew
    test_vga_text sampled 0x88 across the whole row after PS/2 was removed -- video
    timing perfect, glyph absent -- on a change that touched no video logic.
    Row 0's charbuf burst is prefetched during vblank at line 508. If VGA_EN is set
    after that point in a frame, row 0's line buffer is never filled and every
    pixel of it reads as background. The test used to type a PS/2 scancode and wait
    for it to appear on the LEDs BEFORE the program reached VGA_EN, which delayed
    it by thousands of clocks and happened to land outside the window. That delay
    was load-bearing and entirely accidental; removing the keyboard removed it.
    Fixed by sam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
2026-08-08 The keyboard becomes a Linux input device, without taking it away from the console
    koti's keyboard worked but Linux had never seen one. Keystrokes reached it as
    console CHARACTERS -- usb_kbd.sv -> MMIO -> sw/usbkbd.c in the M-mode SBI
    firmware -> console_getchar -> hvc0 -- so there was no /dev/input, no key
    events, and the keymap lived in firmware where loadkeys could not reach it.
    Verified before starting: zero INPUT/HID symbols in koti_defconfig, zero
    keyboard mentions in koti.dts.
    ⛔ THE HARD PART IS NOT THE DRIVER, IT IS OWNERSHIP. Reading the keystroke
    register POPS it, and the firmware is its consumer -- that is what makes the
    login prompt typeable. A driver reading the same register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
2026-08-08 Write down why /dev/input/event0 cannot type at the login prompt, and what would fix it
    Item 9 gave koti an input device. It does not make the login prompt typeable,
    and the reason is worth recording rather than rediscovering: the only thing in
    the kernel that turns input events into console characters is the VT keyboard
    layer, and it feeds VTs, not hvc0. koti has no VT because a VT needs a console
    driver to draw on, and Linux cannot see koti's display at all -- the HDMI text
    is drawn by the FIRMWARE writing the charbuf.
    The non-obvious part, and the reason this is worth doing: the cheap route is a
    TEXT-MODE console driver, not a framebuffer. fbcon wants a linear pixel buffer
    koti does not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
2026-08-08 The workflow edit wrote real newlines where printf needed the two characters \n
    linux.yaml would not parse: GitHub reported "a workflow file issue" rather than
    a build error, because the file never got as far as running. The Kconfig printf
    is a single-quoted format string containing \n and \t, and the script that
    inserted it was itself a heredoc -- so the escapes were consumed one level too
    early and a one-line printf became eight lines of bare Kconfig sitting in the
    YAML.
    Now validated the way it should have been before pushing: yaml.safe_load parses
    the file AND the keyboard step is present in the parsed structure, so a step
    that silently vanished would fail the check too.
    Co-Authored-By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
2026-08-08 A data cache, write-through, because the video DMA reads the memory the CPU writes
    The I-cache took fetch from ~8 clocks per instruction to 1 on a hit and thereby
    moved the bottleneck onto the data side: a random 32-bit SDRAM read is 10 clocks
    measured and roughly a third of instructions are loads or stores, so data costs
    ~3 clocks per instruction against fetch's ~1.
    ⭐ WRITE-THROUGH IS THE WHOLE COHERENCE ARGUMENT, and it is why PLAN.md's
    objection to building this dissolves rather than needing management. The video
    DMA reads the 40x30 charbuf out of the same SDRAM the CPU writes, so a
    write-BACK cache could hold text that never reached the screen. Write-through
    keeps main memory correct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
    [dcache.sv, koti_core.sv, project.sv, tb_dcache.v]
2026-08-08 A fourth source list existed, and a checker so the next one cannot hide
    `test` died on "Unknown module type: dcache": test/run_fpga.py keeps its own
    list of RTL files and was never told about src/dcache.sv. This is the SECOND
    time today the same shape of mistake reddened CI -- this morning two lists
    still named the deleted src/ps2_rx.sv -- and the second one happened after the
    first had been diagnosed, because a lesson with nothing enforcing it is just a
    sentence in a commit message.
    test/check_sources.py now asserts both directions across all four lists:
    STALE a name with no file behind it -> "File not found"
    MISSING a file no list names -> "Unknown module type"
    FPGA-onl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
    [check_sources.py, run_fpga.py]
2026-08-08 Take the D-cache out of the path: it makes the Linux boot print nothing at all
    tb_boot under Verilator with the cache enabled: 700,000,000 clocks, 0
    characters. Not slow -- dead. And tb_fpga_bram PASSED with the same RTL, so it
    fails only in the KOTI_SIMMEM boot configuration, which is the one difference
    between the two benches.
    The cache is now behind `KOTI_DCACHE`, which is defined nowhere, so every build
    takes the bypass. Confirmed the bypass restores the original behaviour exactly:
    tb_fpga_bram is back to 135401 clocks, the same count as before the cache
    existed -- not merely passing, but bit-for-bit the previous machine.
    src/dcache.sv and test/tb_dcache.v STAY, and the CI gate stays g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
    [project.sv]
2026-08-08 Narrow the D-cache boot hang: the firmware is fine, so it needs the MMU
    "700 million clocks, 0 characters" reads as a dead machine. It is not one.
    Running tb_boot with only +flash and no kernel prints "STK" -- 3 characters --
    IDENTICALLY with and without the cache. So crt0's flash->RAM .data copy, the
    M-mode trap shim and the UART all work through it. Together with tb_fpga_bram
    passing FASTER with the cache (135215 vs 135401) and tb_dcache passing all
    three mutations, the cache is fine everywhere except one configuration.
    ⇒ The failure needs a KERNEL. With an Image at 0x01400000 the firmware boots it
    instead of the payload, and that is the only case that fails -- and the kernel
    is the on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
    [dcache.sv]
2026-08-08 The D-cache is correct; koti_core routes the data ack by who is asking, not by who asked
    Traced with the kernel Image pulled from CI, reproduced locally in about a
    minute, and found with the disassembler built earlier today.
    koti_core.sv:
    wire dw_ack = d_ack && dw_req; // the page walker
    wire m_ack_here = d_ack && !dw_req; // the M stage
    The acknowledgement goes to whoever is asserting AT THE MOMENT IT ARRIVES, not
    to whoever issued the transaction. With the arbiter answering directly those
    coincide often enough to work. The cache adds two cycles between accept and
    ack, and the EX-side walker borrows the port "while M is quiet" -- an M stage
    stalled waiting for the cache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
    [dcache.sv]
2026-08-08 Route the data ack by who issued the transaction, not by who is asking now
    A real defect, found while chasing the D-cache, and worth fixing whether or not
    the cache is ever enabled.
    koti_core routed the data-port acknowledgement with live signals:
    wire dw_ack = d_ack && dw_req;
    wire m_ack_here = d_ack && !dw_req;
    But `dw_req` is `(dw_state != 0) && !m_port_busy`, and `m_port_busy` is
    `d_active` — so an M-stage memory op appearing mid-walk WITHDRAWS the walker's
    request while its transaction is still outstanding. This is the same shape as
    the arbiter's dropped-request deadlock already fixed in this repo: a request
    signal that IS the requester's own live condition.
    With a zero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
    [dcache.sv, koti_core.sv]
2026-08-08 fujprog -j flash does not work on this board, and the ESP32 is why
    This README carried `fujprog -j flash … # persistent` as a working alternative.
    It was documented and never run. Run on 2026-08-08: it fails.
    ⭐ ROOT CAUSE, observed rather than inferred. After a power cycle the serial
    port produced the ESP32's boot ROM log and a MicroPython v1.14 prompt, not
    koti. The ESP32 owns both the SPI flash and the FT231X serial line at power-on,
    which explains every symptom at once: the TDO mismatch during the JTAG write,
    `fujprog -i` reading IDCODE FFFFFFFF, `-z` claiming success while the write did
    not take, and static LEDs after the power cycle.
    ⚠️ koti's `wifi_en = 0` cannot help: it onl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
2026-08-08 The ESP32 route needs no passthru bitstream, and there is now a factory backup
    I claimed flashing the ESP32 would need a passthru bitstream so the FPGA could
    bridge the FT231X to the ESP32's UART and drive EN/GPIO0. Measured instead of
    assumed, and it is FALSE on this board: with the FPGA unconfigured, esptool
    talks to the ESP32 directly — detected ESP32-D0WD-V3 rev 3.1, MAC
    c8:85:41:c9:ce:f0, uploaded its stub flasher and ran it. Power-cycle, load no
    bitstream, and it just works. That was the expensive-looking blocker and it is
    not real.
    ⚠️ The FPGA must be UNCONFIGURED: koti drives wifi_en low, which disables the
    ESP32 outright. That is also why the serial port shows MicroPython aft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
2026-08-08 A resume point for standalone boot, and a safer plan than flashing the ESP32
    ⭐ THE PLAN CHANGED. The earlier one was "replace the factory MicroPython with
    EMARD's ULX3S build, which ships ecp5.py". That is more risk than the job needs:
    ecp5.py is PURE MicroPython — it bit-bangs the ECP5 config protocol over
    machine.Pin — so it needs to be a FILE on the filesystem, not a firmware.
    So: upload ecp5.py, upload the gzipped bitstream (308,806 bytes; uzlib is
    already on the stock image), add a main.py that configures the FPGA at boot.
    No firmware overwrite, nothing irreversible, and the failure mode is deleting
    three files rather than restoring 16 MB.
    The file carries what was measured toda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
2026-08-08 The ESP32 can drive this FPGA's JTAG; the factory MicroPython cannot
    Measured against the real board. ecp5.py uploads and imports on the stock
    firmware and ecp5.idcode() returns 0x41113043 = LFE5U-85F -- which needs all
    four of TMS/TCK/TDI/TDO correct, so it also settles the pinout. Upstream
    jtagpin.py ships the v3.0.x block active and this is a v3.1.8, where tms moves
    21 -> 5 and tdo moves 19 -> 34.
    But everything that reaches spi_jtag_on() -- so prog() and flash() both -- kills
    the stock MicroPython 1.14: one 0x00 byte, then a dead line, and progressively
    harder resets to recover. The blocker is the 2021 firmware, not the board and
    not ecp5.py.
    Two facts worth more than the failure: host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
2026-08-08 Correct the ESP32 diagnosis, and find why fujprog's flash write really fails
    Two corrections to the previous commit, both of which would have sent a future
    session the wrong way.
    1. "The blocker is the factory firmware" was wrong. Upstream's README heads its
    install section "micropython 1.14 (recommended)" -- the stock image is the
    recommended one, and 1.25 is the version where flashing is broken. What
    differs is WHICH ecp5.py: 1.14 pairs with the PyPI release (1.0.12), whose
    flash_read_block uses SoftSPI, where git master uses hardware SPI with an
    on-the-fly sck re-init. Master added acceleration on the exact path that
    killed this board. So: do not reflash the ESP32. That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
2026-08-08 The D-cache accepted a request during its own acknowledgement cycle
    `pending` clears on the same edge that sets `ack_q`, so for one cycle the
    cache looked idle while it was still presenting an answer -- and it accepted
    whatever the request port showed. What the port showed was the transaction
    that had just finished, because the requester had not seen the ack yet.
    arbiter3 never does this: its grant returns to G_NONE on the ack and it
    re-arbitrates the cycle AFTER, by which time the address has moved on. The
    whole SoC was written against that contract; the cache quietly broke it, and
    `!ack_q` in the accept condition is the contract put back.
    Only the page walker died of it. koti_core's M st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
    [dcache.sv, project.sv, sim_mem.sv, tb_dcache.v]
2026-08-08 The config flash is write-protected -- that is why nothing could ever write it
    status_reg = 0x18 -> BP=6, TBS=1, so 0x000000-0x1FFFFF is block-protected on the
    ISSI IS25LP128 (JEDEC 9D 60 18). koti's bitstream is 1,976,403 bytes and lives
    entirely inside that range.
    One fact, every failure:
    - fujprog -j flash dying on the post-erase status check (the erase is refused)
    - ecp5.flash() returning False after its three retries
    - both tools failing identically with the ESP32 in deep sleep
    - and this board never once booting from its own flash
    Three tool-level theories were investigated and all three were wrong: JTAG
    contention from the ESP32, the MicroPython version, and the ecp5.py vers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
2026-08-08 The flash write succeeded: koti runs from the ULX3S's own flash
    Clearing the block protection was the whole fix. Sequence, all from the ESP32:
    WREN, write status register 0x00, confirm BP==0 by re-reading before writing
    anything, then ecp5.flash("koti-bram.bit.gz").
    On COM3 with nothing driving the board:
    Koti-1: hello from my own SoC #507 ... 62 lines in a 45 s listen
    The counter was already at 507 when the listen began -- koti had been running
    unattended since LSC_REFRESH. The follow-up REPL read failed, which confirms it
    rather than spoiling it: koti holds the ESP32 in reset via wifi_en = 0, so the
    ESP32 goes silent exactly when the FPGA is alive.
    Two honest limits recorded with it.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
2026-08-08 Cold boot confirmed: koti is standalone
    Power pulled and restored with no bitstream loaded and nothing attached but 5 V:
    16 gapless banner lines, 0 non-printable bytes, counter #51 -> #66.
    The counter restarting low is what makes this a cold-boot proof rather than a
    restatement of the LSC_REFRESH result -- the pre-power-cycle run was at #580, so
    this is a fresh boot and not a session that never stopped. The ECP5 configured
    itself from its own flash at power-on.
    The ~60 s fujprog on every power-up is gone. Reflashing is now only needed to
    change the bitstream.
    Claude-Session: https://claude.ai/code/session_01Gy1XTjSMoLnrAC3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
2026-08-08 fujprog -j flash works once the flash is unprotected
    fujprog.exe -j flash koti-bram.bit -> Completed in 142.09 seconds.
    No TDO mismatch, no "Operation not permitted", no "Failed." Block protection was
    the only thing ever wrong with it, which retires the JTAG-contention,
    MicroPython-version and ecp5.py-version theories for good.
    So the standard way to update koti persistently is now one command, and the
    whole ESP32 / ecp5.py / MicroPython apparatus was scaffolding to find one
    status-register bit. Keep it only as the tool that can read and change flash
    protection.
    Recorded with it: the ESP32 is now locked out at power-on, because koti
    self-configures from flash in ~1 s and drives wifi_e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
2026-08-08 Standalone Linux: cold boot to a login prompt with no PC in the loop
    sbi bitstream in the config flash, SW3 on, microSD in, power pulled and
    restored, nothing loaded:
    [ 44.773161] Run /init as init process
    buildroot login:
    The board configures itself from its own flash, the SBI firmware transports the
    kernel off the microSD, and sv32 Linux reaches userspace on the 32 MB SDRAM.
    Two observations recorded with it. The network FAIL is expected -- there is no
    CONFIG_NET, that is ladder item 11. And the card probed read-only, where the
    rootfs rung wrote and read back files earlier the same day; first suspect is the
    mic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
2026-08-08 The read-only line is cosmetic, and the slider guess was wrong
    The card is writable. Its kernel was built 21:04:58 UTC, which is 2m26s after
    the write half landed (a235672) and 17 minutes before the stale log line was
    deleted (3b1dd30, "koti can save a file, and the log line should not say
    otherwise"). So that image has working writes and an obsolete dev_info.
    Retracting the explanation offered a commit ago: a microSD has no write-protect
    slider at all -- only full-size SD cards do -- so the card hardware could never
    have been the cause.
    Also confirmed on the board, both with the PC unplugged and running on a phone
    charger: the USB keyboard works (US2 port, USB HID host in fabric -> keyboa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
2026-08-08 Standalone is done; koti uses half its RAM and that is architectural
    Retires HANDOFF-standalone.md as a work order -- it is kept only so a session
    arriving from a stale pointer stops instead of re-running it -- and records the
    traps the work left behind: the ESP32 is locked out at power-on, HDMI has no
    hotplug detect, sbi needs SW3, ecp5wp's protect() is an OTP hazard, importing
    ecp5wp runs detect(), and JTAG-from-ESP32 must log to a file.
    New finding from the boot log: MemTotal is 8796 kB on a board with 32 MB, and
    the 16 MB limit is architectural rather than a devicetree typo. addr[22] is
    spent as the flash/RAM device select, so only addr[21:0] -- 4M words, 16 MB --
    reaches the SDRAM. sdr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
2026-08-08 An A/B needs the other half buildable, and a boot timed rather than watched
    The D-cache is enabled by KOTI_FPGA, so until now the only way to get the
    uncached half of a comparison onto the bench was to edit RTL -- which is how
    two variables end up in one experiment. fpga-ulx3s now takes a `defines`
    dispatch input, whitelisted to plain -DNAME tokens so a typo stops the build
    instead of quietly synthesising something else. Artifacts from a custom build
    are named -custom and carry a BUILDINFO.txt, because a bitstream is an opaque
    blob and the bench cannot tell two of them apart by looking.
    boottime.py times a boot two ways, and they fail differently. Host wall-clock
    from the first received byt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
    [boottime.py]
2026-08-08 TODO: double koti's RAM -- it uses 16 MB of the 32 MB on the board
    Found in the standalone boot log (MemTotal: 8796 kB) and it is architectural
    rather than a devicetree typo, so koti.dts is currently correct for the hardware
    as built.
    addr[22] is spent as the flash/RAM device select, so only addr[21:0] -- 4M
    words, 16 MB -- reaches the SDRAM. sdram_ctrl already takes a full 23-bit word
    address and drives the whole part; project.sv drops the top bit on the way in.
    The part, the controller and the pins are all fine; only the memory map is in
    the way.
    Recorded as ladder item 12 with what has to move together: the select scheme in
    project.sv (keeping the latched per-transaction sel_ram, whose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
2026-08-08 boottime.py flashes the arm it times, so the A/B is one command each
    SRAM, not -j flash: the config flash keeps the known-good standalone image, so
    a power cycle is the undo, and an arm costs ~10 s instead of ~142 s.
    Claude-Session: https://claude.ai/code/session_01Uv8EF3k6DwmEXneEvjQptv
2026-08-08 The D-cache runs on real SDRAM, and it is worth half what simulation said
    Controlled A/B on the ULX3S: same commit, same `image: sbi`, same `bram`
    variant, one variable (-DKOTI_NO_DCACHE), two runs per arm, SRAM loads so the
    config flash kept the known-good standalone image throughout.
    kernel time no cache 46.8252 / 46.8350 s
    D-cache 44.7331 / 44.7233 s -4.49%
    wall-clock no cache 83.41 / 83.50 s
    D-cache 80.09 / 79.80 s -4.21%
    CORRECT ON REAL HARDWARE, which is the half simulation could not do: both arms
    reach `buildroot login:`, all four boots print 4230 characters, 52 printks and
    0 non-printable bytes, and the logs are textually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
    [dcache.sv]
2026-08-08 +memlat=6, calibrated against the board rather than guessed
    The obvious value was 9, because sdram_ctrl's measured random 32-bit read is
    ~10 clocks. It was wrong by a factor of two on the only question anyone asked
    the model:
    +memlat=9 predicts 8.9% faster hardware measured 4.49%
    +memlat=6 predicts 4.47% faster hardware measured 4.49%
    ~10 clocks is the WORST case -- a random read that misses the open row -- and
    using a worst case as a flat average overstates what memory costs, which in
    turn overstates what any cache in front of it can win. From the CPU's side this
    machine behaves like a flat ~6-clock memory.
    So the model is calibrated rather than discredited, and that mat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
    [dcache.sv, sim_mem.sv]
2026-08-08 Stop spending an address bit on the device select: koti gets its other 16 MB
    MemTotal 8780 -> 25004 kB, MemFree 3296 -> 19452, userspace still reached.
    PLAN.md item 12.
    The core's word address was 23 bits with `addr[22]` doing double duty as the
    flash/RAM select, so only 4M words reached a part that holds 8M. The part, the
    controller and the pins were all fine; only the map was in the way. The bus is
    24 bits now (PA[25:2]) and the select is `a[23:22] != 00`:
    a[23:22] == 00 flash + MMIO 0x0000_0000..0x00FF_FFFF
    a[23:22] == 01 RAM low 0x0100_0000..0x01FF_FFFF
    a[23:22] == 10 RAM high 0x0200_0000..0x02FF_FFFF
    a[23:22] == 11 nothing, and koti_core faults i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
2026-08-08 The partial boot gate's clock budget was sized for half the memory
    `boot` went red on 236d169 with a boot log that was working perfectly: it
    stopped after "Mountpoint-cache hash table entries", four lines short of the
    `devtmpfs: initialized` grep. The full Verilator boot in the SAME workflow run
    reached userspace, which is what identified this as a budget rather than a
    defect -- a red gate and a green one disagreeing about the same commit.
    Measured rather than guessed. `devtmpfs: initialized` used to arrive inside 20M
    clocks; with 32 MB of RAM it arrives between 22M and 24M, because the kernel
    initialises twice the page structs before it gets there:
    maxclk=21M not seen maxclk=24M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
2026-08-08 32 MB confirmed on the board: eight clean memtest passes and MemTotal 25020 kB
    image: memtest with SW3 off walked the whole 32 MB eight times with an
    address-derived pattern, 0 errors and 0 non-printable bytes -- addrbits, the
    phase that reported "BIT 24 dead" before the change, now reports OK. Then
    image: sbi with SW3 on booted Linux to a login prompt reporting 25020 kB where
    it used to report 8796.
    Boot cost 0.65% (Run /init at 45.02 s against 44.73 s): the kernel initialises
    twice the page structs. That is the same cost that reddened the partial boot
    gate, fixed in the previous commit.
    Claude-Session: https://claude.ai/c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
2026-08-08 The README told a future session that a working command does not work
    fujprog -j flash has a whole section headed DOES NOT WORK ON THIS BOARD, with
    an ESP32-contention theory behind it. The cause was found later the same day --
    SPI flash block protection, BP=6 -- and the command has since been used three
    times, including for the 32 MB build in this session. The correction was added
    further down the file; the section header was not, so anyone reading top-down
    still meets the wrong answer first and takes an ESP32 detour that was proven
    unnecessary.
    Header corrected, the disproven diagnosis folded into a <details> block rather
    than deleted, and the memtest row updated to the 32 MB result.
    Co-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
2026-08-08 The standalone machine has the memory too, and a power cycle takes COM3 with it
    fujprog -j flash of the 32 MB sbi bitstream, 142.72 s, then power pulled and
    restored with nothing loaded over JTAG: MemTotal 25020 kB, MemFree 19424 kB,
    buildroot login:. koti now reports its real memory on a cold boot from its own
    config flash, not just under a volatile SRAM load.
    waitboot.py exists because the first attempt to capture that boot died with
    PermissionError: ClearCommError failed. The FT231X is bus-powered from the same
    USB as the board, so pulling power removes the serial device -- a capture that
    holds the port open across a power cycle cannot survive one, and the traceback
    looks like a broken t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
    [waitboot.py]
2026-08-08 The keyboard's two-port FIFO had no bench, including the property it exists for
    src/usb_kbd.sv was compiled only into whole-SoC builds. Those notice a keyboard
    that is completely dead and notice nothing at all about the second read port
    added for the Linux input driver -- so the guarantee the two-port design was
    built around was written in a comment and checked by nothing.
    Both properties are now tests, and both were proven able to fail:
    * two consumers, one stream. Pointing port 2 at port 1's read pointer -- the
    single-consumer bug the design exists to prevent -- fails five assertions,
    including "port2 still has the key port1 already took". On hardware that
    shape looks like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
    [tb_usb_kbd.v]
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2026-08-08 koticon owned the screen and nothing was writing to it: route printk to tty1
    The first hardware test of item 9b showed a BLANK monitor, and the driver was
    working the whole time. koticon probed, took the console and repointed the
    raster at its own page:
    [ 5.586781] Console: switching to mono koti 40x30 text 40x30
    [ 6.026346] koticon 40000.koticon: koti text console 40x30 at pa 0x01caa000
    ...but bootargs said `console=hvc0` and nothing else, so printk went to hvc0
    alone and tty1 never received a character. A 40x30 buffer full of spaces
    renders as a blank screen, which is indistinguishable from a broken driver and
    is in fact a correct one with nothing to show.
    `console=tty1 console=hvc0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
2026-08-08 A shell you would actually use: lowercase, a cursor, and a getty on the screen
    Three things stood between koticon and a terminal anyone would want, and all
    three were leftovers from an ASIC tile budget that no longer exists.
    LOWERCASE. vga_text folded 0x60+ onto 0x40+ and genfont.py emitted only
    0x20..0x5F -- "uppercase-only, C64 style", a die-area trade for an 8x2 tile.
    ⭐ The glyph art was there the whole time: FONT already carried all 96 glyphs
    and the GENERATOR was throwing half away. Verified before trusting it, by
    checking koti's existing 0x41/0x42/0x5F against dhepper/font8x8_basic --
    identical encoding, so the lowercase rows are the same font rather than a
    lookalike. 96 glyphs now,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
    [check_initramfs.py, genfont.py, koticon.c, vga_text.sv]
2026-08-08 The font ROM had no test, and it is generated, committed and read by two things
    src/font_rom.svh is produced by tools/genfont.py, committed, and consumed by
    src/vga_text.sv (scanned out in fabric) and tools/screenshot.py (which
    reconstructs the README's screens from it). Nothing checked any of that, which
    mattered the moment lowercase went in: it needed a fold deleted in the RTL AND
    a `continue` deleted in the generator, and doing either alone renders the wrong
    glyph while every existing test passes.
    test/test_font.py checks four things, and both mutations are caught by the
    check meant for them:
    * restoring the fold in the RTL only -> "screenshot.py's fold() agrees with
    vga_text.sv's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
    [genfont.py, screenshot.py, test_font.py]
2026-08-08 A parsing helper should not need an imaging library: move PIL into render()
    test/test_font.py went red in CI on the commit that added it, and the cause had
    nothing to do with fonts: tools/screenshot.py imported PIL at module scope, the
    `test` job has no Pillow, and the test imports screenshot for load_font() and
    fold(). Both are pure parsing of src/font_rom.svh and src/vga_text.sv.
    The fix is not to install Pillow in a job that has nothing to do with images.
    render() is the only function that draws anything, so the import lives there.
    ⚠️ Verified against an environment that genuinely lacks PIL, not against this
    host -- Pillow IS installed here, so the local PASS proved nothing about CI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
    [screenshot.py]
2026-08-08 Buildroot printed "Permission denied", exited 0, and made no initramfs
    sw/linux/post-build.sh was committed mode 100644. It was authored on Windows,
    where git records the executable bit only if told (`git update-index
    --chmod=+x`), and Buildroot's post-build hook executes the file directly:
    >>> Executing post-build script ../sw/linux/post-build.sh
    /bin/bash: line 1: ../sw/linux/post-build.sh: Permission denied
    ⚠️ AND `make` STILL EXITED 0. "Build the rootfs" reported success, rootfs.ext2
    was produced, and rootfs.cpio -- generated in target-finalize, after the hook --
    simply was not. The failure surfaced forty minutes later, in a step about
    whether koti can execute the binaries, a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
2026-08-08 Returning false from con_scroll does not mean "the VT will scroll for me"
    On the real monitor a login prompt and a kernel message shared one line:
    buildroot login: _otd fs, running e2fsck
    which is the getty's prompt, koticon's cursor, and the tail of "EXT2-fs
    (kotisd2): warning: mounting unchecked fs, running e2fsck is recommended" all
    written over the same row. Three of the four pieces were working -- the getty on
    tty1 runs, the cursor draws, lowercase renders -- and the screen simply never
    scrolled.
    MY ASSUMPTION WAS WRONG AND THE KERNEL SOURCE SAYS SO. vt.c's con_scroll()
    falls back to scr_memmovew on the VT's OWN buffer at vc_origin and then
    returns; it never asks the driver to re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
    [koticon.c]
2026-08-09 A full port 1 stalled the writer, so the console killed the keyboard
    On the bench the USB keyboard worked for a dozen or so keystrokes after boot
    and then died completely -- both consoles at once, permanently, and unplugging
    and replugging the keyboard did not revive it. The login prompt accepted `root`
    and the shell ran `echo hello`; some keystrokes later nothing reached tty1 or
    hvc0 ever again.
    THE CAUSE IS IN THIS FIFO AND THE BENCH NOW PROVES IT WITHOUT HARDWARE.
    `f_full` was computed against PORT 1's read pointer and gated the ENQUEUE:
    if (is_new(cand)) begin
    if (f_full) ovf <= 1'b1; // record it; do NOT overwrite
    so once port 1 held 8 unread entries the writer stopp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
    [tb_usb_kbd.v, ulx3s_top.sv, usb_kbd.sv]
2026-08-09 The HALTED lamp goes out exactly when you start needing it
    Today's debugging stalled on a question this board could not answer: when the
    machine stops responding, has the CPU stopped, or is it running and stuck above?
    I read LED1 as HALTED and concluded the core had hit EBREAK. That was WRONG, and
    src/project.sv says why:
    assign uo_out = vga_en ? uo_vga : {led[5:0], halted, uart_txd};
    The HALTED lamp exists ONLY IN HEADLESS MODE. The moment software enables the
    display -- which is how the HDMI console works at all -- uo[1] becomes a video
    bit and the lamp silently becomes a green pixel. So the one indicator that says
    "the processor stopped" is absent in precisely the configuration that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
    [project.sv, ulx3s_top.sv]
2026-08-09 Put the keyboard interrupt path on the lamps, and stop reading "executing" as "spinning"
    TWO CORRECTIONS FIRST, because both sent today's hunt sideways.
    `cpu_act` rolling means the CPU is EXECUTING. I read it as "the CPU is
    spinning", which does not follow: a healthy idle Linux fetches instructions
    too. The lamp separates halted / stalled / executing and nothing finer. On the
    strength of that misreading I went looking for a hang that was probably never
    happening.
    And Ctrl+Alt+Del failing is not independent evidence of a hang either. CAD is
    handled in drivers/tty/vt/keyboard.c, so it needs keystrokes to reach the VT --
    exactly the thing that is broken. Of course it did nothing.
    So the hone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
    [plic.sv, project.sv, ulx3s_top.sv]
2026-08-09 Count the keystrokes, because the levels read the same alive as dead
    The interrupt-path lamps came back all dark -- no stuck inflight, no stuck
    pending, no backed-up queue -- which kills the "claim without complete" wedge
    they were built to catch. Good, except those three bits were the wrong kind of
    signal and I should have seen it before spending a build: they are LEVELS, and
    on a healthy machine the driver drains within microseconds of the interrupt, so
    they read dark whether the path is working perfectly or producing nothing at
    all. An instrument that gives the same reading for both outcomes is not an
    instrument.
    Meanwhile the UART capture from that same run said far more than the lamps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
    [project.sv, ulx3s_top.sv, usb_kbd.sv]
2026-08-09 A sampling profiler that runs underneath Linux, because Linux can no longer tell us anything
    WHERE THIS BUG NOW STANDS, all measured on hardware today rather than inferred:
    keystrokes are produced (LED4:3 rolling), enqueued (LED6:5 rolling) and DRAINED
    (LED2 flickers under typing, so the ISR keeps running), and both consoles still
    go silent. So the USB core, usb_kbd, the FIFO, the PLIC and the keyboard driver
    are all doing their jobs, and the failure is above them in Linux. The death
    point is not a fixed count -- 28 characters one run, 46 the next -- so it is a
    race, not something filling up. That also clears koticon_scroll, which I had
    half-suspected: the first wrap-induced scroll happens a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
    [build.py, sbi.c]
2026-08-09 The machine was never hung: it is idle, and one stuck modifier bit would explain everything
    THE PROFILER SETTLED IT, and against my own expectation. After the keyboard
    "died", the samples are:
    c0035a74 arch_cpu_idle_enter
    c0035b1c do_idle
    c0035a8c arch_cpu_idle_exit
    c0260f44 default_idle_call
    c01e866c __hvc_poll
    000a9d1c <<USERSPACE>>
    koti is IDLE. Not wedged, not spinning, not livelocked -- sitting in do_idle
    with hvc still polling and userspace still being scheduled (4 of 110 samples
    were mpp=0). Every "hang" framing today, mine included, was wrong. The
    PREEMPT_NONE reasoning was sound and simply did not apply.
    So the real statement is much narrower: keystr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
    [sbi.c]
2026-08-09 Two usability items from the bench: a US keymap on the screen, and 40 columns
    Both raised by the user while testing on 2026-08-09, and neither is a bug in
    the sense the keyboard hunt is -- they are consequences of decisions that were
    made deliberately and are now being met in practice.
    11c. `-` types as `/`. HID usage 0x38 is "the key right of period": `/` on a US
    board, `-` on a Finnish one. What changed on 2026-08-08 is WHO maps position to
    character. It used to be sw/usbkbd.c's Finnish table, drawing the screen from
    the firmware; now koti_kbd.c reports a keycode and LINUX's keymap decides, and
    the kernel's built-in default is US. So the screen is US while hvc0 is still
    Finnish. That is i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
2026-08-09 Log the usage codes, the last thing both consoles could be dropping in common
    The stuck-modifier theory is dead. 88 samples across a run that died, every one
    of them st=00000100: typ=1, and the whole modifier byte ZERO. No stuck Ctrl, no
    stuck AltGr. That was the fourth hypothesis today to fail a measurement, after
    the FIFO stall, the PLIC wedge and the kernel hang.
    What the same run also showed, once the profiler's own output was untangled
    from the console line it interleaves with:
    ghhgkhkjkjlhkj
    lklkljhkhkjhkjlhkj
    about 32 characters echoed and then nothing, with the tail of the samples in
    default_idle_call and do_idle. So the machine is healthy and idle, th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
    [sbi.c, usbkbd.c]
2026-08-09 The scheduler must not be switchable off by one missed message
    koti lost its scheduler on 2026-08-09 and it looked, from every angle available
    at the time, like a dead keyboard. It was not. The M-mode timer stopped firing,
    so no tick ever reached Linux, so nothing was scheduled again -- while DEVICE
    interrupts kept waking the CPU out of wfi, so the keyboard ISR still ran and
    still drained its queue. Every hardware lamp read healthy because the hardware
    WAS healthy: keys arrived, were enqueued, were consumed. What died was time.
    THE PROOF IS THAT THE PROFILER WENT SILENT. It prints once a second from the
    M-timer trap, and across every run there are ZERO samples after the last typed
    character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
    [sbi.c]
2026-08-09 Let the machine report on its own processes while the bug is happening
    Where the keyboard bug stands after today: the kernel is healthy and ticking
    (74 profiler samples AFTER the failure, where before the timer fix there were
    zero), the keyboard ISR still drains its queue, keystrokes are still enqueued --
    and BOTH consoles stop showing characters, with init never respawning a getty
    (zero new login prompts in 74 seconds). Every hardware suspect was eliminated by
    measurement. What is left is that neither getty is reading its console.
    ⛔ NOT CONFIG_DETECT_HUNG_TASK, which was my first plan and would have wasted
    the build. It reports only tasks in UNINTERRUPTIBLE (D) sleep. A getty blocked
    on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
2026-08-09 Print the supervisor's interrupt state, which is the one thing Linux cannot report
    THE PROCESS WATCH ANSWERED, and not the way any of the three expected readings
    went. After the failure there are ZERO process dumps -- while the profiler keeps
    printing and the board keeps transmitting. The watch loop sits in `sleep 20`,
    which is a TIMEOUT, not an input wait. For that never to return, Linux's timers
    must have stopped waking tasks.
    So it is not "both gettys stopped reading". USERSPACE STOPS ENTIRELY: no dumps,
    no echo, every profiler sample mpp=1, and the CPU in do_idle because nothing is
    runnable and nothing ever becomes runnable again. Before the failure the same
    watch printed three clean du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
    [sbi.c]
2026-08-09 Make the old FIFO policy selectable, to test whether my own fix caused the storm
    The storm is measured: with a keyboard attached, SEIP goes pending and stays
    pending, and the kernel cycles through plic_handle_irq -> handle_irq_desc ->
    __radix_tree_lookup while no userspace task is ever scheduled. With NOTHING in
    US2, three minutes of clean uptime and SEIP never once pending.
    But the mechanism implicates a42bf4c, and it should be tested rather than
    defended. Before that commit:
    the writer STALLED once port 1 filled -- and port 1 stops being drained the
    moment nothing reads hvc0. A stalled writer lets port 2 drain to empty, which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
    [usb_kbd.sv]
2026-08-09 Bound the queue so a dead keyboard cannot take the machine with it, and measure the source
    Two things, both aimed at the same goal: koti should be a computer you can sit
    down and use, and no peripheral failure should be able to stop the machine.
    1. CONTAINMENT. stall-on-full is the SHIPPED policy again; drop-oldest becomes
    KOTI_KBD_DROP_OLDEST. This reverses a42bf4c's default on measurement, not
    opinion — same board, same kernel on the same card, same firmware, one define
    apart, after the keyboard died:
    drop-oldest stall-on-full
    process dumps after 0 2
    profiler samples after 74 150
    SEIP pending co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
    [koti.h, sbi.c, tb_usb_kbd.v, usb_kbd.sv]
2026-08-09 Put the FIFO pointers where the profiler already looks
    The producer is exonerated: `nq` (keystrokes offered) peaked at 33/s while the
    user typed and sat at ZERO afterwards, frozen at 0x32 while the machine was
    dead. No flood, no free-running core, no phantom keystrokes -- the prediction
    was thousands per second, it was stated with its falsifier, and the falsifier
    fired.
    What is left is the mirror image. With the producer idle, sip=00000220 stays
    pending for ever and sie=00000220 says SEIE is enabled, so !f_empty2 is still
    true: entries are sitting in the queue that nobody takes. A level-triggered line
    that never falls storms the kernel, which burns on dispatch and never schedules
    userspace.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
    [usb_kbd.sv]
2026-08-09 mip.SEIP: a read-modify-write was latching the PLIC's pin, and it wedged the machine
    ROOT CAUSE, and it accounts for every observation of the last day.
    The pointers told it. During a failure, with the producer provably idle:
    wptr rptr2 rptr nq sip
    6 6 14 70 00000220
    wptr == rptr2, so port 2 is EMPTY -- koti_kbd had drained it perfectly and
    kb_avail_irq was LOW. The PLIC had nothing to offer. And SEIP was still pending.
    A quiet device with a stuck interrupt puts the fault in neither of them.
    src/csr.sv read mip.SEIP as the OR of the PLIC pin and the software bit -- which
    is right for a READ -- and then fed that same value into the read-modify-write:
    12'h344: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
    [csr.sv]
2026-08-09 A regression test for the SEIP latch, proved against the RTL that had the bug
    Written after the fix, so the first thing it had to earn was the right to be
    believed: run against a pre-fix copy of csr.sv it fails on exactly the two
    assertions that describe the defect --
    FAIL SEIP CLEARS when the pin drops (the bug): got 1, want 0
    FAIL SEIP clears after a CSRRC too: got 1, want 0
    -- and passes on the fixed RTL. A test written to match the code it is testing
    proves nothing; this one was checked both ways.
    ⚠️ The failure is invisible to any test that only checks what mip READS, because
    the read was always correct -- the OR of the PLIC pin and the software bit is
    exactly what the sp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
    [tb_csr_seip.v]
2026-08-09 Put the SEIP test after the FIFO test, so each comment describes its own command
    The previous commit inserted it between tb_usb_kbd's comment and tb_usb_kbd's
    command, which left a paragraph about the keyboard's two-port FIFO sitting
    directly above an unrelated CSR test. Comments in this file are how the next
    person knows why a check exists; one attached to the wrong command is worse than
    none.
    Claude-Session: https://claude.ai/code/session_01Ai2ehE8UZSZHSqLjoBXdDq
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2026-08-09 Commit the rootfs without the debug loop, and normalise its line endings
    Artifact of `userspace` run 31323879094. Verified before committing: `procwatch`
    is gone from the archive, check_rootfs confirms the overlay matches the cpio
    byte for byte, and check_initramfs confirms koti can boot it.
    ⚠️ check_rootfs failed on the first attempt, and it was right to. S99koti was
    sitting in the working tree with CRLF endings while git stored it as LF, so CI
    built from LF and the local byte-for-byte compare against the cpio could never
    match. Normalised to LF rather than loosening the check — a comparison that
    tolerates line endings would also tolerate a genuinely different file, and this
    check ex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
2026-08-09 Restore drop-oldest: the containment it was traded for is no longer needed
    a42bf4c made the writer unable to stall, so a console nobody reads cannot kill
    the keyboard for the other consumer. That property is real and test 6b exists
    for it. It was demoted on 2026-08-09 because an A/B showed the shipped default
    turning "the keyboard dies" into "the machine dies", and containing the damage
    mattered more than the property while the cause was unknown.
    The cause is now known and fixed. It was never a keystroke flood: csr.sv's
    mip.SEIP read-modify-write latched the PLIC's pin, so the supervisor external
    interrupt never went away no matter what this FIFO did (def5699). Bounding the
    queue only ever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
    [tb_usb_kbd.v, usb_kbd.sv]
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2026-08-09 Actually update screenshot.py — the previous commit said it had and it had not
    08b44a7's message lists four places that had to agree on the new geometry and
    names tools/screenshot.py as one of them. Three were changed. The fourth edit
    threw on a docstring escape, the script exited before writing, and the commit
    went out anyway with a message describing work that did not happen.
    So screenshot.py really is 80x60 now: COLS/ROWS, the wrap-and-scroll docstring,
    the pixel-mapping note and the --help text. The one surviving "40x30" is the
    deliberate historical line saying what it used to be.
    ⚠️ Worth more than the fix: a commit message that describes an edit which is not
    in the commit is wo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
    [screenshot.py]
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2026-08-09 Generate the Finnish keymap in CI rather than writing one by hand
    koti's screen types a US layout -- `-` comes out as `/` -- because koti_kbd.c
    reports a KEYCODE and Linux decides the character, and the kernel's built-in
    keymap is US. HID usage 0x38 is "the key right of period", which is `/` on a US
    board and `-` on a Finnish one. That is PLAN item 9 working as designed; the
    keymap became changeable and has not been changed.
    ⛔ IT CANNOT SENSIBLY BE HAND-WRITTEN. busybox's `loadkmap` loads WHOLE TABLES,
    not individual keys, so the file must cover every keycode in plain, shift and
    AltGr -- not just the dozen that differ from US. Every mistake in it is a key
    that silently produces the wrong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
2026-08-09 Keep the hvc0 getty (user decision) and drop item 11b from the roadmap
    Reverted. The hvc0 getty stays, and PLAN item 11b — which proposed removing it —
    is gone from the ladder rather than left sitting there as a standing suggestion
    somebody acts on later.
    The reasoning that produced 11b was not wrong, it was incomplete. Removing it is
    right if you only weigh behaviour: nobody can type at hvc0 (koti's UART is
    transmit-only), so its shell exists solely to run every command a second time,
    on a shell that can diverge from the one you are looking at.
    What that weighing missed is that the getty is an INSTRUMENT. It echoes what it
    reads, and the firmware mirrors the keyboard queue to hvc0, so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
    [check_initramfs.py]
2026-08-09 Fix the keymap argument I put in the wrong place
    The keymap step's artifact line went into the check_rootfs.py INVOCATION rather
    than the upload list, because both blocks contain the line `buildroot-config.txt`
    and a single-count replace matched the first one:
    python3 sw/linux/check_rootfs.py \
    --cpio buildroot/output/images/rootfs.cpio \
    buildroot-config.txt
    koti-fi.bmap "${bins[@]}"
    so the checker was handed a file that does not exist at that point in the job --
    the keymap is generated later -- and exited 2 after printing its own docstring,
    which reads like an assertion failure and is not one. That failed the rootfs
    build, and the kernel build failed alongside it fo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
2026-08-09 Commit the keymap rootfs, and stop CRLF from faking a stale initramfs
    The rootfs artifact of `userspace` 31330169431, which carries /etc/koti-fi.bmap
    and the S99koti line that loads it. Verified before committing: the keymap is in
    the archive, check_rootfs passes, check_initramfs passes.
    ⚠️ IT FAILED FIRST, AND THE FAILURE WAS A LIE. check_initramfs reported
    sw/linux/buildroot_koti.fragment does not match what rootfs.provenance
    recorded. Re-run the `userspace` workflow, commit the new cpio...
    which describes a stale initramfs. Nothing was stale. rootfs.provenance records
    the sha256 of the fragment as CI built it -- LF -- and this Windows checkout has
    core.autocrlf, so the work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
2026-08-09 A UART receiver: koti can finally be told something
    src/ held uart_tx.sv and NO RECEIVER AT ALL. That one absence is behind a
    surprising amount of this project's history: the serial console is "transmit
    only" everywhere in the notes, hvc0 hosts a login prompt nobody can type at, a
    whole day of debugging could only watch, and there was no possible link to the
    onboard ESP32. koti could talk and could not listen.
    THREE THINGS IT HAS TO GET RIGHT, and each is a classic that passes a naive
    bench:
    THE LINE IS ASYNCHRONOUS. It is driven by an FTDI or an ESP32 with no phase
    relationship to our clock. Sampling it directly is a metastability bug that
    simulates perfectly and fails on hardware o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
    [run_fpga.py, tb_uart_rx.v, uart_rx.sv]
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2026-08-09 A clean screen after login, and a manual — on the machine and in the repo
    TWO TIDY-UPS, both about koti being usable rather than merely working.
    1. THE SCREEN CLEARS. /etc/issue clears before the login prompt and
    /etc/profile.d/10-koti.sh clears again on login, so the machine you sit down at
    starts empty instead of at the bottom of forty lines of kernel messages. On an
    80x60 screen that is most of the visible area.
    ⚠️ NOTHING IS LOST BY CLEARING: console=hvc0 means the full boot log is also
    on the serial line, so anything the screen wipes is still in a capture. On a
    machine whose only record was the screen this would be destroying evidence,
    and it is worth knowing which of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
2026-08-09 Commit the rootfs with the clean login and the on-machine manual
    Artifact of `userspace` 31334588421. Verified IN THE ARCHIVE rather than in the
    working tree, because what ships is the cpio:
    etc/issue mode 0644 52 bytes starts with ESC[ (clears)
    etc/profile.d/10-koti.sh mode 0644 1504 bytes
    usr/bin/koti-help mode 0755 2433 bytes
    The modes are the point. koti-help is EXEC'd so it must be 0755; 10-koti.sh is
    SOURCED by /etc/profile (`. $i`) so 0644 is correct and marking it executable
    would be cargo cult. This repo has already lost a build to the opposite mistake
    -- post-build.sh committed 644 when Buildroot needed to run it, which made
    Buildr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
2026-08-10 Tell the CPU benches about uart_rx, and tie its pin
    core-tests has been red since ca82da5 with
    src/koti_core.sv:1012: error: Unknown module type: uart_rx
    koti_core gained a uart_rx instance; test/run_fpga.py was told about the new
    file and test/run_cpu.py and test/run_riscv.py were not. Both build tb_cpu, so
    both died at elaboration — before a single test ran. Verified with CI's own
    iverilog 12 under WSL: the same command line now elaborates clean.
    ⚠️ THREE OF THE FOUR WORKFLOWS WERE GREEN THROUGHOUT. `test`, `linux` and
    `userspace` do not build tb_cpu, so the CPU and the whole official riscv-tests
    suite were simply not running while everything a human glances at said fine.
    And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
    [run_cpu.py, run_riscv.py, tb_cpu.v]
2026-08-10 The source-list guard did not cover the lists that broke
    test/check_sources.py exists because of two "Unknown module type" and "File not
    found" failures on 2026-08-08, and its docstring says so. Yesterday a third one
    of exactly that shape reddened core-tests for three consecutive pushes — and
    this check printed PASS on every one of them, because it only knew about
    fpga/ulx3s/sources.txt and test/run_fpga.py. run_cpu.py and run_riscv.py are
    source lists too and were never in it.
    ⛔ A GUARD THAT NAMES A FAILURE MODE AND DOES NOT COVER EVERY PLACE IT CAN
    HAPPEN IS THE FAILURE MODE. That is this project's signature defect wearing the
    costume of the tool written to prevent it.
    The CPU lists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
    [check_sources.py]
2026-08-10 The RAM bound test was still guarding the deleted PSRAM mirror
    test_psram_upper_bound_access_fault asserted that 0x0180_0000 access-faults as
    the APS6404's 8 MiB high mirror. PLAN item 12 (2026-08-08) made that address
    ordinary, legal RAM: the window is 0x0100_0000..0x02FF_FFFF and the bound moved
    to PA[25:24] == 11. The test has therefore been FAILING on every run for two
    days, in CI as well as locally, and reddened nothing — see the next commit.
    Rewritten to the bound that exists, and it now pins BOTH sides:
    0x02FF_FFFC last word of real RAM -> must NOT fault
    0x0300_0000 first word past the end -> store cause 7, load cause 5
    ⚠️ THE LEGAL SIDE IS THE HALF THAT MATTERS. Item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
    [test_cpu.py]
2026-08-10 No cocotb suite in this repo could fail its CI job
    Measured, not reasoned:
    $ python run_cpu.py ; echo $?
    ** TESTS=24 PASS=23 FAIL=1 SKIP=0 **
    0
    cocotb_tools.runner.Runner.test() runs the tests, writes results.xml, returns
    its path, and returns normally whether every test passed or every test failed.
    It has no raise-on-failure option; the intended check is a separate get_results()
    call, and not one of the four runners made it. So core-tests could only ever go
    red on a BUILD error, and the ULX3S harness step in `test` had the same hole.
    ⛔ TENTH INSTANCE OF THIS PROJECT'S SIGNATURE DEFECT, and the third of exactly
    this shape: tb_boot computed a verdict nothing read (2026-08-06)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
    [gate.py, run_core.py, run_cpu.py, run_fpga.py, run_riscv.py]
2026-08-10 Restore F1 coverage: flash must not alias into the MMIO window
    F1 lost its test when the ASIC cocotb suite was deleted on 2026-08-08. The fix
    stayed in koti_core.sv -- io_m = addr_m[31:16] == 16'h0001 -- with nothing to
    catch its removal, and PLAN.md has carried it as a real coverage gap since.
    The original defect compared only the low bits of the page number, so the MMIO
    window repeated every 512 KB: a load from 0x0009_080C read QSPI_CFG instead of
    the flash word living there. Flash holds all bare-metal code and the SBI
    firmware, so the failure is silent, data-dependent corruption of the boot path.
    Proven able to fail before being trusted, against the real defect restored in
    RTL (io_m = a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
    [test_cpu.py]
2026-08-10 The ULX3S harness has not run since 2026-08-08, and CI said green
    test_fpga.py opened with `from test import CS0, CS1, SCK, SD_BITS, UART_DIV,
    SpiMem`. Those lived in test/test.py until 603c9c9 deleted it with the ASIC
    apparatus on 2026-08-08. `test` is A REAL PACKAGE IN THE PYTHON STANDARD
    LIBRARY, so the import did not fail with "no module named" — it resolved to the
    stdlib and raised
    ImportError: cannot import name 'CS0' from 'test'
    (/opt/.../python3.11/test/__init__.py)
    ⇒ For two days nothing exercised the ULX3S harness: the J1 header wiring, the
    Pmod row permutation, the orientation straps or the UART source mux. It is the
    only bench that drives fpga/ulx3s/ulx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
    [spimem.py, test_fpga.py]
2026-08-10 Say which root koti booted, instead of asserting one of them
    docs/MANUAL.md stated flatly that / is the initramfs and told the reader to
    mount /dev/kotisd2 by hand. The DTS says root=/dev/kotisd2 rootfstype=ext2 rw.
    Both cannot be unconditionally true, and neither is: /init treats root= as a
    REQUEST -- missing card, unmountable p2, or no executable /sbin/init and it
    stays in RAM and says why, rather than panicking after discarding the
    initramfs. So the answer is card state, and it changes per boot.
    ⚠️ NOTHING IN THIS TREE CAN SETTLE IT, which is the point. tools/sdkernel.py
    writefs has to have been run on the card in the slot; the 2026-08-09 sessions
    ran `write`, which puts a KERNEL on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
2026-08-10 The keyboard FIFO policy was already right; its comments were not
    Nothing about the shipped behaviour changes here. Drop-oldest is already
    unconditional -- the define is KOTI_KBD_STALL_ON_FULL and it selects the OLD
    behaviour, the opposite way round from how the open item was written down. Both
    arms are pinned by tb_usb_kbd (40 keystrokes under the shipped policy, 8 under
    the diagnostic), verified locally in both builds, so neither can flip silently.
    What was wrong was the prose sitting next to the code, in two places, both
    still arguing from a cause that does not exist:
    src/usb_kbd.sv "Drop-oldest ... that level line never falls and the kernel
    cycles through the PLIC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
    [tb_usb_kbd.v, usb_kbd.sv]
2026-08-10 hvc0 can be typed at: console_getchar reads the UART receiver
    uart_rx.sv landed on 2026-08-09 wired to ftdi_txd, and nothing consumed it:
    SBI console_getchar still read only the USB keyboard FIFO, so koti's serial
    console remained one-way in practice. It reads both now, and a character typed
    on the PC reaches Linux through hvc0.
    ⚠️ EACH DEVICE IS TOUCHED EXACTLY ONCE PER CALL. Both reads POP -- usb_getchar()
    consumes a report slot, reading UART_RX consumes the byte -- so the UART is
    asked only after USB comes up empty. Asking both unconditionally would read a
    keystroke and throw it away, which is the same hazard USB_STAT exists to avoid
    on the keyboard side. The keyboard wins a tie beca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
    [sbi.c, tb_cpu.v, test_cpu.py]
2026-08-10 koti-status: ask the machine what it is, on the machine
    koti has no networking, so a diagnostic you can only run from another computer
    is one you cannot run. This prints, in one screen: model and kernel, uptime and
    load, the ISA and MMU string, the timebase, RAM as Linux manages it, WHICH ROOT
    it booted (with /init's own decision line), the card, the mounted filesystems,
    interrupts and the consoles.
    ⛔ THE RULE IT FOLLOWS: every number is either read from the machine or plainly
    marked as a compile-time constant. Nothing is inferred. A status tool that
    quietly prints a plausible wrong number is worse than one printing "unknown",
    because the wrong number gets believed and then quoted -- whic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
2026-08-10 The manual still said hvc0 could not be typed at
    My own change earlier today falsified it: uart_rx.sv gave koti a receiver and
    SBI console_getchar reads it, so hvc0 is two-way. But the firmware lives INSIDE
    THE BITSTREAM, so whether a given board can be typed at depends on which build
    is flashed, not on the kernel or the rootfs -- and every board in existence
    right now is still running an older one.
    Saying flatly "you can type at hvc0" would be as wrong as the sentence it
    replaces, in the other direction. The manual now names the boundary and says
    what to do about it, and records that this is simulation-verified only.
    Claud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
2026-08-10 A second serial port, wired to the ESP32 but not waking it
    The first piece of PLAN item 11. koti has no network stack and no MAC; the
    cheapest link it could ever have is the ESP32 already soldered to this board,
    reached over a UART on its own dedicated pins. src/esp_uart.sv is that port,
    at 0x0007_0000.
    ⛔ IT DOES NOT WAKE THE ESP32, AND THAT IS THE DESIGN. The control register
    resets to 0, so both straps are driven LOW out of reset -- bit for bit what
    ulx3s_top.sv hardwired before this existed. A board loaded with this bitstream
    behaves at power-on exactly as it did. What changes is that waking the chip is
    now a write software makes on purpose, and can undo in one more write.
    ⚠️ WHY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
    [esp_uart.sv, koti.h, koti_core.sv, project.sv, run_fpga.py, tb_boot.v, tb_esp_uart.v, tb_fpga.v]
2026-08-10 esptest: the image that answers whether the ESP32 can coexist with the card
    The bench session for PLAN item 11 is now one bitstream and one look at COM3.
    sw/esptest.c runs the experiment end to end rather than leaving a human to
    watch two things at once: read block 0 THREE times for a stable baseline (a
    flaky baseline makes the whole verdict meaningless), report ESP_CTRL with the
    chip still in reset, raise ESP_GPIO0 then ESP_EN in that order, listen on the
    link, re-read the card and compare, put the ESP32 back into reset, read a third
    time -- then print one VERDICT line: does the card survive, and if not, does it
    recover.
    ⚠️ EXPECT GARBAGE, NOT TEXT, IF THE LINK WORKS. An ESP32 leaving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
    [build.py, esptest.c, tb_fpga_bram.v]
2026-08-10 A fifth cocotb runner could not fail either, and I missed it this morning
    Found by auditing the WORKFLOWS for gates that pass when the evidence is
    absent, rather than by auditing the runners -- which is the whole lesson, since
    auditing the runners is exactly what missed it.
    test/run_sdram.py is a fifth cocotb runner. This morning's fix gated run_core,
    run_cpu, run_riscv and run_fpga and did not touch it, so for the rest of the
    day the SDRAM controller suite still exited 0 with failing tests. Its workflow
    gate was `! grep failure results_sdram.xml`, the exact twin of the line that
    hid the ULX3S harness not running at all for two days: when a run dies before
    writing the results file, grep exi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
    [check_sources.py, run_sdram.py]
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2026-08-10 Give the ESP32 link a real FIFO and an interrupt — a link cannot be polled
    Correcting a flaw in what I built earlier today. esp_uart.sv had a ONE-BYTE
    receive register and no interrupt, because I modelled it on the console
    receiver in koti_core, where M-mode firmware polls between keystrokes. That is
    fine for a human typing at ~10 bytes/s and useless for a link at 11520: a byte
    lands every 86.8 us at 115200, and a single dropped byte corrupts an entire
    SLIP or PPP frame, which is then retransmitted so it can happen again. It would
    have produced a link that "works" until anything else runs.
    Now a 64-byte FIFO -- about 5.5 ms of slack at 115200, a comfortable margin
    against interrupt latenc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
    [esp_uart.sv, project.sv, tb_esp_uart.v]
2026-08-10 The transmitter needs a FIFO too, and the reason is the driver not the wire
    Second correction to the link hardware, found while writing the Linux driver
    rather than after flashing it.
    Linux's serial core calls start_tx with the port lock held and interrupts
    DISABLED. With a one-byte transmitter the driver's only options there are to
    spin until each byte leaves -- 26 ms for a 300-byte SLIP frame, with interrupts
    off, which overflows the 64-byte receive FIFO four times over -- or to poll from
    a timer, which at 87 us per byte is an 11.5 kHz wakeup on a 25 MHz core that
    also runs a video DMA and a page-table walker. Neither is a working link.
    So: a 64-byte transmit FIFO, and the interrupt line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
    [esp_uart.sv, tb_esp_uart.v]
2026-08-10 Layer 2 and 3: a tty driver for the link, and a network stack to run on it
    sw/linux/koti_esp.c is a serial-core driver for src/esp_uart.sv, giving
    /dev/ttyKOTI0. That device node is the thing everything else needs: a LINE
    DISCIPLINE can only attach to a tty, so SLIP or PPP is impossible without it,
    and a userspace AT-command client can only open a device.
    ⛔ MAINLINE BINDS TO NOTHING HERE. Calling the DT node ns16550a to make it
    would be a lie ending in 8250.c poking registers that do not exist -- the same
    reason the keyboard needed koti_kbd.c and the screen needed koticon.c.
    ⚠️ THE DRIVER NEVER TOUCHES THE STRAPS. Bits 0-1 of the control register are
    esp_en and esp_gpio0, and the ESP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
    [koti_esp.c]
2026-08-10 Fix the driver's one compile error, and turn IPv6 off for real
    uart_port_tx() takes `ch` as the NAME of a variable it assigns into --
    `(ch) = __port->x_char;` inside the macro -- not as a value, so the caller must
    declare it. Every in-tree user does. Omitting it fails with "'ch' undeclared"
    pointing into serial_core.h, which reads like a kernel header problem and is
    not. That was the only error in the driver.
    ⛔ AND THE DEFCONFIG COMMENT WAS A LIE I WROTE THREE HOURS AGO. It said IPv6
    was "not enabled"; CONFIG_IPV6 defaults to y once NET is on, and the very build
    that failed had compiled the whole of net/ipv6 on the way. On a 25 MB machine
    that is real memory for a protocol koti cannot use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
    [koti_esp.c]
2026-08-11 The far end is MicroPython, not ESP-AT — so give koti a modem client
    PLAN item 11, the session board and this driver's own header all describe
    the ESP32 as running "stock ESP-AT", to be driven with AT+CWJAP and
    AT+CIPSTART. That is wrong for this board, and the evidence has been in
    fpga/ulx3s/README.md since 2026-08-08, read off the serial port after a
    power cycle:
    MicroPython v1.14 on 2021-02-02; ESP32 module (spiram) with ESP32
    >>>
    Stock MicroPython's `network` and `socket` modules ARE an AT command set,
    in a better language. Following the written plan would have meant erasing
    that firmware for a strictly weaker far end, and the SLIP route would have
    cost an ESP-IDF toolchain o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
    [koti_esp.c]
2026-08-11 The card survives an awake ESP32 — measured, 25/25
    `image: esptest` was run on the real board today, which is the measurement
    PLAN item 11 was gated on. 75 s on COM3, SRAM-loaded, SW3 off:
    1. microSD baseline: init OK, block 0 x3: stable ac230418
    2. link, ESP32 held in reset: ctrl=00000000 bytes=0
    4. link, ESP32 awake: bytes=74 73 20 4a 75 6c ... 477
    5. microSD with ESP32 AWAKE: ac230418 same
    6. microSD after ESP32 back in reset: ac230418 same
    VERDICT: the card SURVIVES an awake ESP32; link carried data
    25 consecutive passes agreed on every line. Line 2 read bytes=0 in all 25,
    which is what makes line 4 signal rather than noise. ⇒ networking and
    storage are no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
    [check_initramfs.py, koti_esp.c]
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2026-08-11 Rebuild sw/esptest.bin — the C was changed and the flashed image was not
    The previous commit edited sw/esptest.c and changed nothing on the board.
    `fpga-ulx3s.yaml` does not compile the firmware: it picks `bin="sw/$img.bin"`
    off disk, and those .bin files are COMMITTED ARTEFACTS. Measured the hard way
    — the new bitstream was built, flashed and captured, and step 4b was simply
    absent from all 11 passes.
    ⚠️ SO A FIRMWARE SOURCE EDIT NEEDS `python sw/build.py` AND THE .bin
    COMMITTED. Nothing in CI enforces that, and the failure is silent in the worst
    direction: the workflow goes green, the bitstream builds, the board runs the
    OLD firmware, and the only symptom is that the change you ma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
2026-08-11 A gate for the drift that just cost a flash cycle
    sw/*.bin are committed artefacts: fpga-ulx3s.yaml packs `sw/$img.bin` off
    disk and never runs the compiler. So a firmware source edit that is not
    followed by `python sw/build.py` produces a green CI run, a valid bitstream,
    and a board executing the OLD code — with the only symptom being that the
    change is not there, which reads like a hardware fault.
    sw/check_firmware.py records, per image, the sha256 of the .bin and of every
    source it was built from, and fails when a source has moved since. It runs
    first in core-tests because it needs no toolchain and takes no time.
    Hashes rather than a rebuild-and-compare on purpose: rebuilding in CI ne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
    [build.py, check_firmware.py]
2026-08-11 esptest 4b: step 4 was eating the bytes 4b existed to show
    4b printed "bytes=0" on the real board, which reads exactly like an ESP32
    that boots and then says nothing — the very failure it was added to detect.
    It is not that. esp_drain() POPS every byte and displays only the first 16,
    so step 4 had already read and discarded all 477 of them; 4b then listened
    for ten seconds to a far end that had finished talking before it started.
    An instrument that consumes the evidence it is asked to report is worse than
    no instrument, because its answer is confident and wrong in the direction
    that ends investigations.
    Step 4 now captures into the buffer instead, and prints the same first-16 hex
    and the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
    [esptest.c]
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2026-08-11 The harness read row 1 at 40 columns; the console has been 80 since 08-09
    test_harness_boot_mapping_a went red the moment sw/hello.bin was rebuilt, and
    my commit message for that rebuild said CI's hello benches were what would say
    if it was wrong. They said something more interesting: the rebuild is right and
    the TEST was wrong.
    sw/console.c has CHARBUF 0x01008000 and COLS 80, so row 1 is at base+80. The
    test read base+0x28 = base+40, which was correct when the console was 40
    columns and has been wrong since PLAN item 11d made it 80 on 2026-08-09.
    ⭐ It kept passing for two days because hello.bin was never rebuilt after that
    change either. A 40-column firmware and a 40-column test agreed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
    [test_fpga.py]
2026-08-11 Two bugs only hardware could show: EIO on every read, and the wrong sysfs node
    koti-net ran on the real machine for the first time tonight. Both defects it
    found are invisible to every gate this repo has, because nothing in simulation
    ever opens /dev/ttyKOTI0.
    1. EVERY READ RETURNED EIO, WITH THE ESP32 STILL IN RESET.
    # cat /dev/ttyKOTI0 > /tmp/x &
    cat: read error: I/O error
    serial_core's uart_port_startup() begins `if (uport->type == PORT_UNKNOWN)
    return 1;`, uart_startup() turns that non-zero into set_bit(TTY_IO_ERROR),
    and uart_port_activate() folds the positive return back into success. So
    open() succeeds, every read() gives EIO for ever, and ops->startup() i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
    [koti_esp.c]
2026-08-11 Write down the console trap, in the script and in the manual
    Waking the ESP32 makes the COM3 serial console unusable, and it is wiring
    rather than a fault: the FTDI's transmit line reaches both the FPGA and the
    ESP32's receiver, and the ESP32's transmitter shares the FTDI's receive line
    with the FPGA. A woken REPL therefore echoes your keystrokes onto the very
    wire koti transmits on.
    It presents as "waking the ESP32 crashed my machine". Measured tonight: the
    shell still echoed CRLF, so input was arriving fine, but no prompt rendered
    again until `koti-net off` ran, at which point it recovered instantly.
    ⇒ run koti-net at koti's own keyboard and HDMI screen, which share nothing
    with the ES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
2026-08-11 Pin the PORT_UNKNOWN defect, and be honest that a lint is not a test
    sw/linux/check_drivers.py fails if koti_esp.c ever sets uart_port.type to
    PORT_UNKNOWN again, or stops setting it at all (which is the same thing, since
    it defaults to 0). That construct made every read on /dev/ttyKOTI0 return EIO
    while open() succeeded and the probe banner still appeared in dmesg — found by
    hand on the bench, after a card write, a flash and a boot.
    ⚠️ It is a grep and it says so in its own header. It cannot tell whether the
    driver works; it can only tell that a known-wrong line is back. The real gate
    is a boot-time read of the device node, which needs an initramfs change, and
    that is deliberately NO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
    [check_drivers.py]
2026-08-11 The rootfs with the sysfs walk-up and the console trap written down
    Built by `userspace` run 31519716490 and verified with the same script `linux`
    runs. This is what makes `linux` green again — it has been red since koti-net
    changed, correctly, on exactly that.
    🪤 koti-status needed its line endings normalised first, and the trap is worth
    naming because I walked straight into the one this repo already documents. I
    patched that file with pathlib's write_text(), which translates '\n' to '\r\n'
    on Windows. Git stored LF (the path is pinned eol=lf in .gitattributes), the
    WORKING TREE kept CRLF, and check_initramfs.py compares working-tree bytes
    against the cpio — so it reported "koti-stat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
2026-08-11 Keep the WiFi password out of a world-readable file
    The far end is a REPL and a REPL echoes what it is told, so `join` puts
    w.connect('ssid','password') into /tmp/koti-net.cap in clear text — as the
    echo of the line this script sent. Nothing about that is visible from reading
    `join`, which is why the guard goes at the one place the capture is created
    rather than being remembered at each caller: the file is now made under
    umask 077, and `join` empties it on the way out on both paths.
    It is a tmpfs and dies at power-off. That is not a reason to leave a person's
    home WiFi password readable by anything else on the machine while it is on.
    The failure path deliberately does NOT dump the raw ca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
2026-08-11 koti-net wake: wait for the prompt, and make the timeout mean seconds
    Ran on the real machine. Two defects, both found by the script's own
    diagnostic doing its job — it reported 477 bytes captured and the link
    counter agreeing, which is what made the cause findable at all.
    1. IT WAITED FOR THE WRONG STRING. `expect 'MicroPython'` failed on a boot
    that had worked perfectly:
    entry 0x400806bc
    oicroPython v1.14 on 2021-02-02; ESP32 module (spiram) with ESP32
    One byte of the banner arrived corrupted. `>>>` two lines below it was
    intact, and `>>>` is what actually means "the REPL will accept typing" —
    the banner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
2026-08-11 Three koti-net defects that only a real machine could show
    All three were read as "the link is corrupting bytes" for most of an evening.
    None of them was.
    1. TWO READERS SPLIT THE STREAM. Two `cat /dev/ttyKOTI0` were live at once —
    a stale one and a fresh one — and two readers on one tty do not each get a
    copy, they take alternate bytes. Both appended to the same capture, giving
    >>> 'mport socket
    >> ot()
    s>> e
    which looks exactly like a failing UART or a bad wire. reader_start now
    sweeps for ANY process reading the device rather than trusting its own pid
    file, because a reader started by a previous session or by hand is
    invisible to `reader_runn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
2026-08-11 get: ask for the name while dialling the address, and stop eating the body
    Two fixes aimed squarely at the one thing koti has not done yet — put a page
    body on its own screen.
    1. `koti-net get URL [HOST]`. On 2026-08-11 koti fetched
    HTTP/1.1 302 Found
    Location: http://188.web.cern.ch/188
    from CERN by dialling 188.184.67.127 — a real reply from a real server,
    carrying their clock, over TCP. The 302 was CORRECT: dialling an address
    makes the request say `Host: 188.184.67.127`, and a virtual host rightly
    declines to serve info.cern.ch to that. The optional second argument
    connects to the address and asks for the name:
    koti-net get http://188.184.67.12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
2026-08-12 The rootfs carrying the koti-net that asks for a hostname
    Built by `userspace` run 31535547965 at 7631162, which is the commit that
    taught `cmd_get` to send a `Host:` the server recognises and to stop eating
    the first line of the body. The cpio committed alongside it was two koti-net
    edits old, so `check_initramfs.py` failed the `linux` workflow in under a
    minute and the kernel — including koti_esp.c's sysfs attributes, which have
    still never been compiled — was never built.
    Verified before committing: check_initramfs.py passes all checks including
    the byte-for-byte overlay comparison that was failing, check_firmware.py
    passes on all ten images, check_drivers.py is clean.
    Co-Authored-B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
2026-08-12 Let the radio come up before dialling, and stop losing markers to the wire
    Two defects, both found only by running the thing on hardware, and between
    them they are the whole of why koti could reach CERN on 2026-08-11 but not
    join a network on 2026-08-12.
    1. `join` dialled before the radio was up. `send` returns after 150 ms and
    `w.active(True)` only ASKS for the interface, so `w.connect()` landed while
    the ESP32's WiFi task was still starting. That does not fail loudly — the
    connect returns None like a good one and simply never associates, so the
    30-second wait expired and the script reported `address FAILED` about a
    network that was on the air with a password that was corr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
2026-08-12 Item 11 is done, and eight things the running machine was never asked
    Item 11 still said the far end "has never run on hardware" and that
    `image: esptest` "STILL GATES ALL OF IT and is still unrun". Both were
    overtaken — esptest ran 2026-08-11 with 25 unanimous passes, and koti fetched
    info.cern.ch on 2026-08-12. A work order that describes a solved problem sends
    the next session to solve it again, which is the same defect this project just
    finished cleaning out of CLAUDE.md.
    The new items 13-20 come from asking the booted machine questions nobody had
    asked it, and two of them are small enough to be embarrassing:
    # date
    Thu Jan 1 01:01:50 UTC 1970
    # mount | grep kotisd
    (nothing)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
2026-08-12 The housekeeper in three tiers, and the one that earns its own weights
    Items 24-26, from the user's question about a small self-built model on koti.
    The useful insight is that the two example questions want different machines:
    "what is in memory location x" is `devmem`, not intelligence — a neural net in
    front of it is slower and occasionally wrong — and "how do I do X" is retrieval
    over MANUAL.md, not generation. So item 24 is the whole housekeeper with no
    weights at all, and it is also the fallback the other two degrade to.
    25 is the one worth building. The model answers nothing: it maps a fuzzy
    question onto one of N intents and the intent runs a deterministic action from
    24, so a mi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
2026-08-12 The COM3 driver, so the next session does not rediscover it
    You cannot type a line at koti over the serial console. src/koti_core.sv:1025
    keeps the received byte in a SINGLE REGISTER with an overflow flag, and hvc0
    takes at most one character per poll, so `root\r` sent as one 5-byte burst at
    115200 self-overwrites inside 350 us: the CR survives, busybox getty sees an
    empty username and reprints the issue. Four sends, four reprints, zero echo,
    and nothing wrong with the link — it reads exactly like a console ignoring you.
    So this types one character at a time. It also paces on the ECHO rather than a
    fixed delay, because Linux's hvc poll interval is adaptive: 10 ms after it
    finds data, doub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
    [kdrive.py]
2026-08-12 A clock and a mounted card, and the first test that ever ran the rootfs shell
    PLAN items 13 and 14, both found by asking the running machine rather than by
    reading this tree, and both small enough to be embarrassing.
    13, the clock. koti answered `Thu Jan 1 01:01:50 UTC 1970` on a booted machine:
    no rtc node, no battery, no ntpd. The fix costs nothing because the time was
    already arriving and being discarded — every HTTP reply carries the server's
    clock, and the fetch that closed item 11 brought back a correct `Date:` header.
    `koti-net time` now sets the clock from it, and `get` does the same on its own
    while the clock is still unset, never afterwards, so browsing cannot move a
    clock that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
2026-08-12 The three small ones that make the machine stop lying to you
    PLAN items 15, 17 and 18, batched with 13/14 into one rootfs build. They are
    all shell, so doing them separately would have cost three more userspace runs
    and three more card shuffles for a total of about four hours of waiting.
    15, the applets that ship and cannot work. `ping` and `wget` are the first two
    commands anyone reaches for and neither can ever succeed — koti has no IP
    address, the ESP32 owns the TCP stack. They failed with `bad address`, which
    reads as "the network is broken" at the moment the network is working. They are
    now shell functions in profile.d that name the reason and print the three
    koti-net commands.
    Func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
    [check_rootfs.py]
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2026-08-12 Two defects found by attacking my own changes before the card did
    Neither was reachable by the tests as written, and both are the kind this
    project keeps finding: a wrong answer delivered confidently, and a feature that
    silently does nothing.
    koti peek 0xZZ did not print a koti: message. It died with
    koti: line 141: 0xZZ: value too great for base (error token is "0xZZ")
    because $(( )) does not RETURN an error for a malformed number, it aborts the
    shell — so `|| die` cannot catch it and there is no exit status to test. The
    `0x` prefix was checked and the digits after it were not. A command whose whole
    job is answering exactly must not fail in the voice of the shell it happens to
    be w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
2026-08-12 Fourteen binaries, not one: the size gate caught what no boot would have
    The rootfs build failed, and it failed correctly.
    rootfs.cpio 1.18 MiB -> 7.04 MiB (budget 2.50 MiB)
    BR2_PACKAGE_E2FSPROGS does not install e2fsck. It installs fourteen programs —
    e2fsck, mke2fs, tune2fs, badblocks, dumpe2fs, e2undo, e2freefrag, filefrag,
    logsave, mklost+found, e4crypt, chattr, lsattr, fsck — and with
    BR2_STATIC_LIBS=y every one carries its own copy of libc and libext2fs. The
    comment I wrote in the fragment predicted "a few hundred KiB for a static musl
    e2fsck" against 1.35 MiB of headroom. That was reasoning about a binary
    Buildroot never installs on its own, and it was wrong by an order o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
    [check_rootfs.py]
2026-08-12 Item 26 off the roadmap, and the one number that has to outlive it
    User directive: "remove the ternary 5M-param from the roadmap." Removed — not
    parked, not deferred. The housekeeper is two tiers now, 24 (no model) and 25
    (the intent classifier), and 25 is the end of that line rather than the middle
    of it. Every ordering that named 26 no longer does, in PLAN.md, the session
    board and the koti memory file, and /usr/bin/koti's own header no longer claims
    to be a fallback for it.
    ONE FIGURE IS KEPT, INSIDE THE NON-GOAL, AND DELETING IT WOULD HAVE BEEN A
    MISTAKE. The non-goal says a frontier LLM on koti is infeasible by four orders
    of magnitude, and that is true of a 0.5B model doing multipli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
2026-08-12 The gate that could not fail, and the budget it was hiding
    koti reaches userspace at 817,397,247 clocks. It is a budget, not a defect, and
    the card write is cleared.
    TWO STEPS IN ONE JOB DISAGREED ABOUT THEIR OWN DEFAULT:
    line 783 Boot Linux under Verilator FULL: inputs.full || 'yes'
    line 898 The bench's verdict, under Verilator FULL: inputs.full || 'no'
    On a push inputs.full is empty, so the run step booted the full 700M clocks to
    userspace and the verdict step then decided it had been a PARTIAL run, printed
    "INCOMPLETE is its expected outcome", and exited 0. workflow_dispatch defaults
    `full` to 'no' as well, so the only time this gate ever judged anything was a
    manual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
2026-08-12 All six on hardware, and the board had quietly travelled back in time
    Item 17's gate refuses on the real machine, item 27 is closed, and the batch is
    six for six.
    # koti-net repl
    koti-net: 'repl' has hung this machine before and is not
    koti-net: diagnosed (PLAN item 17). Use 'koti-net py' for
    koti-net: one-shot commands, which is what it is for.
    koti-net: If you really want it: koti-net repl -f
    ⛔ The gate is proven. THE HANG IS STILL NOT DIAGNOSED, and a passing refusal
    must not be read as a fixed bug.
    ITEM 27 WAS ONE CAUSE BEHIND TWO SYMPTOMS, AND NEITHER WAS A DEFECT. The board
    was running the bitstream flashed on 2026-08-08 for the standalone milestone.
    Two commit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
2026-08-12 Item 16: the keyboard is innocent, and the gateware said so all along
    Measured on hardware with the counters src/usb_kbd.sv already exposes and
    nobody had ever read. No code change, no rebuild — devmem over the console.
    # echo KOTI16-ALPHA <- 17 chars + Enter = 18 keypresses
    KOTI16-ALPHA
    enq_count 0x88 -> 0x9A = +18 exactly
    0x60004 0x00555100 -> wptr=10 rptr2=10 rptr=10
    18 offered, 18 counted, both readers level, conerr=0, nothing lapped. wptr 8→10
    is that same 18 wrapped in a 4-bit pointer over an 8-entry FIFO — 8+18=26, mod
    16 = 10, consistent to the digit.
    MY FIRST HYPOTHESIS WAS WRONG AND THE RTL REFUTES IT IN ITS OWN COMMENTS. I
    sai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
2026-08-12 Item 19 is not a DNS bug: -202 means "not on a network"
    Measured both directions on hardware:
    associated getaddrinfo("example.com",80) -> 104.20.23.154, first try
    not associated OSError -202, three times running, for the name AND for a
    variable holding a byte-perfect "example.com"
    The byte-sum is what makes the second line conclusive: the ESP32 reported
    len 11, sum 1113 for the hostname it held, matching example.com exactly. It was
    asked to resolve the right name and could not, because there was nothing to
    resolve against.
    AND THE MACHINE HAD BEEN SAYING SO ALL EVENING. One line nobody had run:
    print(w.isconnected(), w.status(), w.ifconfig())
    Fal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
2026-08-12 Item 19, actually solved: the link drops characters and -202 was telling the truth
    Captured with the ESP32 provably associated — True 1010 172.20.10.2 — so no
    excuses about the network this time:
    )='exmple.com' <- the 'a' of "example" is gone (10 chars, not 11)
    0='example.co' <- the 'm' is gone
    s.connect(socket.getaddrinfo(a,80)[0][-1])
    OSError: -202
    -202 was truthful the entire time. `exmple.com` really does not resolve. This
    item sat recorded as a DNS defect because the error was read before the
    variable was.
    The reason it looked so intermittent: a single `koti-net py 'a="example.com"'`
    arrives byte-perfect — the far end reported len 11, byte-sum 1113,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
2026-08-12 Check the connect too: its silent failure is what wedges the ESP32
    Measured tonight with the far end provably associated and the hostname
    provably intact (len 11, byte-sum 1113): the connect still did not establish,
    and nothing noticed. `s.send` then raised OSError 128 — ENOTCONN — and the read
    loop went on to block forever in recv() inside exec(), which is the wedge that
    ate two of this evening's attempts and swallowed commands typed at koti's own
    keyboard until the ESP32 was power-cycled.
    The evidence for WHY was also gone: the connect's traceback was erased by the
    next command's capture_reset before anyone could read it. So the failure was
    both silent and self-erasing, which is the w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
2026-08-12 Flow control in the transport: let the far end set the pace
    The fixed 150 ms delay in send() was budgeting the wrong thing, and its own
    comment said so: "at 115200 a 100-byte line is 8.7 ms on the wire; the 150 ms
    below is two orders of margin". Correct arithmetic about TRANSMISSION, and
    transmission was never the constraint. What has to finish before the next line
    is safe is the far end's EXECUTION — and s.connect() blocks for a DNS lookup
    plus a TCP handshake, hundreds of milliseconds to seconds. MicroPython 1.14 has
    no raw-paste flow control, so every byte sent during that window has to survive
    in the ESP32's UART buffer, and it does not.
    That is the root cause of item 19, and this is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
2026-08-13 `koti-net get` could not have worked: the connect check was two repl lines
    The connect guard added in 9feb791 builds its Python across two SOURCE lines,
    so `send` gets an argument containing a real 0x0A and `printf '%s\r\n'` puts
    it on the wire unchanged. The MicroPython repl is line-oriented, so it reads
    >>> c1="s.connect(socket.getaddrinfo(a,80)[0][-1])
    SyntaxError: unterminated string literal
    and then the same again for the second half. `c1` is never defined, `exec(c1)`
    raises NameError, the KOTI-CN marker never arrives, and `get` reports "could
    not connect" -- blaming the network for a quoting bug, on every fetch, by name
    or by address alike. This is the file that was about to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
    [check_initramfs.py]
2026-08-13 The flow control matched the PREVIOUS command's prompt and returned at once
    `send` waits for the far end to come back to `>>>` before writing another
    line -- that is the root-cause fix for the dropped characters, and it looked
    at the last 8 bytes of the whole capture. The previous command's prompt is
    still sitting in those bytes, so one echoed character was enough:
    capture: "import socket, sys\r\n>>> " then one byte "a"
    tail -c 8 -> "s>>> a" -> matches -> return 0
    So every send NOT immediately preceded by `capture_reset` returned in one
    250 ms tick no matter what the far end was doing -- the old fixed delay
    wearing the new function's name. `capture_reset` runs about once per com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
2026-08-13 Rebuild the initramfs on the two repl-protocol fixes
    Carries 26eba16 (the connect check was two repl lines, so `get` could never
    connect) and 5a6bb81 (the flow control matched the previous command's prompt
    and returned after one echoed character). Only koti-net's hash moves; it
    matches the working tree byte for byte and all 35 checks pass, including the
    new refusal of any send() argument spanning a newline.
    Claude-Session: https://claude.ai/code/session_017qDYsdN7NDfacWJRrdRumJ
2026-08-13 Make DNS work: the resolver DHCP hands over is an IPv6 address in a v4 slot
    Measured on hardware tonight, associated and healthy:
    w.ifconfig() -> ('172.20.10.2','255.255.255.240','172.20.10.1','254.128.0.0')
    254.128.0.0 is 0xFE 0x80 0x00 0x00 -- the first four bytes of fe80::, the IPv6
    link-local prefix. The iPhone advertises an IPv6 name server, and this ESP32's
    IPv4-only lwIP stores the leading four bytes of that v6 address in its v4
    resolver slot. Every lookup goes to a reserved Class-E address that cannot
    answer, and OSError -202 (host not found) is the honest reply.
    Nothing else was wrong. IPv4 routing worked the whole time, which is exactly
    why dialling info.cern.ch by ADDRESS s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
2026-08-13 send's deadline was shorter than the join it has to sit through
    `cmd_join` waits for association with a 60 x 0.5 s loop inside one exec, so a
    failed join occupies the far end for a full 30 seconds. `send` gave up at 25
    and announced a transport fault. Measured tonight driving the board over COM3
    with the hotspot asleep:
    koti-net: far end did not return to a prompt after: exec("for _ in
    range(60):\n if w.isconnected(): break\n time.sleep(0.5)")
    koti-net: address FAILED
    Nothing was wrong with the transport. A join taking its legitimate worst case
    made this layer invent a second error, print it FIRST, and blame the wire for
    a sleeping phone.
    40 s now: above the 30 s association l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
2026-08-13 The DNS repair has to be in the same exec as the connect, or DHCP undoes it
    Repairing at join time is not enough, measured on hardware tonight:
    join printed address 172.20.10.2 / resolver 172.20.10.1 (repaired)
    moments later ('172.20.10.2','255.255.255.240','172.20.10.1','254.128.0.0')
    The ESP32's DHCP client finishes its lease after `join` returns and restores
    the phone's IPv6-derived resolver. Address, netmask and gateway all survive --
    only the DNS field is put back, which is exactly why this read as an
    intermittent DNS fault rather than as a lease being reapplied.
    And one command earlier is not soon enough either: repairing in a separate
    `koti-net py` and then running `ge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
2026-08-13 ECONNRESET: DHCP reset the connection in the gap between connect and send
    `get` reached the far end and then died on the request itself:
    >>> s.send(('GET '+p+' HTTP/1.0...').encode())
    OSError: [Errno 104] ECONNRESET
    ECONNRESET, not -202 -- the name had resolved and the connect had SUCCEEDED,
    so this is further along than anything before it. The connection died in the
    seconds between the connect and the request, and `w.ifconfig()` read back at
    that moment showed 254.128.0.0 again: the DHCP client re-applies the lease,
    and reconfiguring the interface tears down the open connection.
    The first guess was ordering -- that creating the socket before the repair
    bound it to the old config.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
2026-08-14 Rebuild the initramfs with the one-exec transaction
    Carries abf2336, the ECONNRESET fix. Built by userspace 31744615752 at that
    SHA; only koti-net's hash moves (4b5562a0 -> 73938c89) and it matches the
    working tree byte for byte. All 35 checks pass locally, including the
    newline-in-send() check that abf2336 itself is the reason for.
    The card in the board still holds 4b5562a0, so this is the build the next
    write has to carry.
    Claude-Session: https://claude.ai/code/session_01FJ7ui86WM8om4CBw5cnUve
2026-08-14 The END marker's padding was being printed as part of every page
    `koti-net get` cut the page at `KOTI-END`, and the `zz` that pads that marker
    against the link's first-character fault sits at the START of the marker's
    line -- so it survived the cut and landed on the screen:
    </html>|
    |
    zz |
    |
    The padding arrived last night (25dfa7e) and no page has been fetched since,
    so nothing had seen it. The BEGIN marker never had the problem: its cut is
    `1s/.*KOTI-BEGIN//`, and a greedy `.*` takes the padding with it.
    The split now eats `[z ]*` ahead of the marker, and the page goes through a
    command substitution so the two trailing blank lines -- one from the
    deliberate `print()` befo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
    [fake_esp.py]
2026-08-14 Cover the network that is not a phone: a resolver that already works
    The DNS repair fires on `n==0 or n>=224`, which is a statement about the
    iPhone's fe80:: address landing in a v4 slot. Every scenario so far handed the
    far end that broken resolver, so nothing checked what the repair does when
    there is nothing to repair -- and koti on an ordinary router is the case where
    a repair written for a broken link can quietly break a working one.
    It leaves it alone: 0 repairs, the resolver still 172.20.10.1, page identical.
    Test-only, and deliberately so: neither file is under rootfs-overlay/, so the
    committed cpio stays valid and the userspace build already running at 0de411b
    is still the one the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
    [fake_esp.py]
2026-08-14 Rebuild the initramfs without the marker padding in the page
    Carries 0de411b. Built by userspace 31798289072 at that SHA; koti-net moves
    73938c89 -> d171a8b0 and matches the working tree byte for byte, everything
    else is identical, 35 checks pass.
    This is the build the card wants: the one in the machine is still 4b5562a0,
    which is two fixes behind -- it tears the connection down between the connect
    and the request, and it prints the END marker's padding into the page.
    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
2026-08-14 The page paid for the collision the marker's padding was meant to absorb
    koti fetched example.com by NAME three times this afternoon, and all three
    came back like this:
    'TTP/1.1 200 OK
    The marker padding worked exactly as designed -- `KOTI-BEGIN` arrived intact
    every time. But `print('zz','KOTI-BEGIN')` finishes transmitting and then
    `s.recv(256)` BLOCKS on the network, hundreds of milliseconds with the far end
    silent. Whatever it sends next opens a NEW burst, and the first character of
    every burst is destroyed. The sacrificial bytes were spent on the marker and
    the page then paid for the next collision with its own first byte.
    And not only the first byte: every recv that waits for an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
    [fake_esp.py]
2026-08-14 Item 19 is closed: koti fetches a page by name
    Confirmed by the user at koti's own keyboard, on the standalone machine, with
    the build written to the card this afternoon: `HTTP/1.1 200 OK`, first byte
    intact, nothing after </html>.
    The item is rewritten rather than ticked, because its premise was wrong twice
    over and both wrong versions are worth not re-running. It was never DNS and
    never koti: the iPhone advertises an IPv6 name server and the ESP32's
    IPv4-only lwIP keeps the first four bytes of fe80:: as its v4 resolver.
    Also recorded: the operational lesson that cost this afternoon. Dialling with
    the hotspot off wedges the STA machine at 1001 permanently, and disconnect
    plus an active(Fa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
2026-08-14 Make the sound audible: the bell in the kernel, notes in the shell
    The gateware from 709e22d could make a sound and nothing could ask it to.
    This is the part you can type at.
    sw/linux/koti_snd.c the terminal bell, an INPUT driver
    usr/bin/koti (play) notes, tunes and raw Hz, through /dev/mem
    sw/linux/koti.dtb rebuilt for the audio@80000 node
    WHY THE BELL IS AN INPUT DRIVER. Linux does not ring the bell through ALSA:
    kd_mksound() in drivers/tty/vt/keyboard.c sends EV_SND/SND_TONE through the
    input layer, which is why the PC speaker is drivers/input/misc/pcspkr.c. So
    binding there is what makes `printf '\a'` and a failed tab-completion audible
    with no userspace invol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
    [check_sources.py, koti_snd.c]
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2026-08-14 Rebuild the firmware, or the bitstream ships the OLD device tree
    check_firmware.py caught this and it was heading for the bench:
    FAIL sbi_test: koti.dtb has changed since sbi_test.bin was built, so the
    bitstream would flash firmware that does NOT contain that
    change
    The DTB is embedded in the SBI firmware, the firmware .bin files are committed
    build products, and the bitstream bakes them in. So adding audio@80000 to
    koti.dts and rebuilding koti.dtb was only two thirds of the change: the
    bitstream built at 5b344f5 is GREEN and carries fabric that can make a sound,
    firmware whose device tree has no sound in it, and therefore a kernel that
    would never bind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
2026-08-14 The README itself, which the commit before this one did not contain
    0da9b92 carried its message and one file rename. `git add -A README.md docs
    HANDOFF-standalone.md` matched nothing, because the git mv in the same session
    had already moved HANDOFF-standalone.md -- and git add stages NOTHING when a
    pathspec does not match. The error went to /dev/null, which is why a `git
    status` printed on the very next line, showing four unstaged files, was not
    read.
    So this is the content that message described: the rewritten README with the
    networking, sound, FPGA-utilisation and testing sections, the manual's Sound
    section and its two bench warnings, and both screenshots regenerated from
    captures taken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
2026-08-14 An I2C bus for the DS3231, and a D-cache defect found while adding it
    PLAN item 28 (28 and not 26: 26 is a retired number, and 27 is the flash
    write-protect fix). The user bought a DS3231 RTC module; this is the hardware
    half of giving koti a clock that survives being unplugged.
    src/i2c_bit.sv is ONE REGISTER: two open-drain drive bits out, two pin levels
    back, a spare INT/SQW input, and an ASCII "i2c" signature so `koti peek rtc`
    can tell "the block is in this bitstream" from "the read fell through to
    flash". There is no I2C state machine anywhere in fabric.
    That is the design decision, not an omission. Gateware ships inside the
    bitstream and costs a `fujprog -j flash` with the board on t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
    [check_mmio.py, check_pins.py, check_tristate.py, ds3231_model.sv, i2c_bit.sv, koti_core.sv, project.sv, run_fpga.py]
2026-08-14 Linux gets the clock: four callbacks, and mainline drives the DS3231
    ⭐ THE FIRST koti PERIPHERAL WHOSE DRIVER IS NOT KOTI'S. Every other one needed
    one written here, because a soft USB host is not an EHCI, the SD engine is not
    an SDHCI, the ESP32 link is not a 16550 and the text console is not fbcon. The
    DS3231 is a real Maxim part on a real I2C bus, so drivers/rtc/rtc-ds1307.c
    binds unmodified — "maxim,ds3231" is its own compatible string in 6.12, read
    out of its of_device_id table rather than remembered — and brings /dev/rtc0,
    hwclock, and RTC_HCTOSYS setting the system clock before userspace exists.
    koti's contribution stops at the bus.
    sw/linux/koti_i2c.c is that bus: setsda, sets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
    [check_config.py, check_drivers.py, koti_i2c.c]
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2026-08-14 Rebuild the DTB and the firmware, or the bitstream ships the old device tree
    The i2c@90000 node was in koti.dts and in nothing that runs. koti.dtb is a
    COMMITTED BLOB, and sw/sbi/dtb.S embeds it at flash 0x6000 — so the machine
    description Linux is handed lives inside the SBI firmware, inside the
    bitstream, and not in anything the kernel build produces.
    Both gates said so, which is the point of having them: `dtb` failed on "the
    committed blob still matches the source", and it uploads the fresh blob BEFORE
    comparing precisely so that the run which reports the staleness is the run you
    fetch it from. sw/check_firmware.py would have failed next.
    koti.dtb 2043 -> 2207 bytes; all three sbi_*.b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
2026-08-14 The manual said there is no RTC chip; say what is true instead
    docs/MANUAL.md's clock bullet opened with "There is no RTC chip and no NTP".
    Half of that stops being true the moment the DS3231 is plugged in, and a
    manual that is confidently wrong about the clock is worse than one that says
    nothing — so it now describes BOTH machines: with the module fitted (the
    kernel sets the clock before userspace, hwclock, i2cdetect, the die
    temperature through hwmon) and without it (koti-net time plus the fake
    hardware clock on the card, monotonic and not correct).
    ⚠️ And it says plainly that as of 2026-08-14 the part had not arrived, so
    nothing in the first half has been seen working. The README's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
    [koti_i2c.c]
2026-08-14 The module is not a Pmod, and a female socket needs male wire ends
    Two corrections to what the drawings and the README said, both of the kind
    that costs an evening at the bench rather than a rebuild.
    1. The caption said "four female-female jumper wires". That was written while
    thinking of pins on the board. The part being soldered is a FEMALE socket,
    which accepts MALE pins — so the end of each jumper that enters the board
    must be male, and with the male header most DS3231 boards carry, that makes
    them female-to-male. The caption now states the rule rather than a product:
    whatever end mates with the module, the end that enters this socket is
    male. Soldering a male header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
    [board_overlay.py]
2026-08-14 Rebuild the initramfs: the manual now knows about the clock
    Carries 9cad30f. Built by userspace 31833527433; `koti` (the peek map gains
    `rtc` at 0x00090000) and `koti-help` (a CLOCK section that no longer opens
    "koti has no battery and no clock chip") both match the working tree byte for
    byte, and check_initramfs.py's 35 checks pass.
    Spot-checked inside the archive rather than trusting the badge: `hwclock -w`,
    `i2cdetect -y 0`, `rtc|0x00090000`, `0x6932631F`, `temp1_input` and the new
    CLOCK keywords are all in the bytes that will be on the card.
    2479616 -> 2480640 bytes, which is the ~1 KB of extra help text and nothing
    else. No package changed, so the size budget is untouched.
    Co-Authore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
2026-08-15 The onboard clock runs, and SW3 decides whether you can hear anything
    The CR1225 went in, so the MCP7940N the board has always had is now worth
    talking to. On real hardware it answers at 0x6f on i2c-1, rtc-ds1307 binds
    unmodified, and the devicetree aliases node put it at rtc0 as intended.
    The chip's own status bits after one `hwclock -w`: ST=1 and OSCRUN=1, so the
    crystal is oscillating rather than merely configured, and VBATEN=1, which is
    the bit that decides whether the cell is used at all. PWRFAIL=0.
    Also records the trap that cost an hour getting here. ftdi_rxd is muxed by
    SW3, and the headless and VGA images want OPPOSITE positions -- so trying the
    other image does not disambiguate,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
2026-08-19 The front page still said no clock had run; one has, and it survived a power cut
    The README status table was written on 2026-08-14, when the CR1225 and the
    DS3231 module were both still to arrive, and it was never revised after the
    bench session the next evening. So the one page a visitor reads first claimed
    that neither RTC had run on hardware, while PLAN item 28 four hundred lines
    down already recorded the onboard MCP7940N answering at 0x6f, binding to
    rtc-ds1307 unmodified, and coming up as rtc0 through the aliases node.
    PLAN.md was stale in the other direction: it still listed persistence across a
    power cycle as unproven. That was the last open half of the claim and it was
    closed the sa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
2026-08-19 Put sdtest.c's comment back: a firmware source is not a place to tidy prose
    The previous commit rewrote one comment in sw/sdtest.c because it cited a
    bring-up guide that had just been deleted. sw/check_firmware.py hashes every
    firmware source against the .bin committed beside it, so a comment edit is
    indistinguishable from a code edit: the gate correctly reported that sdtest.bin
    no longer matches sdtest.c and that flashing the bitstream would install
    firmware without the change. It went red in 23 seconds, which is the gate doing
    exactly what it was written to do.
    Rebuilding the binary to fix a comment would be the wrong trade, so the comment
    goes back as it was. That also restores the rule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
    [sdtest.c]
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2026-08-20 Stop building the debris: check the sends, verify the program, un-wedge the far end
    76aa36a made the 2026-08-19 symptom harmless -- extract_page takes the LAST
    marker pair, so debris in front of a page no longer becomes the page. It said
    plainly what it did not do: "What put a dead transaction in the capture in the
    first place is still open." This is that.
    Three holes, and they are the same hole seen from three sides.
    1. NOT ONE `send` IN cmd_get HAD ITS STATUS LOOKED AT. `send` returns 1 when
    the far end never came back to a prompt, and every caller ignored it and
    sent the next line anyway. The far end is a separate machine: it does not
    stop executing because this side stopped li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
    [fake_esp.py]
2026-08-20 Check the userspace inside the Image, not just the cpio on the way in
    check_initramfs.py compares sw/linux/rootfs-overlay against the committed
    sw/linux/rootfs.cpio, and it is a good check -- it caught this very push, with
    "koti-net has changed since rootfs.cpio was built". But it checks an INPUT.
    Nothing checked the OUTPUT. The kernel Image is the file that goes on the
    microSD; kbuild links the initramfs into it from CONFIG_INITRAMFS_SOURCE; and
    between those two facts sat a step with no gate on it at all. Every other check
    in this job passes on an Image carrying an empty initramfs or the wrong one --
    header magic, size, System.map -- because not one of them looks inside. The
    `initramfs: i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
    [check_image_initramfs.py]
2026-08-20 Rebuild the initramfs: the fetch program is now checked before it is run
    Run 32380295115 at 0f32fc9. The rebuild changes exactly one overlay file and
    the provenance says so:
    usr/bin/koti-net 017f2a12ce1e70d2 -> 2af060b8c8c4e2ef
    Every other hash in rootfs.provenance is unchanged, which is the shape a
    surgical rebuild should have and the reason to read it rather than trust the
    run. cpio 2483200 -> 2496000 bytes.
    This is the step that puts the fix ON THE MACHINE. The three fixes in 0f32fc9
    live in the initramfs, so until this is committed and a kernel is built around
    it, standalone can still print debris in place of a page -- the code being
    right in the repo does nothing for a machine b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
2026-08-20 Keep every REPL line inside koti's 64-byte receive FIFO
    THE FETCH DIED AT THE FIRST LINE THAT DID NOT FIT, AND THAT IS NOT A COINCIDENCE.
    On the first standalone run after the marker fix, `koti-net get` stopped with
    far end did not return to a prompt after: req=('GET '+p+' HTTP/1.0\r\n...
    and the screen showed the echo coming back with a quote gone from `+p+' HTTP`.
    Every line the fetch had sent before it arrived intact. Their echoes were 16,
    16, 26, 46 and 12 bytes. `req=` echoes 85.
    koti's RX FIFO is 64 bytes -- KOTI_ESP_FIFO in the driver, TXDEPTH in
    esp_uart.sv -- which is 5.56 ms of wire at 115200. The far end ECHOES every
    character it is sent, so a line of n bytes comes back as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
    [check_initramfs.py, fake_esp.py]
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
